ultrazohm/uz_d_inverter/Bestellliste_Mouser.xlsx

Bestellliste bei Mouser
 |  |  | Anzahl Boards
 |  |  | 15
Bauteilnummer | Beschreibung | Anzahl pro Board | Anzahl insgesamt | Kommentar | Kosten pro Bauteil: | Kosten pro Board: |  | Eingetroffen:
581-1206DD106MAT2A | Capacitor 1206, 35 VDC, 10 µF, X5R | 1 | 15 |  | 0.29 € | 0.29 € | 4.35 € | JA
80-C0603C105K3RLR | Capacitor 0603, 25 VDC, 1 µF, X7R | 1 | 15 |  | 0.28 € | 0.28 € | 4.20 € | JA
80-C0603C104J3RE7411 | Capacitor 0603, 25 VDC, 0.1 µF, X7R | 17 | 255 |  | 0.26 € | 4.42 € | 66.30 € | JA
187-CL10C560JB8NNNC | Capacitor 0603, 50 VDC, 56 pF, C0G | 16 | 240 |  | 0.10 € | 1.60 € | 24.00 € | JA
80-C0805C472F1GEAULR | Capacitor 0805, 100 VDC, 4.7 nF, C0G | 4 | 60 |  | 1.39 € | 5.56 € | 83.40 € | JA
80-C0805C332F1G | Capacitor 0805, 100 VDC, 3.3 nF, C0G | 4 | 60 |  | 2.64 € | 10.56 € | 158.40 € | JA
80-C0805C103K3R | Capacitor 0805, 25 VDC, 0.01 µF, X7R | 6 | 90 |  | 0.23 € | 1.38 € | 20.70 € | JA
80-C603C104K5RAC3121 | Capacitor 0603, 50 VDC, 100nF, X7R | 16 | 240 |  | 0.13 € | 2.08 € | 31.20 € | JA
710-885012206065 | Capacitor 0603, 25 VDC, 10 nF, X7R | 7 | 105 | Wurden ausversehen 240 bestellt | 0.10 € | 0.70 € | 10.50 € | JA
667-EEV-FK2A470V | 13.8 x 12.5 x 3.8mm, 100 VDC, 47µF | 10 | 150 |  | 2.94 € | 29.40 € | 441.00 € | JA
810-C2012X7R475K125C | Capacitor 0805, 50 VDC, 4.7 µF, X7R | 12 | 180 |  | 0.57 € | 6.84 € | 102.60 € | JA
810-C1608X5R1E225K | Capacitor 0603, 25 VDC, 2.2 uF, X5R | 6 | 90 |  | 0.19 € | 1.14 € | 17.10 € | JA
187-CL10B473KB8NNNC | Capacitor 0603, 50 VDC, 47 nF, X7R | 18 | 270 |  | 0.10 € | 1.80 € | 27.00 € | JA
710-150060BS84000 | WL-SMCW SMD Mono-color Chip LED Waterclear Blue | 1 | 15 |  | 0.45 € | 0.45 € | 6.75 € | JA
710-150060GS84000 | WL-SMCW SMD Mono-color Chip LED Waterclear Green | 1 | 15 |  | 0.45 € | 0.45 € | 6.75 € | JA
710-150060RS86000 | WL-SMCW SMD Mono-color Chip LED Waterclear Red | 1 | 15 |  | 0.45 € | 0.45 € | 6.75 € | JA
595-REF4132B25DBVRQ1 | Voltage Reference, 2.5V, ±0.05%, ±10mA | 1 | 15 |  | 3.72 € | 3.72 € | 55.80 € | JA
595-LMP8481MM-T/NOPB | Current Sense Amplifier, 4-76 V CMV, 20 V/V, bidirectional | 3 | 45 |  | 3.57 € | 10.71 € | 160.65 € | JA
584-ADA4940-1ARZ | Fully Differential Amplifier, Ultralow-Power,Low Distortion, 260-MHz | 8 | 120 |  | 5.14 € | 41.12 € | 616.80 € | JA
926-LM57CISD-10/NOPB | Board Mount Temperature Sensor, -50 - 150°C | 6 | 90 |  | 2.76 € | 16.56 € | 248.40 € | JA
584-6992HS64WTRMPBF | Switching Controllers PWM with 5% to 100% Pulse Width Control | 6 | 90 | 1500 Stück sind ab Oktober verfügbar. Vorbestellen den Artikel dann. | 6.81 € | 40.86 € | 612.90 €
595-INA185A1IDRLR | Current Sense Amplifier, 0-26 V CMV, 20 V/V, bidirectional | 1 | 15 |  | 1.61 € | 1.61 € | 24.15 € | JA
595-SN74LVC2G14DBVT | Dual Schmitt Trigger Inverter | 1 | 15 |  | 1.32 € | 1.32 € | 19.80 €
710-634008149821 | CAT5, RJ45 Connector, 1 port SMD | 2 | 30 |  | 8.22 € | 16.44 € | 246.60 € | JA
571-4-103327-3 | Pin Header, 2.54mm, 1 Pin | 6 | 90 |  | 0.25 € | 1.50 € | 22.50 € | JA
81-LQM18DN6R8M70L | 6.8µH, 120mA, 0603, 740mOhm, 20% | 6 | 90 |  | 0.14 € | 0.84 € | 12.60 € | JA
490-PDSE1-S24-S12MTR | Isolated, 21.6 -26.4Vin, 12V out, 1W, 84mA out | 6 | 90 |  | 3.67 € | 22.02 € | 330.30 € | JA
603-RC0603JR-070RL | SMD resistor E24 series | 3 | 45 |  | 0.10 € | 0.30 € | 4.50 € | JA
660-RK73B1JTTDD102J | SMD resistor E24 series, SMD resistor 0.1% | 17 | 255 |  | 0.10 € | 1.70 € | 25.50 € | JA
660-RK73B1JTTDD202J | SMD resistor E24 series, SMD resistor 0.1% | 17 | 255 |  | 0.10 € | 1.70 € | 25.50 € | JA
660-RK73B1JTTD201J | SMD resistor E24 series | 1 | 15 |  | 0.10 € | 0.10 € | 1.50 € | JA
660-RK73B1JTTD101J | SMD resistor E24 series | 1 | 15 |  | 0.10 € | 0.10 € | 1.50 € | JA
603-PU3921FKMP50R002 | Shunt resistor 2mOhm, 5W, 1% | 4 | 60 |  | 1.60 € | 6.40 € | 96.00 € | JA
660-RK73H1JTTD49R9F | SMD resistor 1% | 20 | 300 |  | 0.10 € | 2.00 € | 30.00 € | JA
603-RT0603BRD0751R1L | SMD resistor 0.1% | 5 | 75 |  | 0.38 € | 1.90 € | 28.50 € | JA
603-RT0603BRD0725R2L | SMD resistor 0.1% | 4 | 60 |  | 0.42 € | 1.68 € | 25.20 € | JA
279-RQ73C1J10KBTD | SMD resistor 0.1%, 10ppm | 4 | 60 |  | 0.69 € | 2.76 € | 41.40 € | JA
279-RQ73C1J110KBTD | SMD resistor 0.1%, 10ppm | 4 | 60 |  | 0.81 € | 3.24 € | 48.60 € | JA
660-RK73B1JTTD103J | SMD resistor E24 series | 18 | 270 |  | 0.10 € | 1.80 € | 27.00 € | JA
660-RK73B1JTTD203J | SMD resistor E24 series | 6 | 90 |  | 0.10 € | 0.60 € | 9.00 € | JA
652-CR0603-FX1053ELF | SMD resistor 1%, 50V, 100ppm | 6 | 90 |  | 0.10 € | 0.60 € | 9.00 € | JA
652-CR0603-FX2803ELF | SMD resistor 1%, 50V, 100ppm | 6 | 90 |  | 0.10 € | 0.60 € | 9.00 € | JA
667-ERJ-6ENF2873V | SMD resistor 1%,150 V, 100ppm | 6 | 90 |  | 0.10 € | 0.60 € | 9.00 € | JA
652-CR0603FX-9763ELF | SMD resistor 1%, 50V, 100ppm | 6 | 90 |  | 0.10 € | 0.60 € | 9.00 € | JA
652-CR0603FX-1823ELF | SMD resistor 1%, 50V, 100ppm | 6 | 90 |  | 0.10 € | 0.60 € | 9.00 € | JA
660-RK73B1JTTD100J | SMD resistor E24 series | 2 | 30 |  | 0.10 € | 0.20 € | 3.00 € | JA
594-MMA02040E1009DB3 | SMD MELF resistor, 0.5%, 200V, 15ppm | 12 | 180 |  | 0.65 € | 7.80 € | 117.00 € | JA
 |  |  |  |  |  | Preis pro Board | Preis insgesamt
 |  |  |  |  |  | 259.38 € | 3890.70 €
