ultrazohm/uz_d_inverter/Bestellliste_Farnell.xlsx

Bestellliste bei Farnell
 |  |  | Anzahl Boards
 |  |  | 15
Bauteilnummer | Beschreibung | Anzahl pro Board | Anzahl insgesamt | Kommentar | Kosten pro Bauteil: | Kosten pro Board:
FCR7350R | FCR7350B, 1000V, 24A, RED | 1 | 15 |  | 5.40 € | 5.40 € | 81.00 €
FCR7350L | FCR7350B, 1000V, 24A, BLUE | 1 | 15 |  | 5.40 € | 5.40 € | 81.00 €
FCR7350B | FCR7350B, 1000V, 24A, BLACK | 3 | 45 |  | 5.40 € | 16.20 € | 243.00 €
 |  |  |  |  |  | Preis pro Board | Preis insgesamt
 |  |  |  |  |  | 27.00 € | 405.00 €
