ultrazohm/uz_d_inverter/Project Outputs for UZ_D_Inverter/Rev04/BOM/BOM_UZ_D_Inverter_Variant_V1_Rev04_ordering_overview.xlsx

Comment | Designator | Footprint | LCSC Part Number | Manufacturer Part Number | replaced with:
100 nF | C1, C2, C3A, C3B, C3C, C4, C6A, C6B, C6C, C17A, C17B, C17C, C19A, C19B, C19C, C20A, C20B, C20C, C22A, C22B, C22C, C23A, C23B, C23C, C24A, C24B, C24C, C57, C58, C59, C66A, C66B, C66C, C67A, C67B, C67C, C68A, C68B, C68C, C69A, C69B, C69C, C72A, C72B, C72C, C73A, C73B, C73C, C80, C80A, C80B, C80C, C82A, C82B, C82C, C83A, C83B, C83C, C84, C99 | C_0603 | C343025 | C1608X7S2A104KT000N
2.2 uF | C7, C64A, C64B, C64C, C65A, C65B, C65C | C_0603 | C2929194 | C1608X5R1E225K080AB
10 µF | C8, C81, C82, C83, C85, C86, C87, C88, C89, C90, C91, C92, C93, C94, C95, C96 | C_1210_N | C576517 | GRM32EC72A106KE05L
56 pF | C11A, C11B, C11C, C12A, C12B, C12C, C15A, C15B, C15C, C16A, C16B, C16C, C50, C51, C55, C56 | C_0603 | C39148 | CL10C560JB8NNNC
0.01 µF | C14A, C14B, C14C, C54 | C_0805 | C2691724 | HV0805X7R103K101NT | 08051C103J4Z2A | GlobalSourcing | nope
10nF | C18A, C18B, C18C, C21A, C21B, C21C, C25A, C25B, C25C, C26A, C26B, C26C | C_0603 | C136131 | CT41G-0603-2X1-50V-0.01μF-K(N)
110 µF | C40, C41, C42, C43, C44, C45, C46, C47 | CAPAE1300X1400N | C2163387 | EMHS101ARA111MKE0S
4.7 µF | C60A, C60B, C60C, C61A, C61B, C61C, C62A, C62B, C62C, C63A, C63B, C63C | C_0805 | C437557 | GRM21BZ71H475KE15L
150060BS84000 | D1 | WL-SMCW_0603 | C5197644 | 150060BS84000
150060GS84000 | D2 | WL-SMCW_0603 | C84267 | 150060GS84000
150060RS86000 | D3 | WL-SMCW_0603 | C389517 | 150060RS86000
BAT165E6327HTSA1 | DOFF_1A, DOFF_1B, DOFF_1C, DOFF_2A, DOFF_2B, DOFF_2C | SOD2513X110N |  | BAT165E6327HTSA1 | BAT165E6327 | C151511
MINIASMDC110F_24-2 | F1, F2, F3 | MINIASMDC260F162 | C70119 | MINIASMDC110F/24-2
6339160-1 | J1, J2 | 634008149821 | C125076 | 6339160-1
FCR7350R, PCB mount 4mm jack, RED | J3 | FCR7350 | C7437326 | FCR7350R
FCR7350L, PCB mount 4mm jack, BLUE | J4 | FCR7350 | C7190856 | FCR7350L
FCR7350B, PCB mount 4mm jack, BLACK | J5, J6, J7 | FCR7350 | C7437327 | FCR7350B
LQM18DN6R8M70L | L1A, L1B, L1C, L2A, L2B, L2C, L3A, L3B, L3C, L4A, L4B, L4C, L5A, L5B, L5C, L6, L7, L8, L9A, L9B, L9C, L10A, L10B, L10C, L12 | INDC1608X95N | C1881372 | LQM18DN6R8M70L
PDSE1-S24-S12-M-TR | PS1A, PS1B, PS1C, PS2A, PS2B, PS2C | PDSE1S24S12MTR | C6730719 | PDSE1-S24-S12-M-TR |  |  | nope
ISC060N10NM6ATMA1 | Q1A, Q1B, Q1C, Q2A, Q2B, Q2C | ISC060N10NM6ATMA1 | C3288847 | ISC060N10NM6ATMA1
0R | R1, R5, R9 | RES 0603_1608 | C21189 | RC0603JR-070RL
10k | R4, R21A, R21B, R21C, R23A, R23B, R23C, R28A, R28B, R28C, R29A, R29B, R29C, R39A, R39B, R39C, R43A, R43B, R43C, R44A, R44B, R44C, R45A, R45B, R45C, R46A, R46B, R46C, R61, R62, R72, R74, R130A, R130B, R130C | RES 0603_1608 | C25804, C95204 | RK73B1JTTD103J, RQ73C1J10KBTD | both C95204
20k | R6, R30A, R30B, R30C, R38A, R38B, R38C | RES 0603_1608 | C4184 | RK73B1JTTD203J
4k7 | R7, R8, R10, R11, R16, R17 | RES 0603_1608 | C23162 | 0603WAF4701T5E
2mR | R10A, R10B, R10C, R50 | 3921 | C844494 | WSL39212L000FEA
1k | R12A, R12B, R12C, R13A, R13B, R13C, R53, R54 | RES 0603_1608 | C110776 | RT0603BRD071KL
2k | R14A, R14B, R14C, R15A, R15B, R15C, R55, R56 | RES 0603_1608 | C189729 | ERJ-PB3B2001V | C318130
100k | R18, R47 | RES 0603_1608 | C25803 | RK73B1JTTD104J
49R9 | R19A, R19B, R19C, R20A, R20B, R20C, R25A, R25B, R25C, R26A, R26B, R26C, R57, R58, R67, R68 | RES 0603_1608 | C160046 | RK73H1JTTD49R9F
110k | R22A, R22B, R22C, R24A, R24B, R24C, R27A, R27B, R27C, R60, R63, R73, R75, R129A, R129B, R129C | RES 0603_1608 | C326736 | RQ73C1J110KBTD
105k | R31A, R31B, R31C, R37A, R37B, R37C | RES 0603_1608 | C141685 | CR0603-FX-1053ELF | C16840
280k | R32A, R32B, R32C, R36A, R36B, R36C | RES 0603_1608 | C861797 | CR0603-FX-2803ELF
287k | R33A, R33B, R33C, R40A, R40B, R40C | RES 0805_2012 | C228683 | ERJ-6ENF2873V | C17598
976k | R34A, R34B, R34C, R42A, R42B, R42C | RES 0603_1608 | C162980 | CR0603-FX-9763ELF
182k | R35A, R35B, R35C, R41A, R41B, R41C | RES 0603_1608 | C203368 | CR0603-FX-1823ELF
12R | RG_OFF_1A, RG_OFF_1B, RG_OFF_1C, RG_OFF_2A, RG_OFF_2B, RG_OFF_2C | RES 1206_3216 | C17913 | RT0603BRD0712RL |  |  | nope
47R | RG_ON_1A, RG_ON_1B, RG_ON_1C, RG_ON_2A, RG_ON_2B, RG_ON_2C | RES 1206_3216 | C2759134 | RT0603BRD0747RL |  |  | nope
M24C02-WMN6TP | U1 | D0008A_N | C7562 | M24C02-WMN6TP
INA241A2IDGKR | U2A, U2B, U2C, U11 | SOP65P490X110-8N |  | INA241A2IDGKR
ADA4940-1ARZ-R7 | U3A, U3B, U3C, U4A, U4B, U4C, U10, U12 | SOT127P600X175-8N | C730049 | ADA4940-1ARZ-R7
LM57CISD-5/NOPB | U5A, U5B, U5C, U9A, U9B, U9C | SON50P250X250X80-9N | C2864092 | LM57CISD-5/NOPB
LTC6992CS6-1#TRMPBF | U6A, U6B, U6C, U8A, U8B, U8C | SOT95P280X100-6N | C581034 | LTC6992CS6-1#TRMPBF
2EDF7275KXUMA2 | U7A, U7B, U7C | 2EDF7275KXUMA1 | C2975252 | 2EDF7275KXUMA2
SN74LVC2G14DBVR | U13 | SOT95P280X145-6N | C12401 | SN74LVC2G14DBVR
REF4132B25DBVRQ1 | U14 | SOT95P280X145-5N | C2871658 | REF4132B25DBVRQ1
4.7 uF | C64A, C64B, C64C, C65A, C65B, C65C | C_0603 | C3858973 | C1608JB1V475M080AC |  |  | nope
