ultrazohm/uz_d_inverter/UZ_D_Inverter_Schematics.pdf

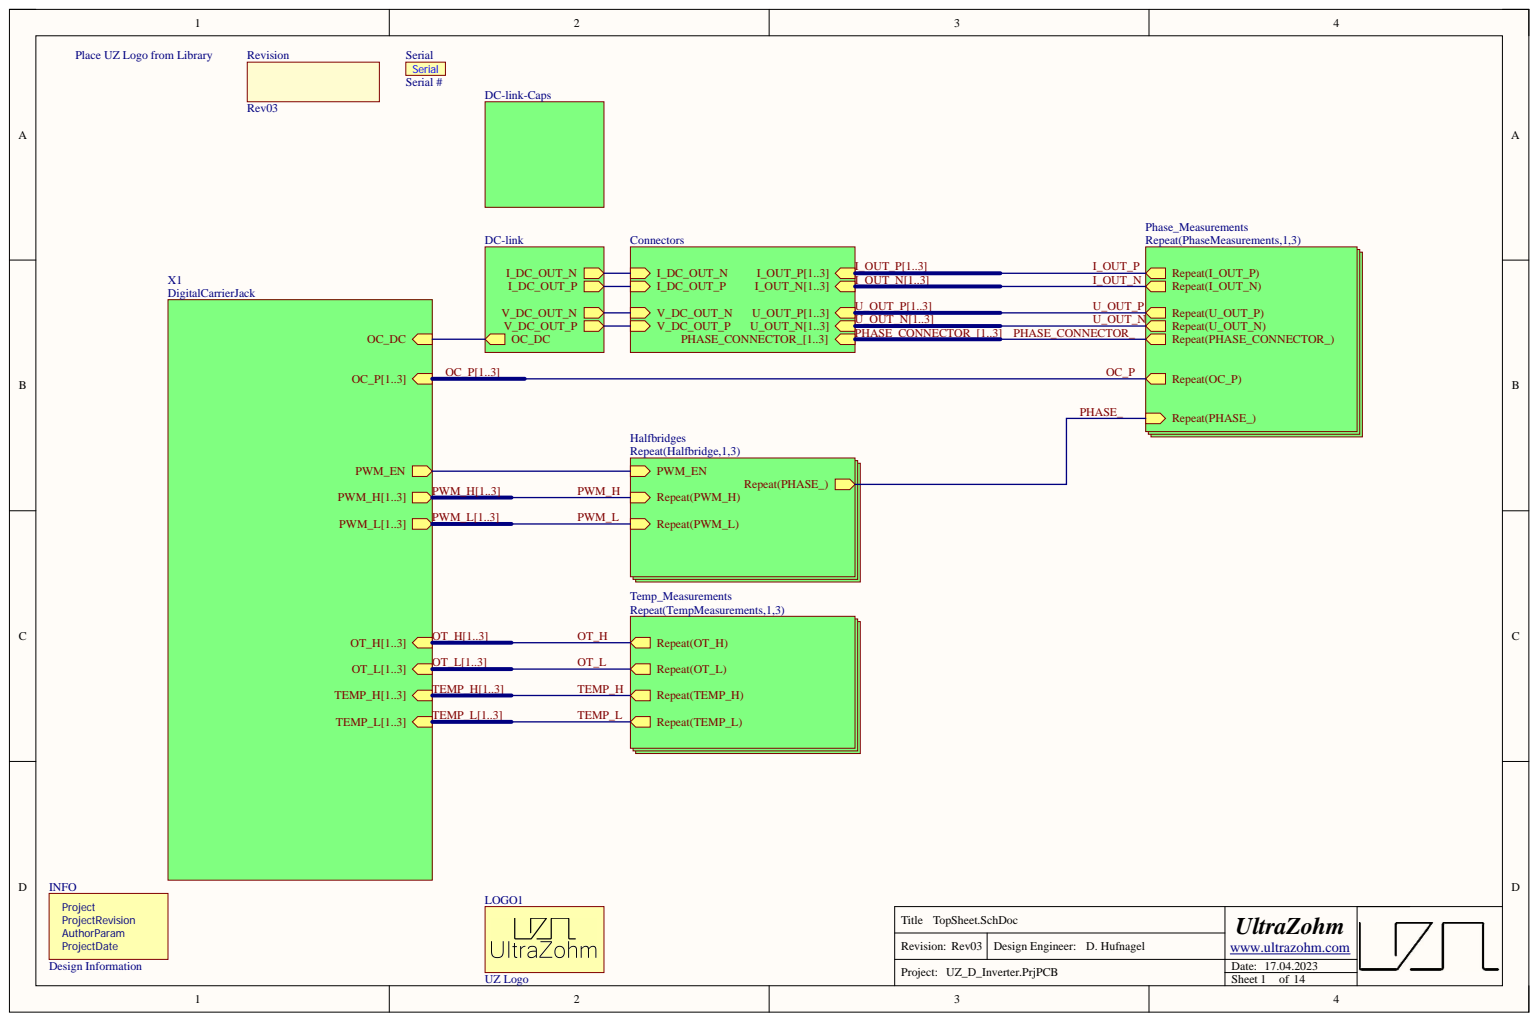
[picture p1: page 1]

Place UZ Logo from Library

Revision:

Date: 17.04.2023

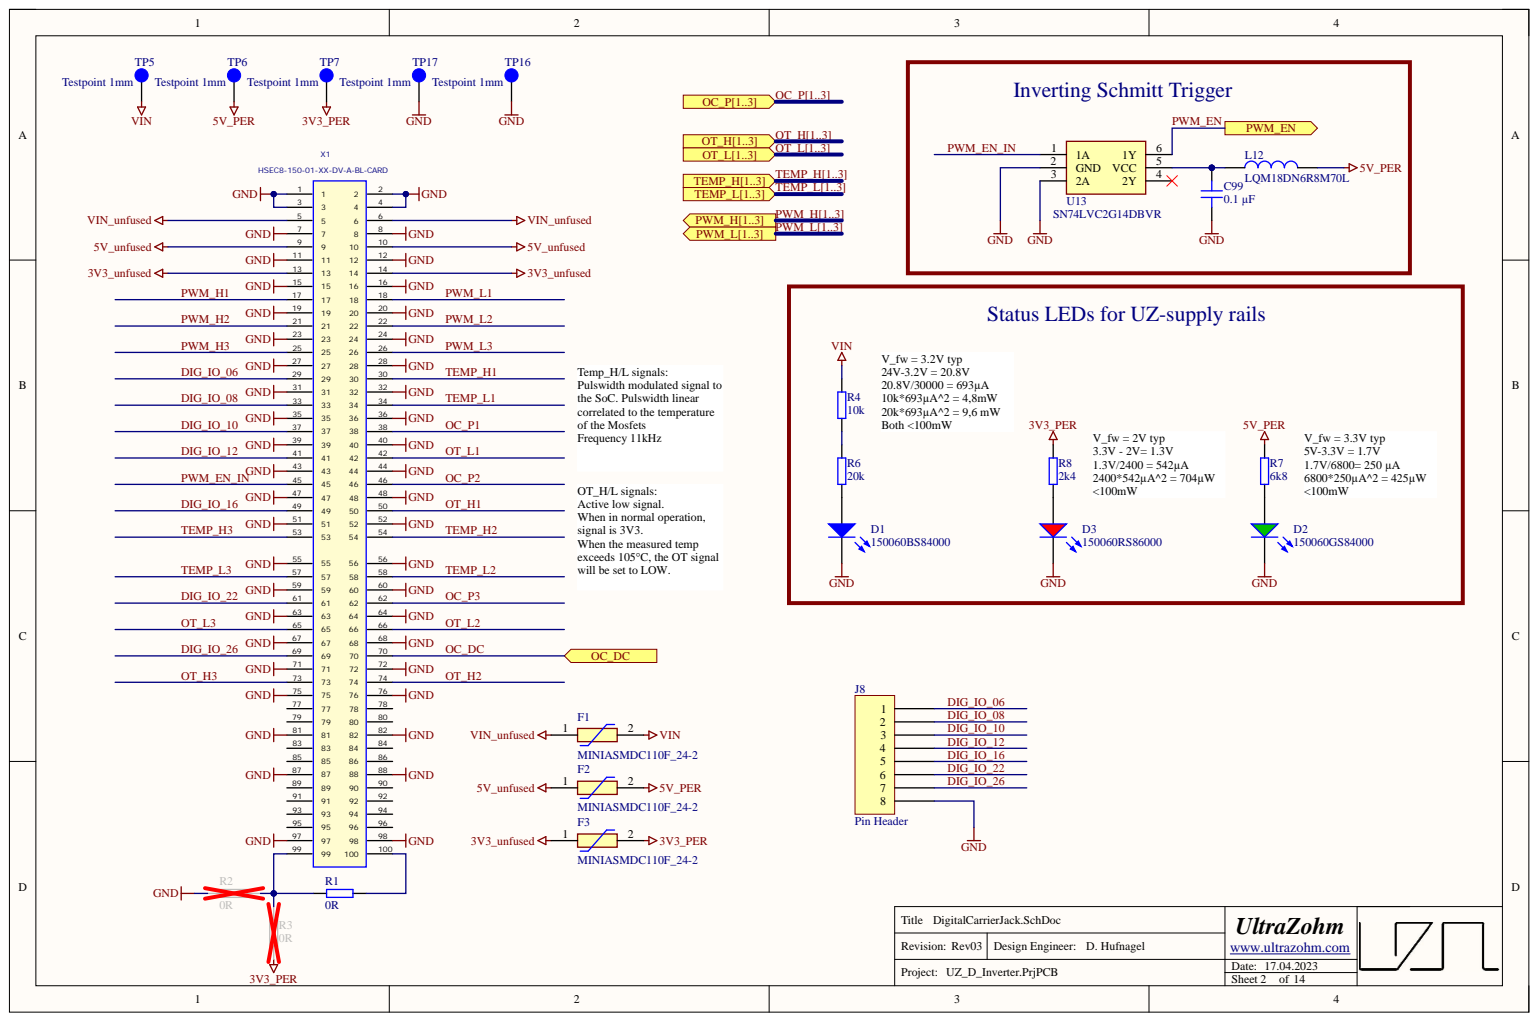
[picture p2: page 2]

HSEC8-150-01-XX-DV-A-BL-CARD

Status LEDs for UZ-supply rails

Temp_H/L signals:
Pulswidth modulated signal to
the SoC. Pulswidth linear
correlated to the temperature
of the Mosfets
Frequency 11kHz

OT_H/L signals:
Active low signal.
When in normal operation,
signal is 3V3.
When the measured temp
exceeds 105°C, the OT signal
will be set to LOW.

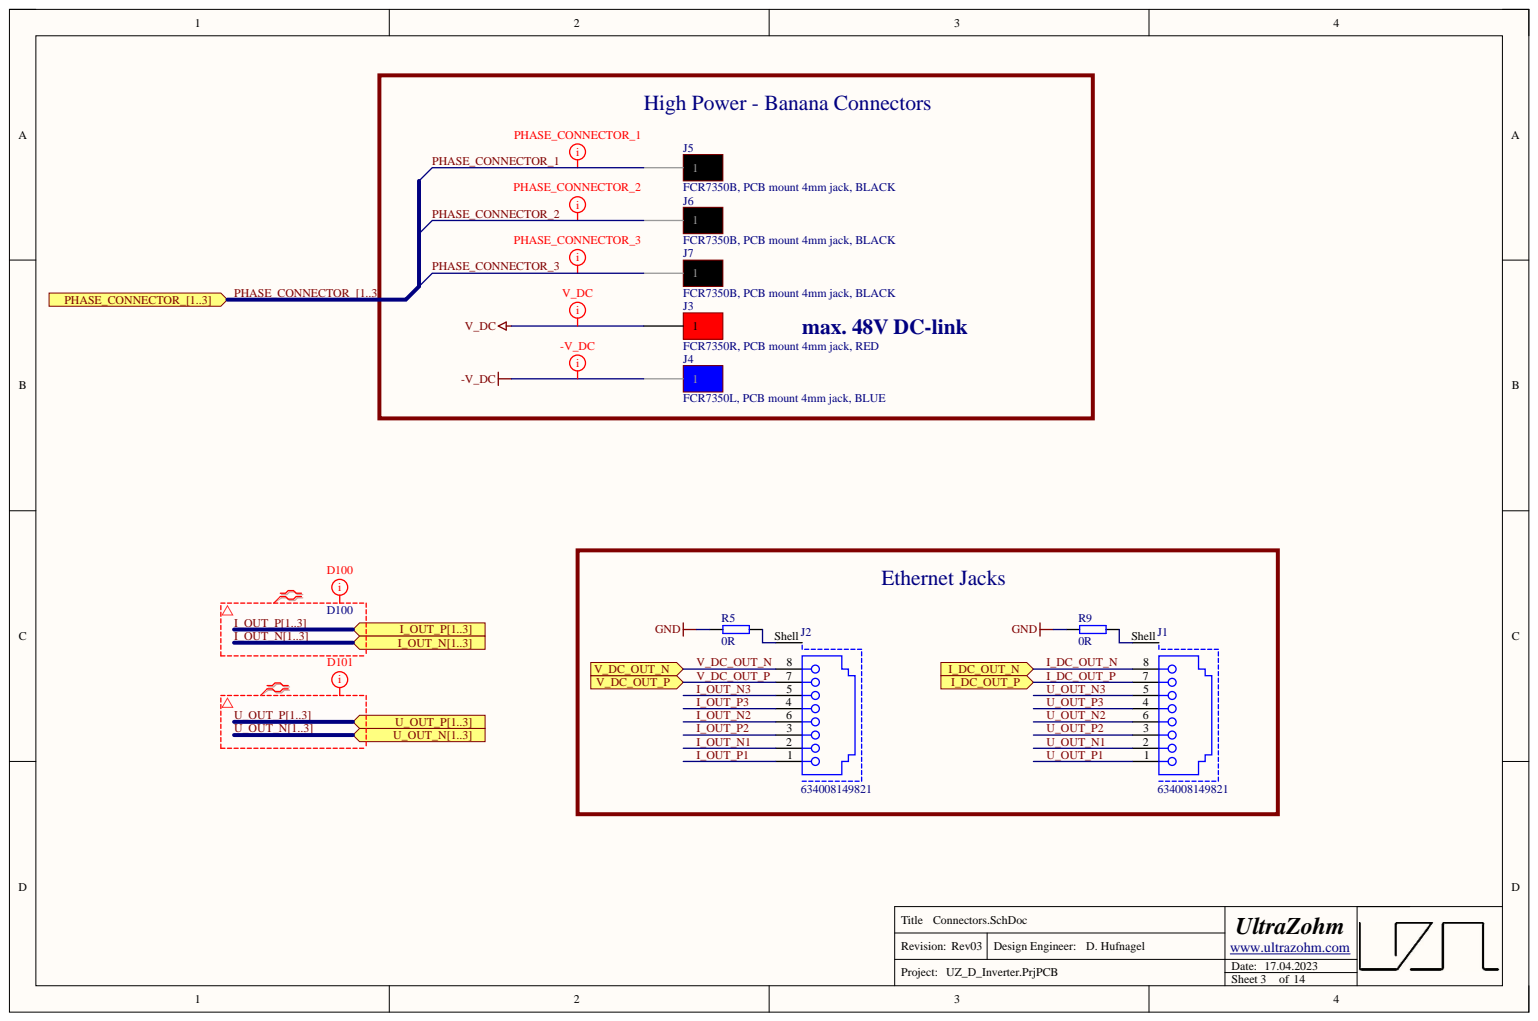
[picture p3: page 3]

High Power - Banana Connectors

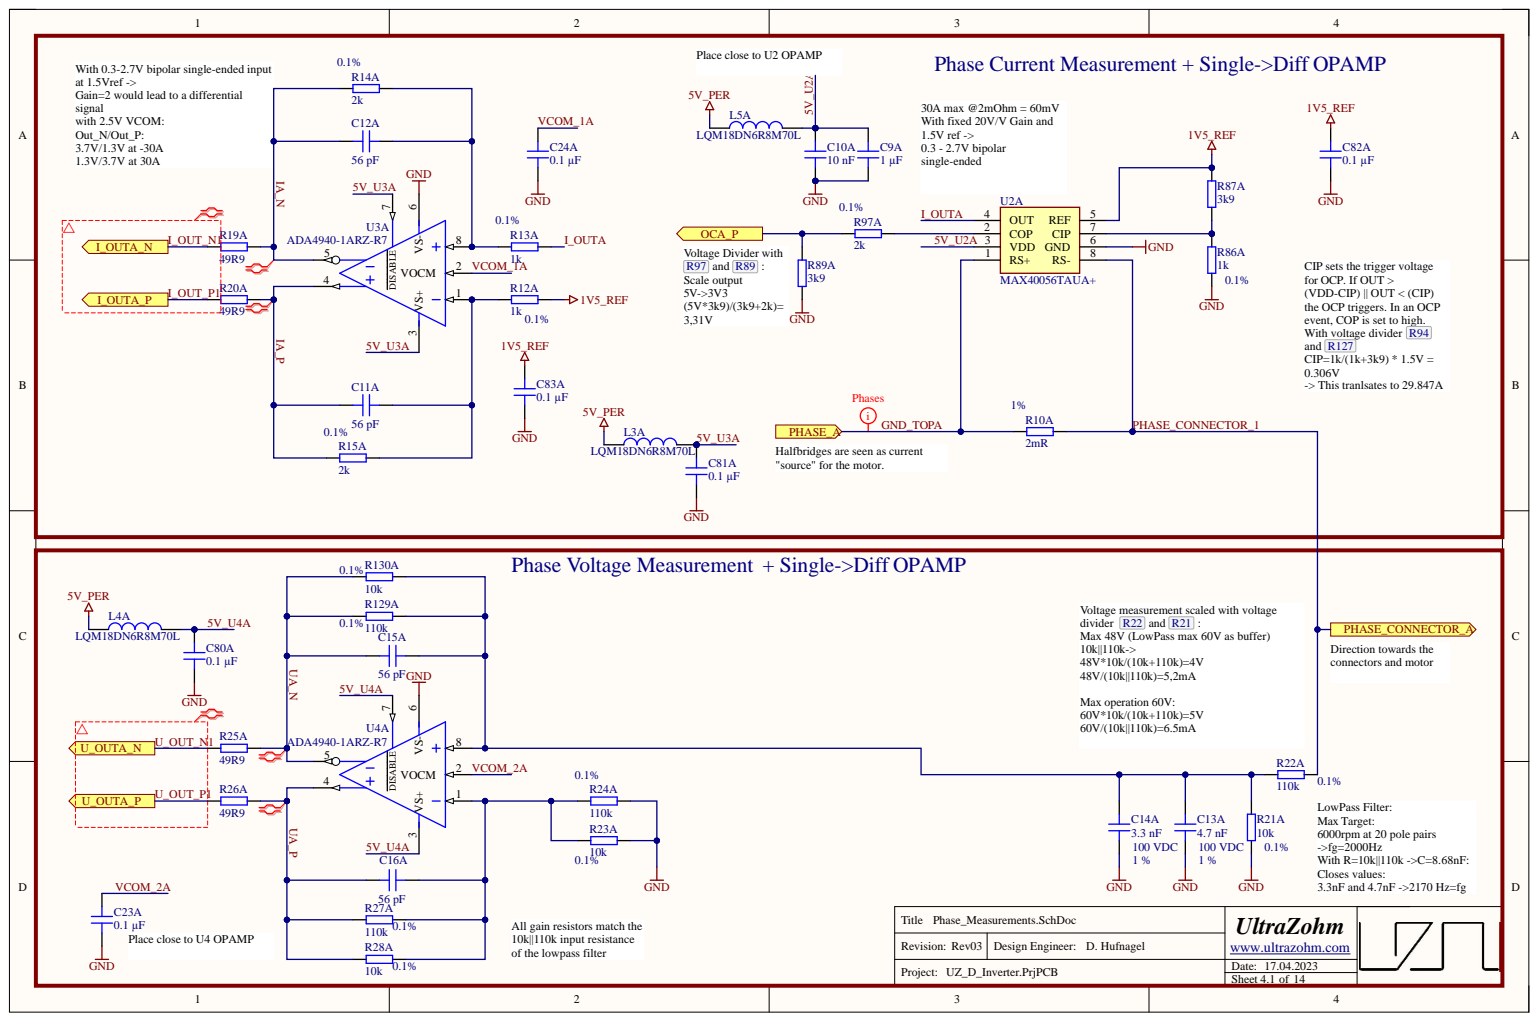
[picture p4: page 4]

Place close to U2 OPAMP

Phase Current Measurement + Single->Diff OPAMP

With 0.3-2.7V bipolar single-ended input
at 1.5Vref ->
Gain=2 would lead to a differential
signal
with 2.5V VCOM:
Out_N/Out_P:

CIP sets the trigger voltage
for OCP. If OUT >
(VDD-CIP) || OUT < (CIP)
the OCP triggers. In an OCP
event, COP is set to high.
With voltage divider R94
and R127
CIP=1k/(1k+3k9) * 1.5V =
-> This tranlsates to 29.847A

Halfbridges are seen as current
"source" for the motor.

Voltage measurement scaled with voltage
divider R22 and R21 :
Max 48V (LowPass max 60V as buffer)

All gain resistors match the
10k||110k input resistance
of the lowpass filter

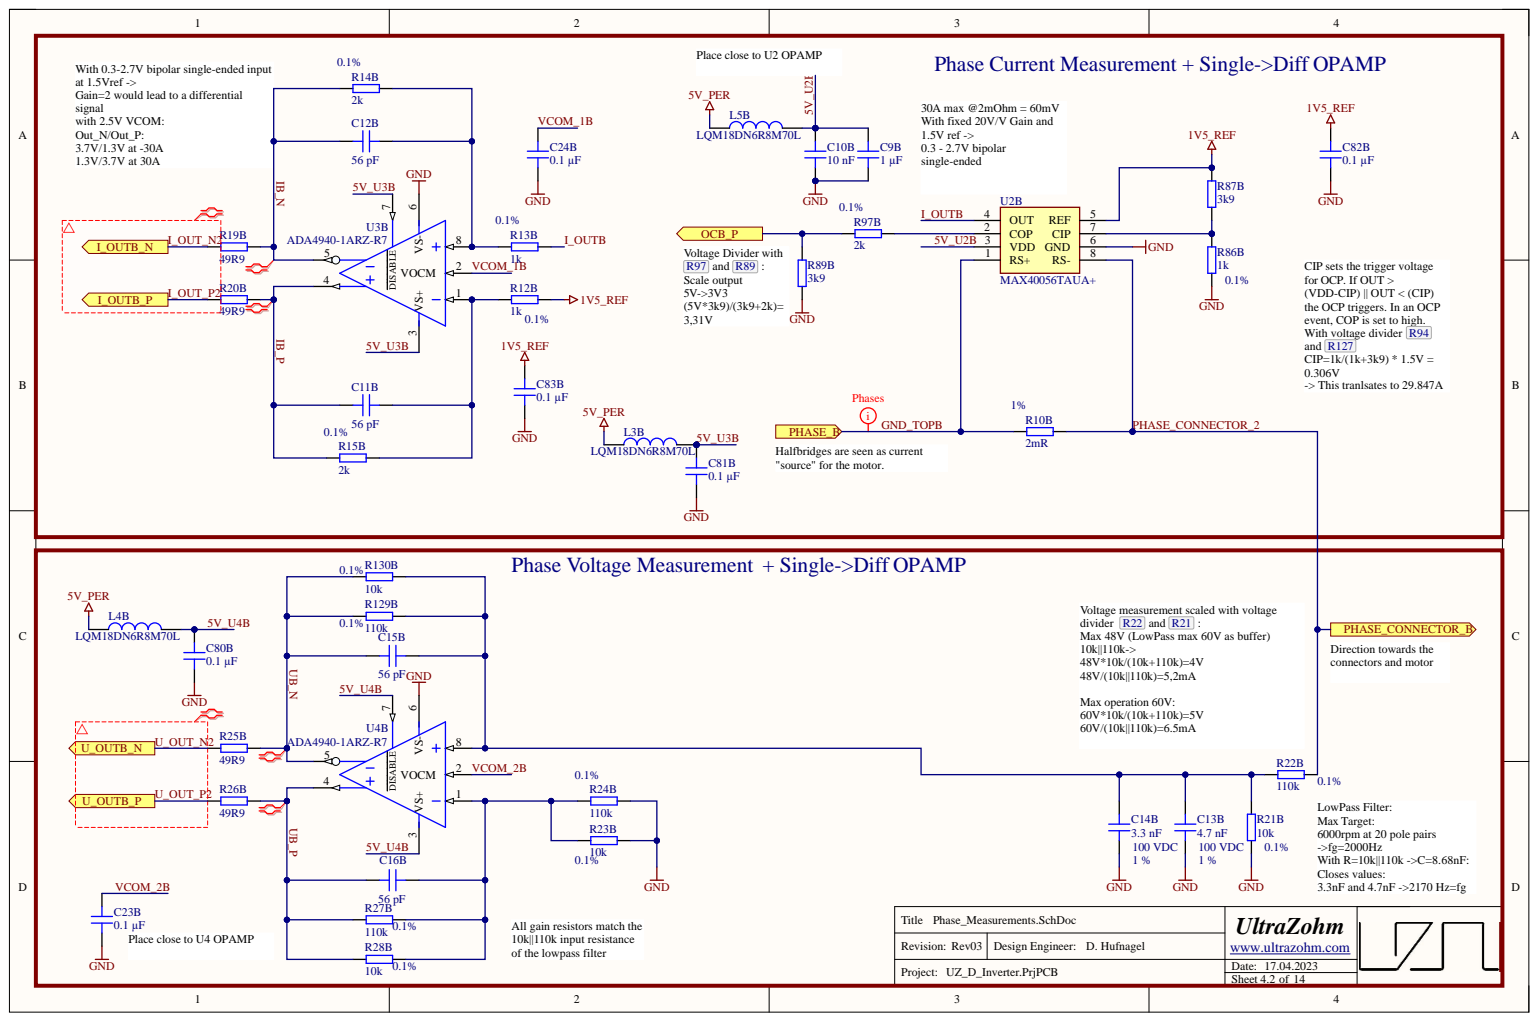
[picture p5: page 5]

Place close to U2 OPAMP

Phase Current Measurement + Single->Diff OPAMP

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

Halfbridges are seen as current
"source" for the motor.

Voltage measurement scaled with voltage
divider R22 and R21 :
Max 48V (LowPass max 60V as buffer)

All gain resistors match the
10k||110k input resistance
of the lowpass filter

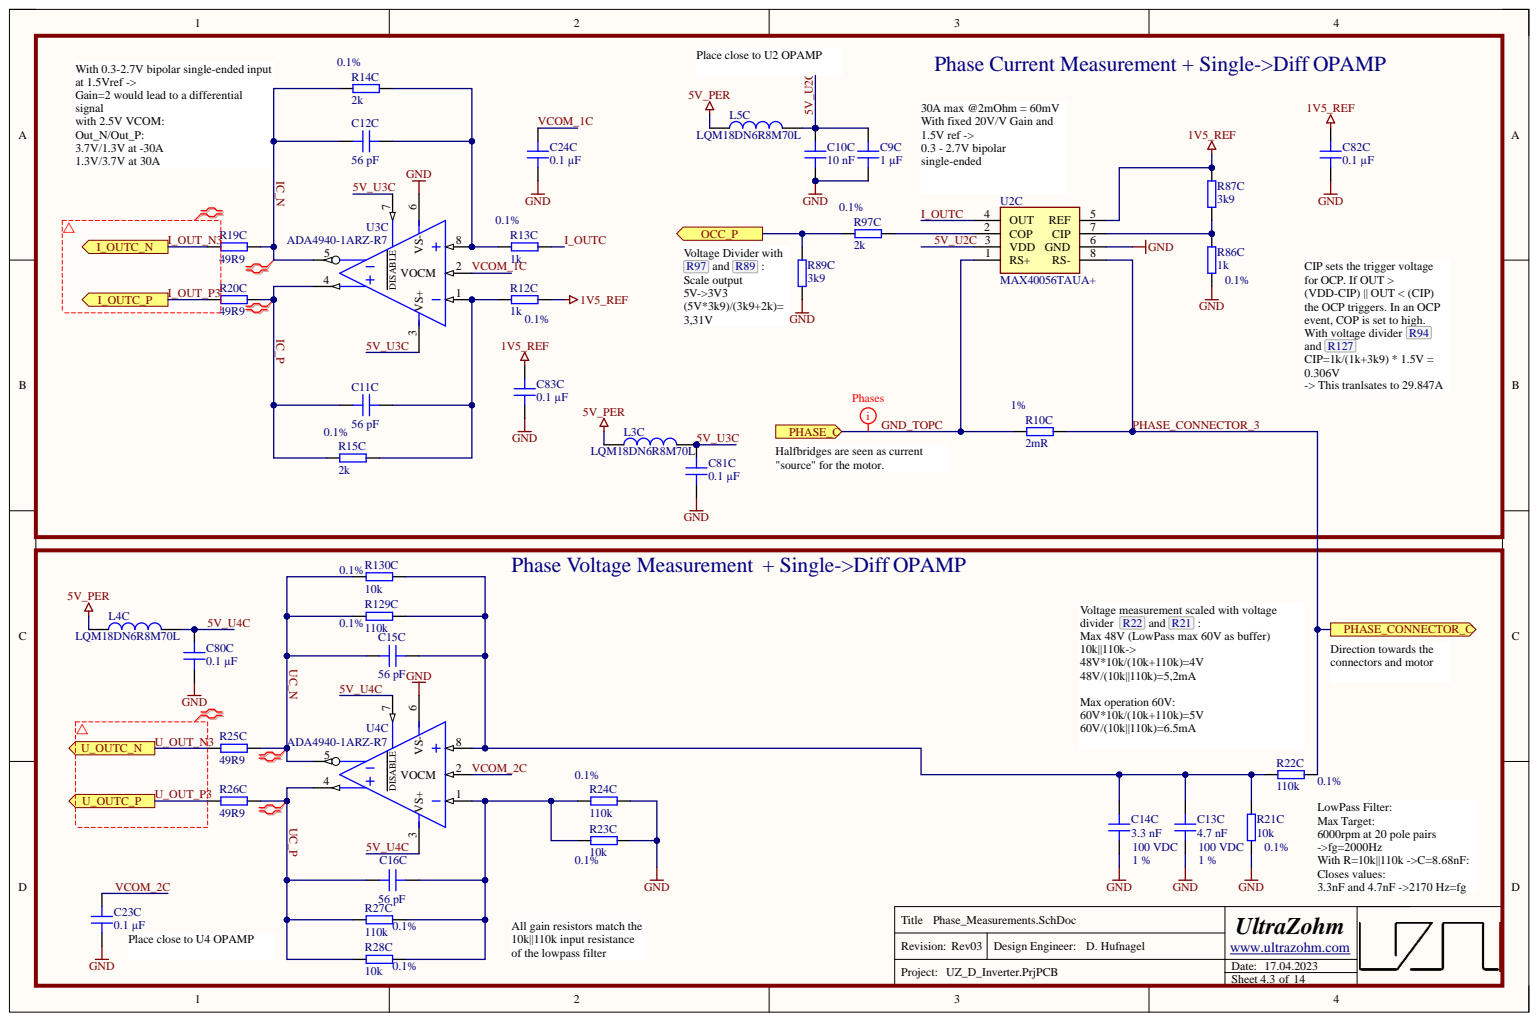
[picture p6: page 6]

Place close to U2 OPAMP

Phase Current Measurement + Single->Diff OPAMP

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

Halfbridges are seen as current
"source" for the motor.

Voltage measurement scaled with voltage
divider R22 and R21 :
Max 48V (LowPass max 60V as buffer)

All gain resistors match the
10k||110k input resistance
of the lowpass filter

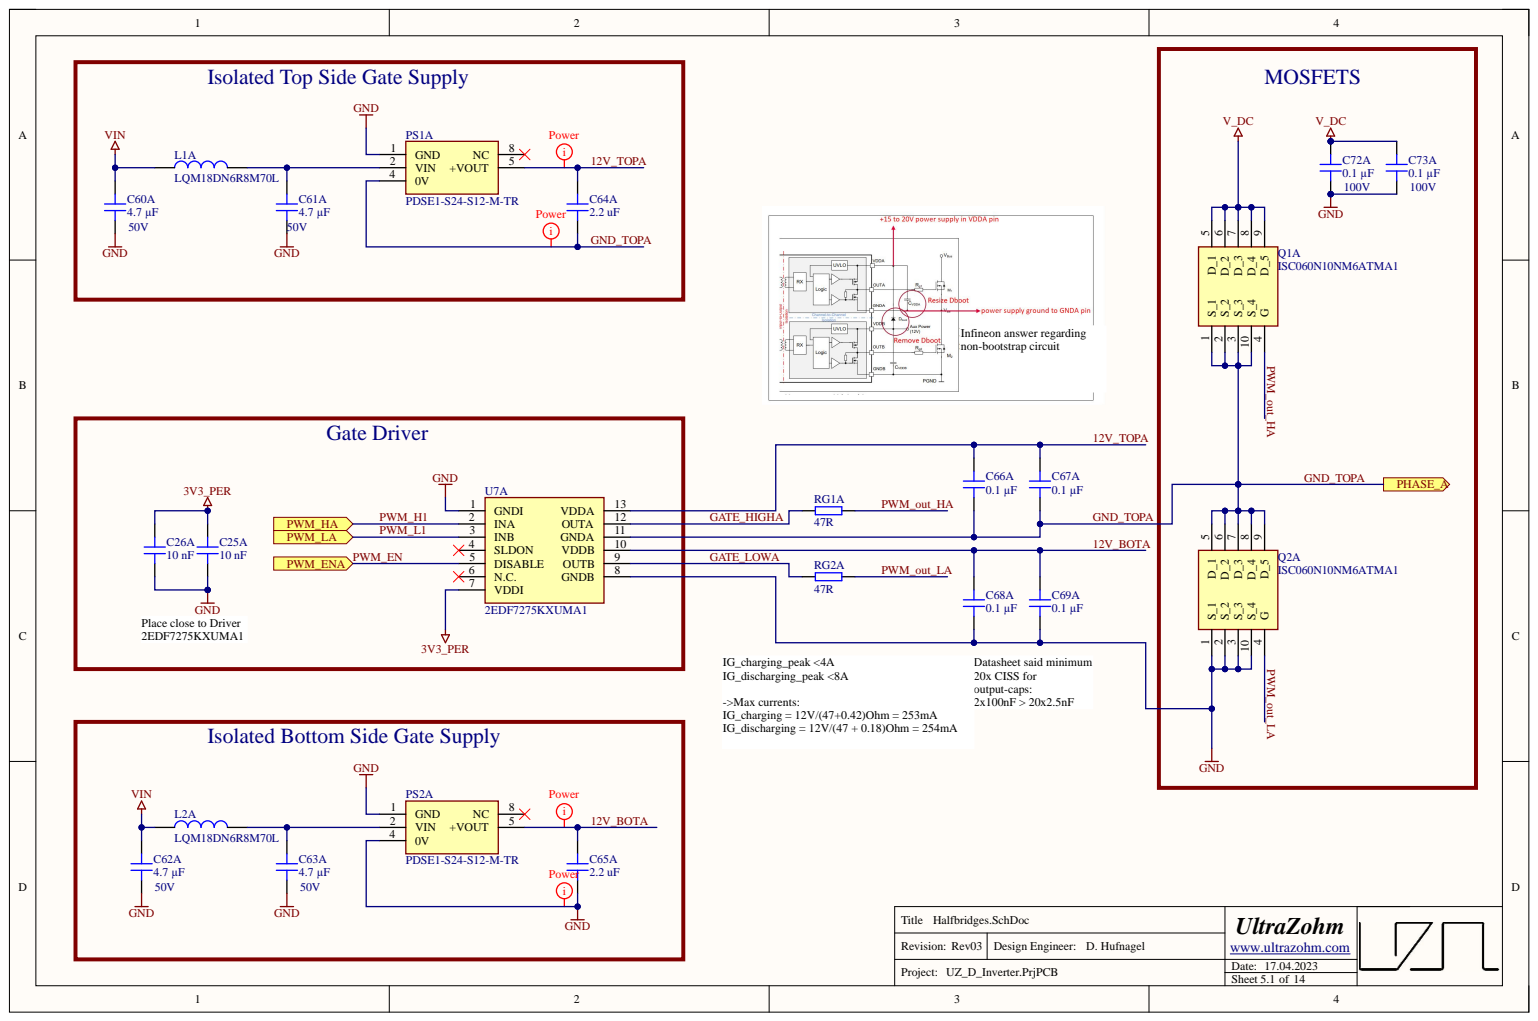
[picture p7: page 7]

Isolated Top Side Gate Supply

Place close to Driver
2EDF7275KXUMA1

Isolated Bottom Side Gate Supply

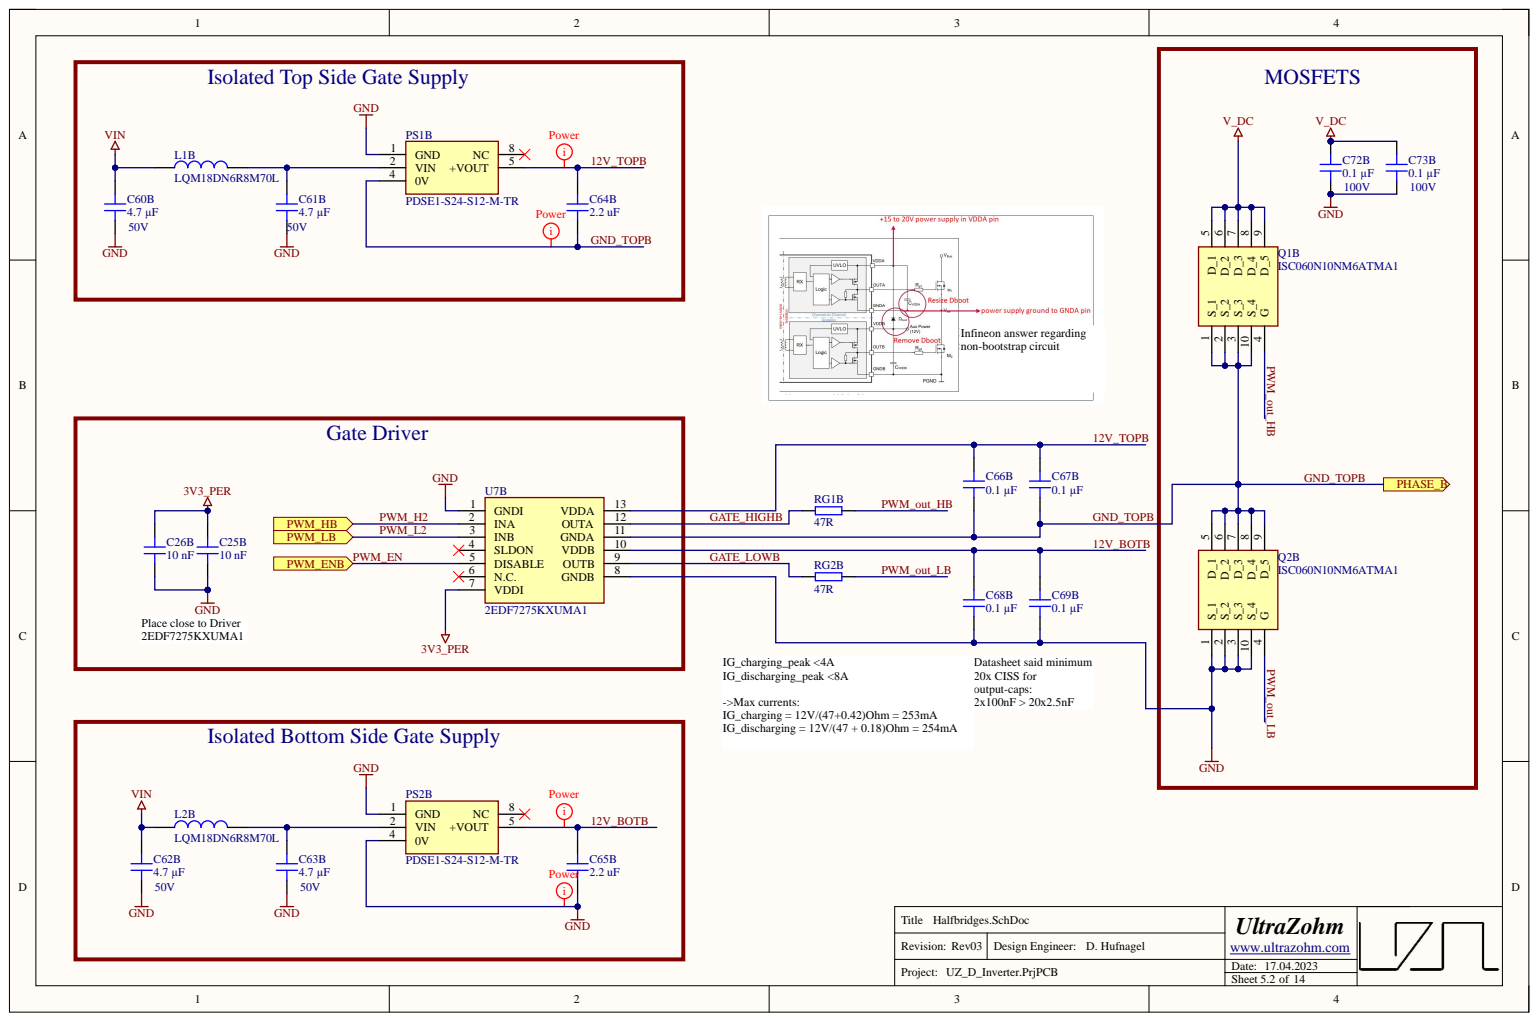
[picture p8: page 8]

Isolated Top Side Gate Supply

Place close to Driver
2EDF7275KXUMA1

Isolated Bottom Side Gate Supply

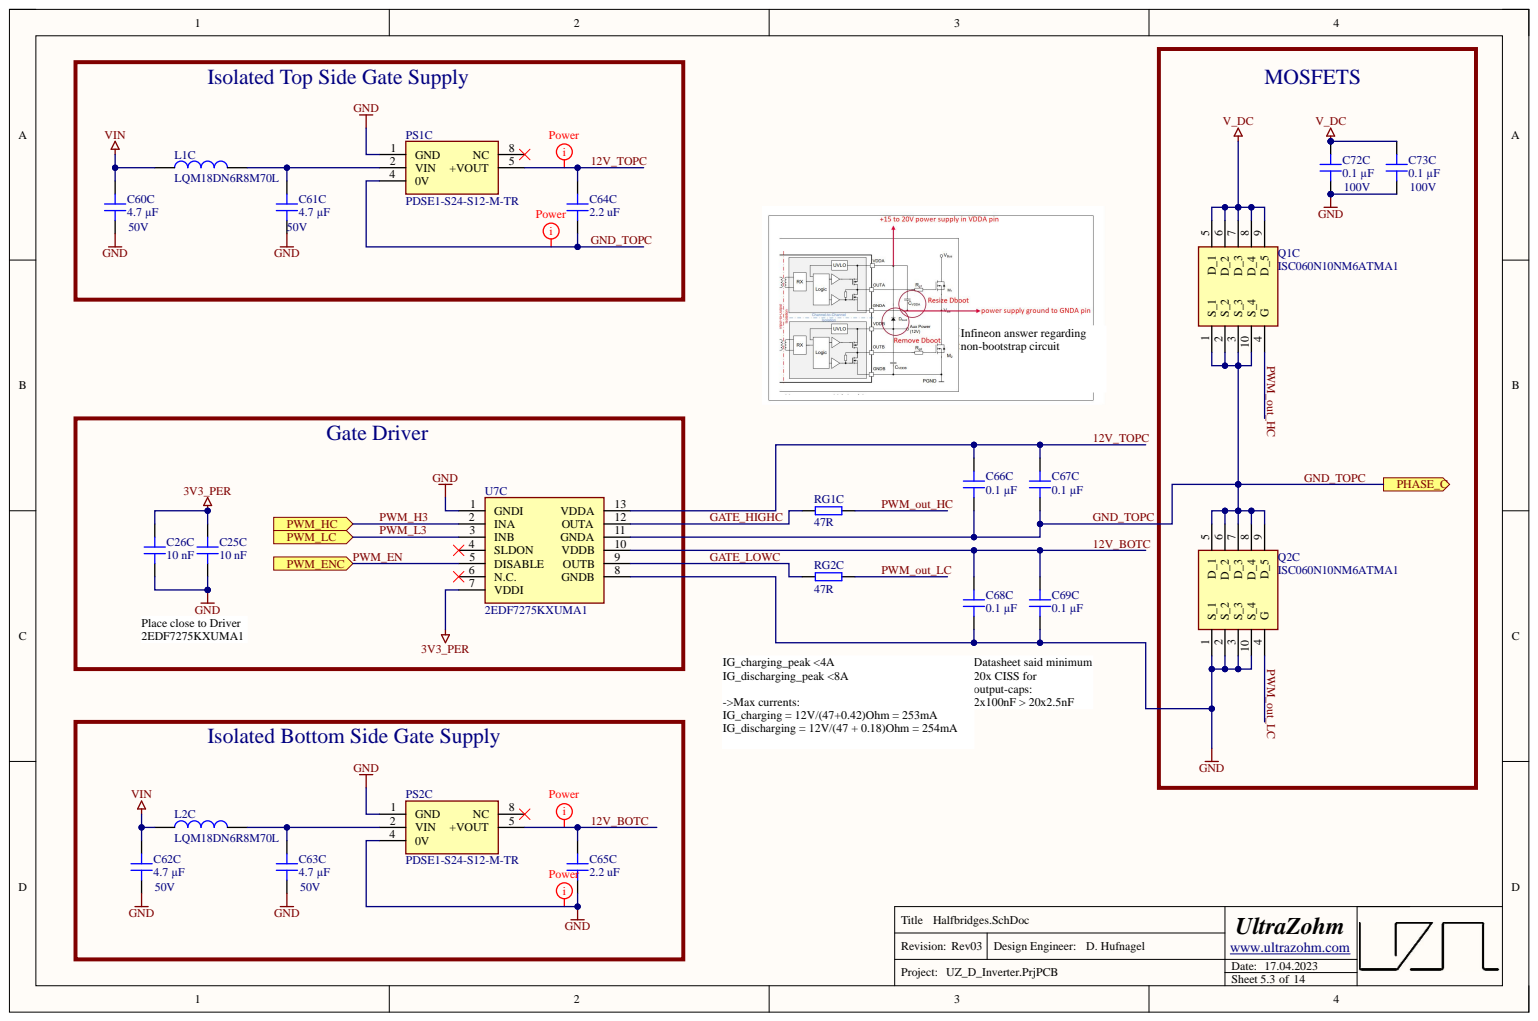
[picture p9: page 9]

Isolated Top Side Gate Supply

Place close to Driver
2EDF7275KXUMA1

Isolated Bottom Side Gate Supply

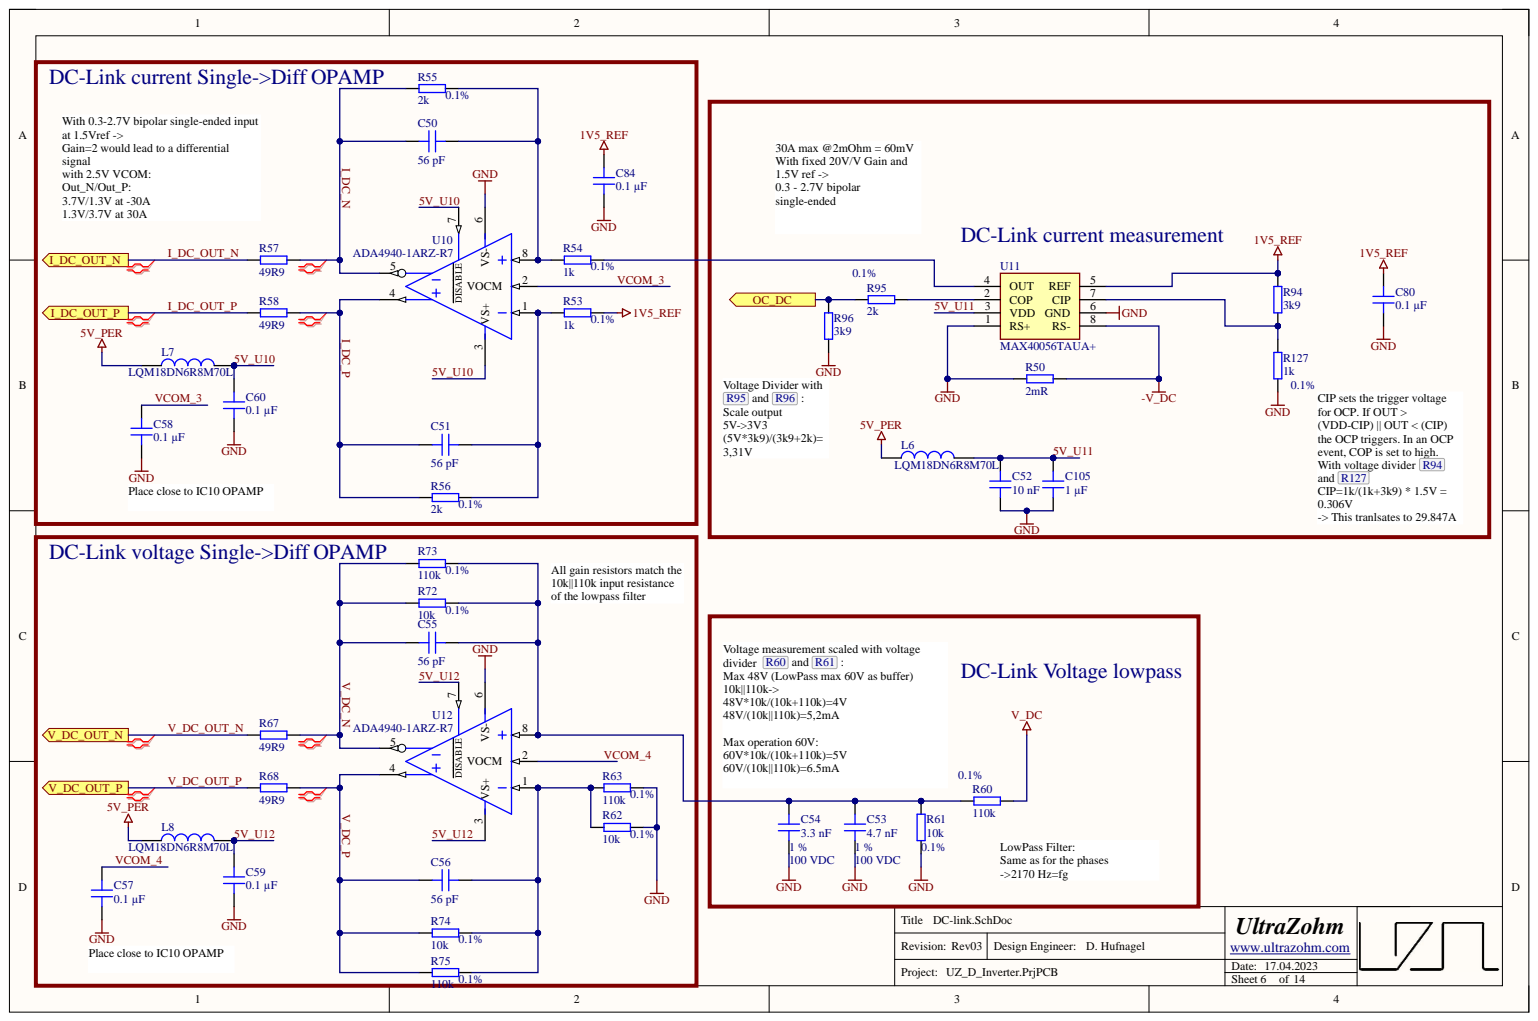
[picture p10: page 10]

DC-Link current Single->Diff OPAMP

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

DC-Link current measurement

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

GND
Place close to IC10 OPAMP

DC-Link voltage Single->Diff OPAMP

All gain resistors match the
10k||110k input resistance
of the lowpass filter

Voltage measurement scaled with voltage
divider R60 and R61 :
Max 48V (LowPass max 60V as buffer)

DC-Link Voltage lowpass

LowPass Filter:
Same as for the phases

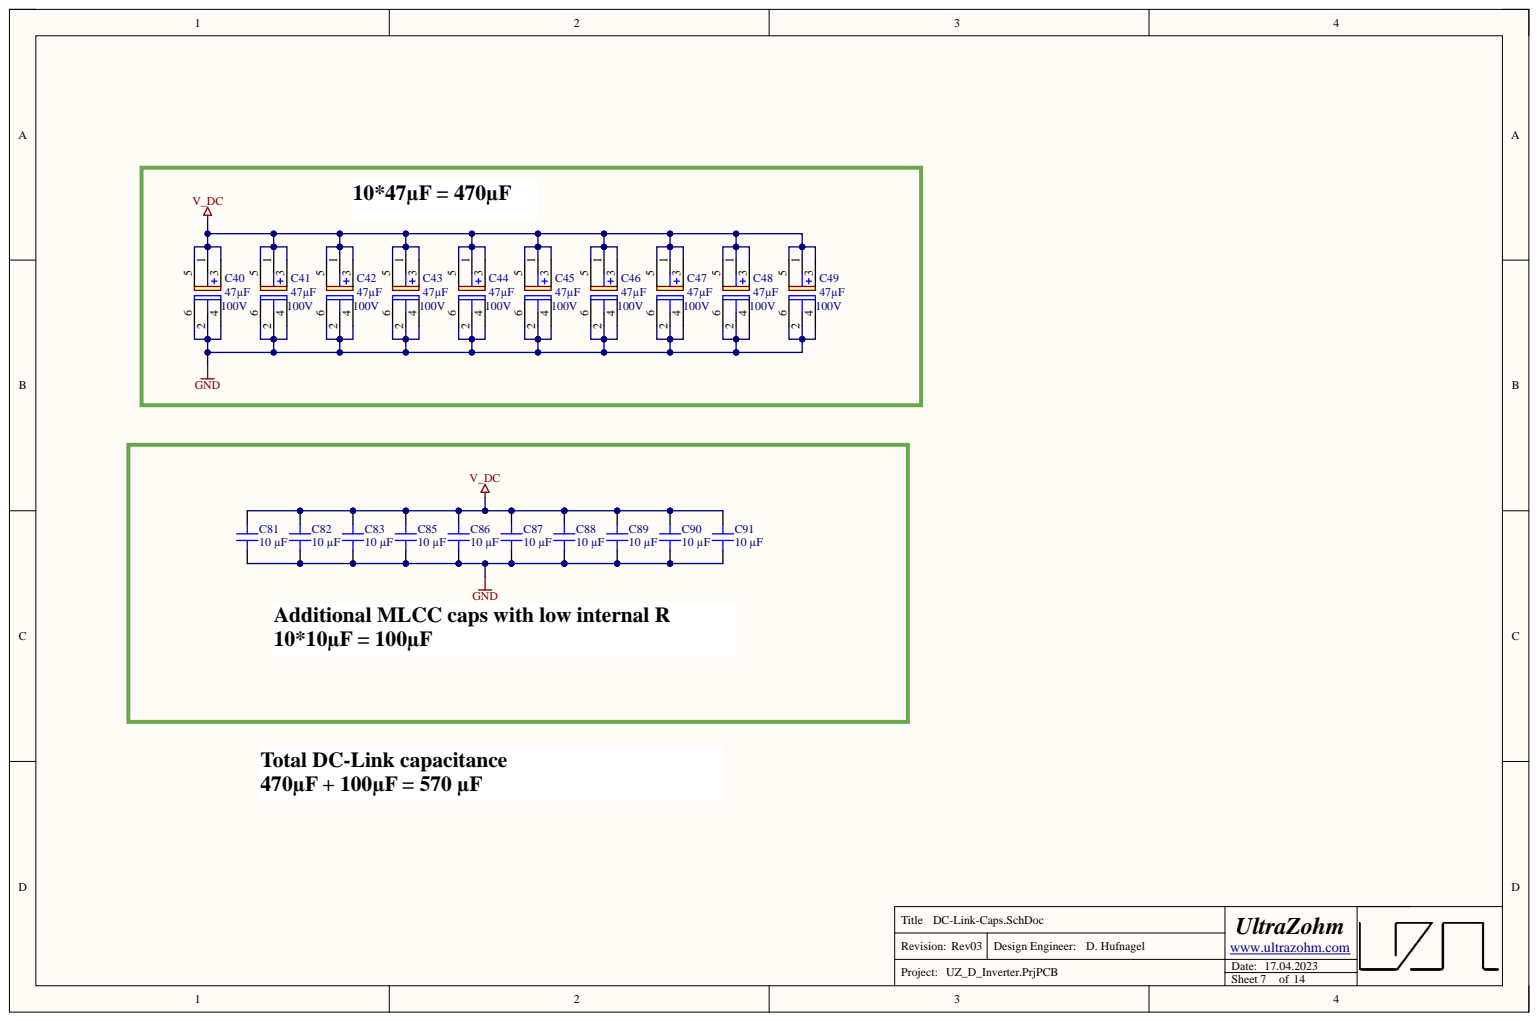
[picture p11: page 11]

Additional MLCC caps with low internal R

Total DC-Link capacitance

DC-Link-Caps.SchDoc

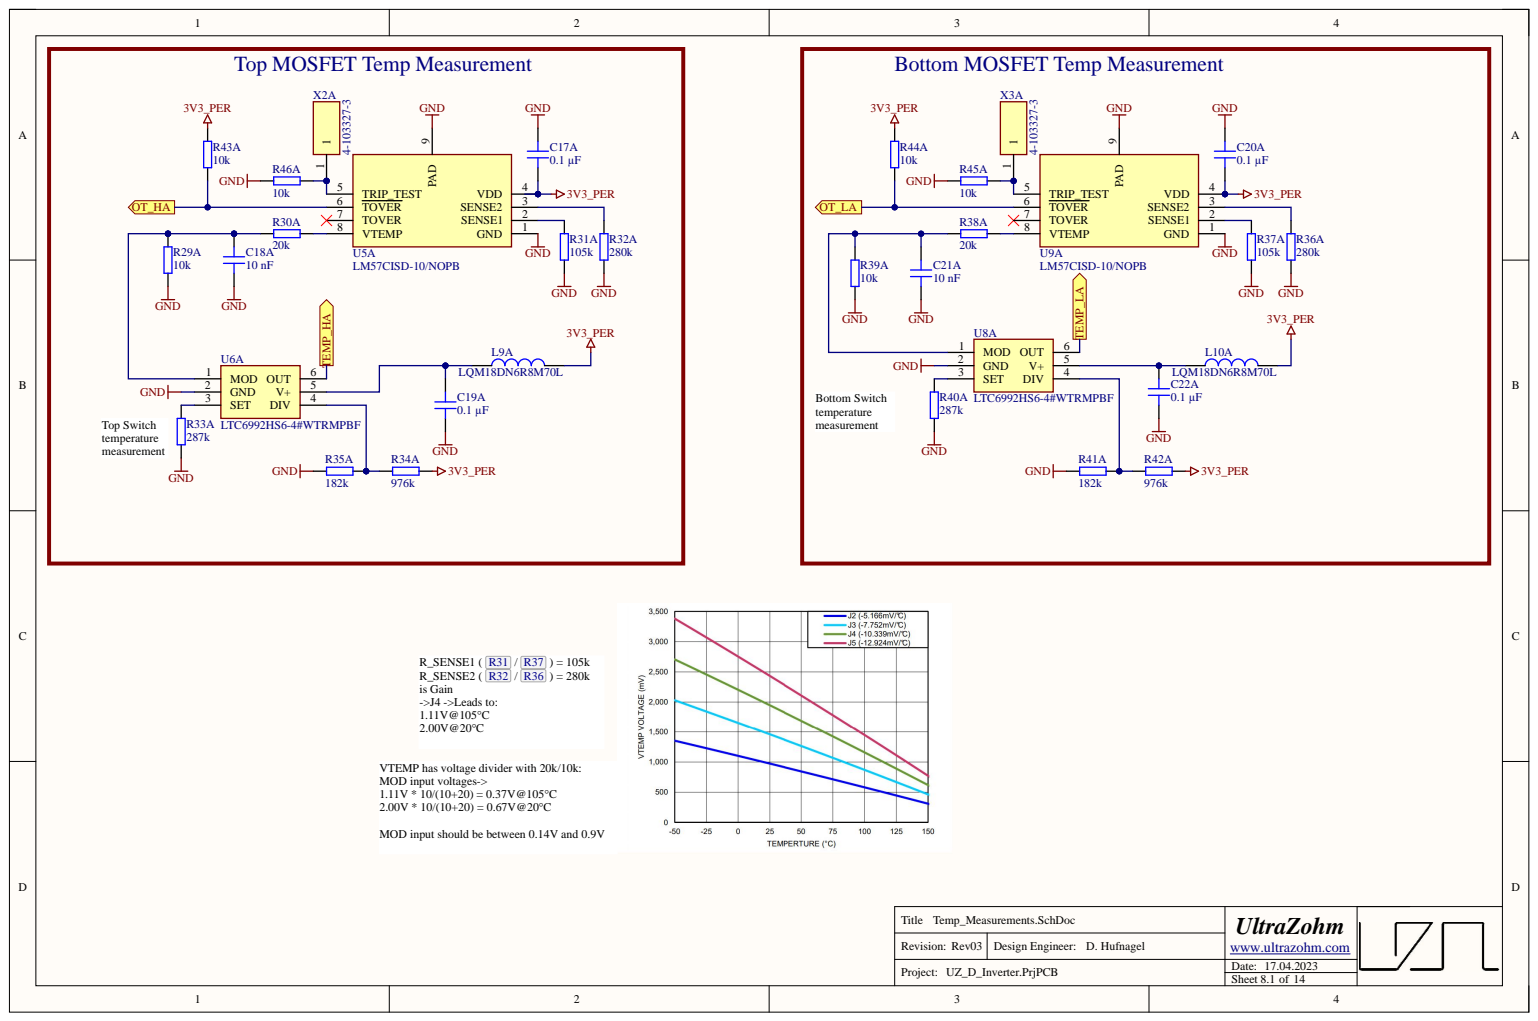
[picture p12: page 12]

VTEMP has voltage divider with 20k/10k:
MOD input voltages->

MOD input should be between 0.14V and 0.9V

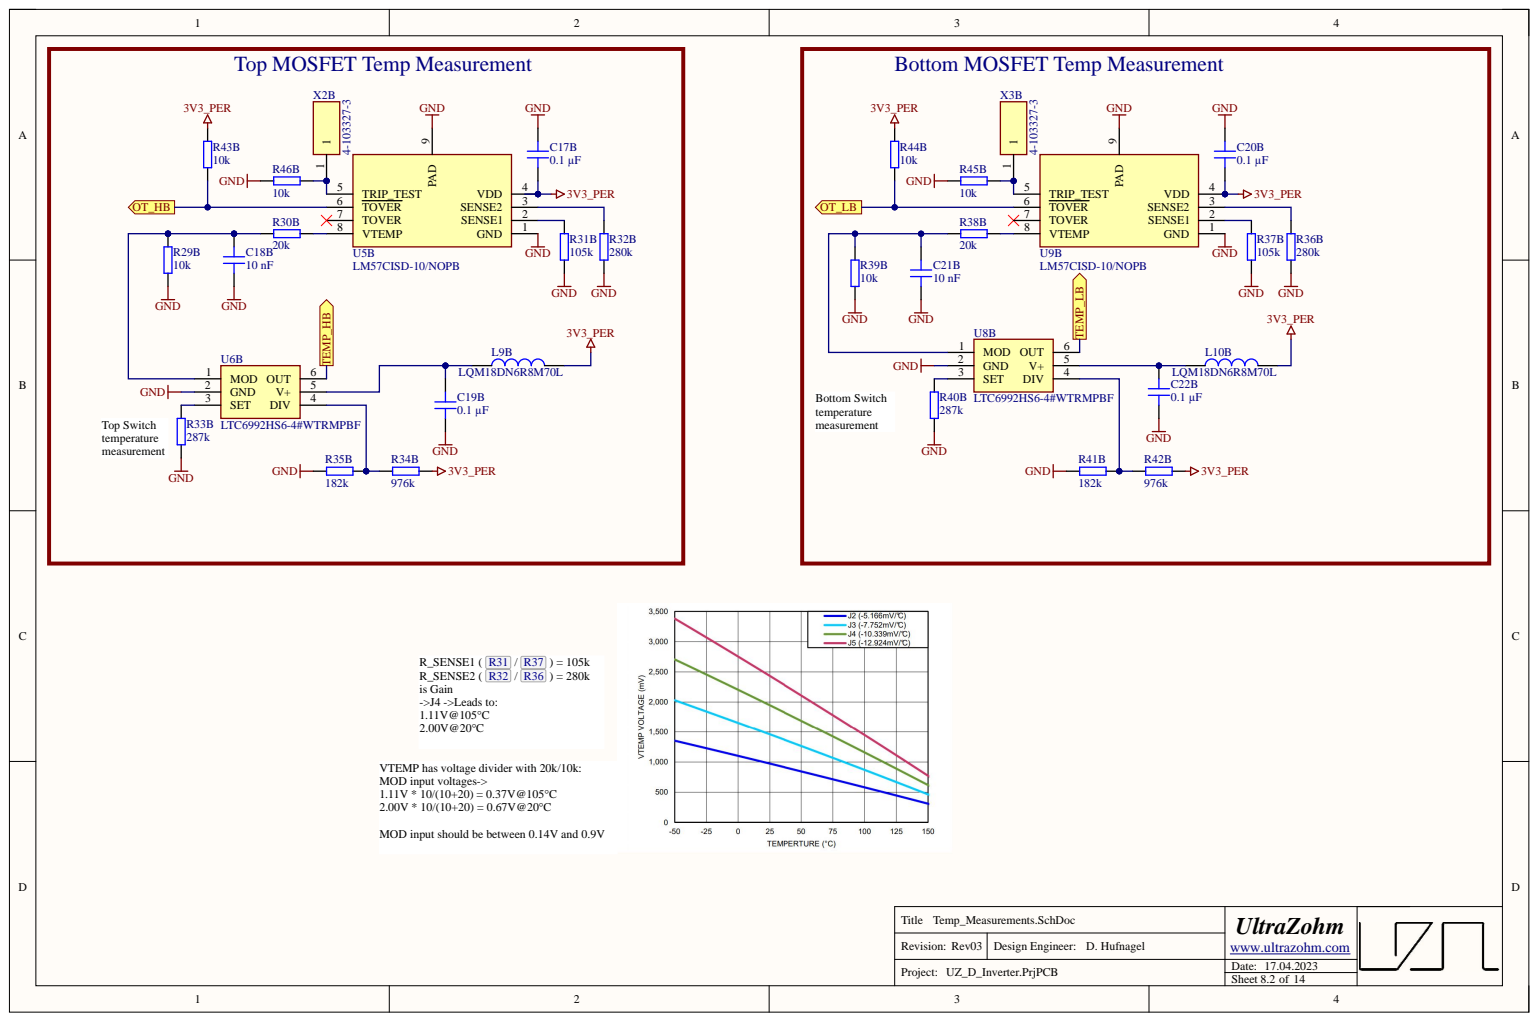
[picture p13: page 13]

VTEMP has voltage divider with 20k/10k:
MOD input voltages->

MOD input should be between 0.14V and 0.9V

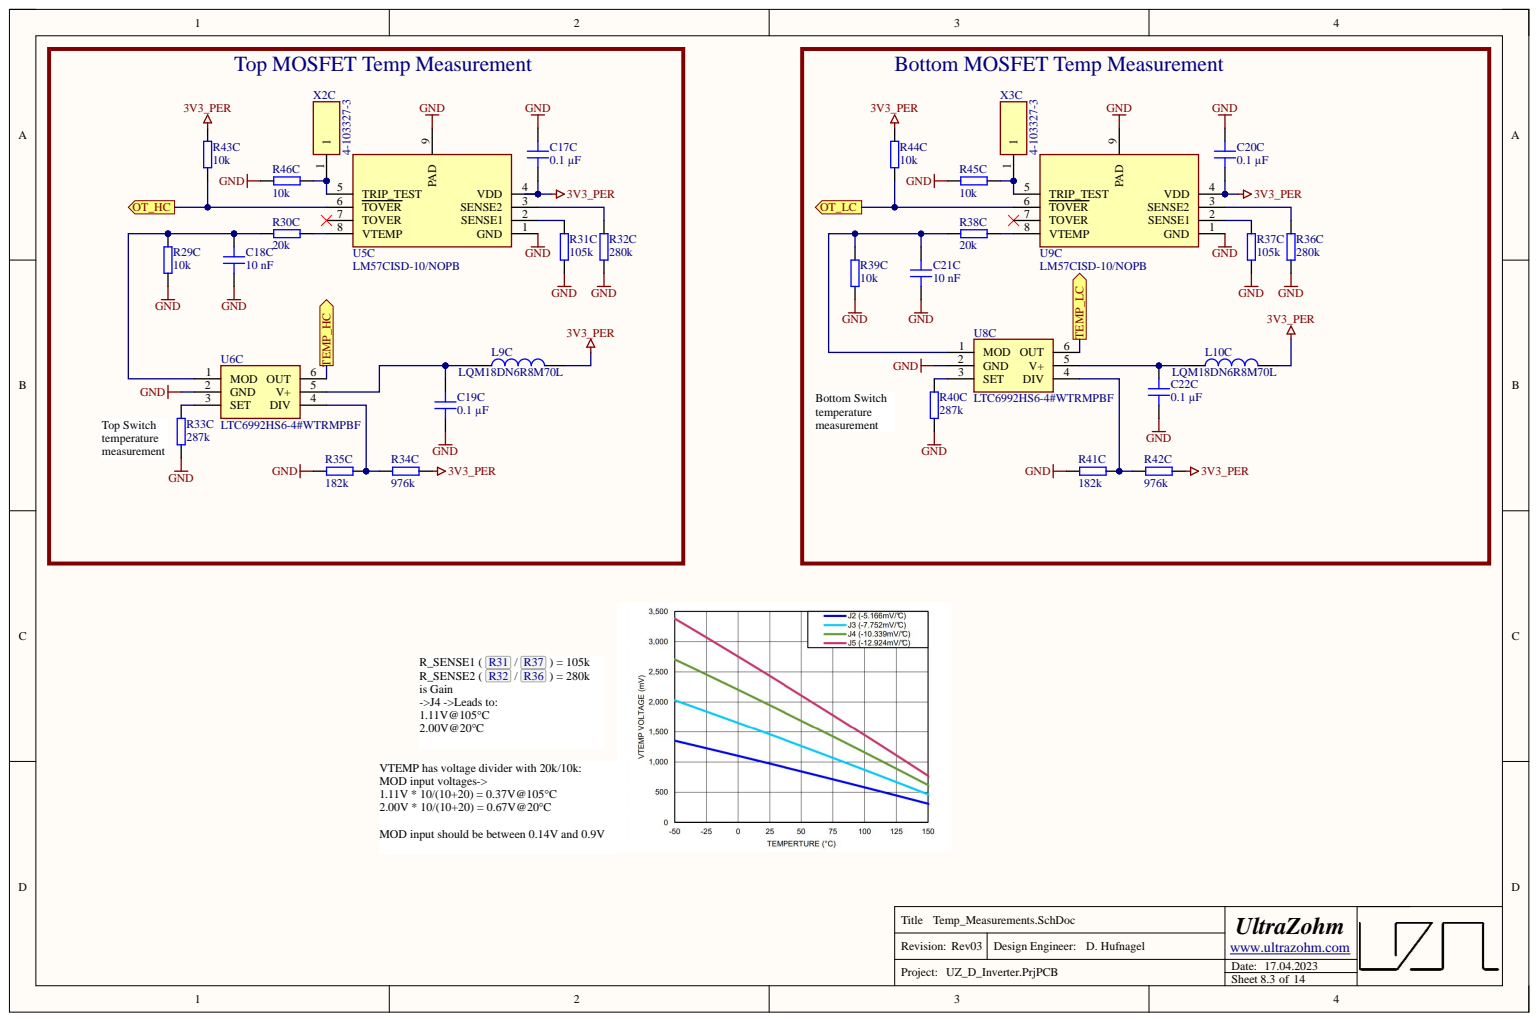
[picture p14: page 14]

VTEMP has voltage divider with 20k/10k:
MOD input voltages->

MOD input should be between 0.14V and 0.9V
