ultrazohm/uz_d_inverter/Project Outputs for UZ_D_Inverter/Rev04/SCH_UZ_D_Inverter_Variant_V1_Rev04.PDF

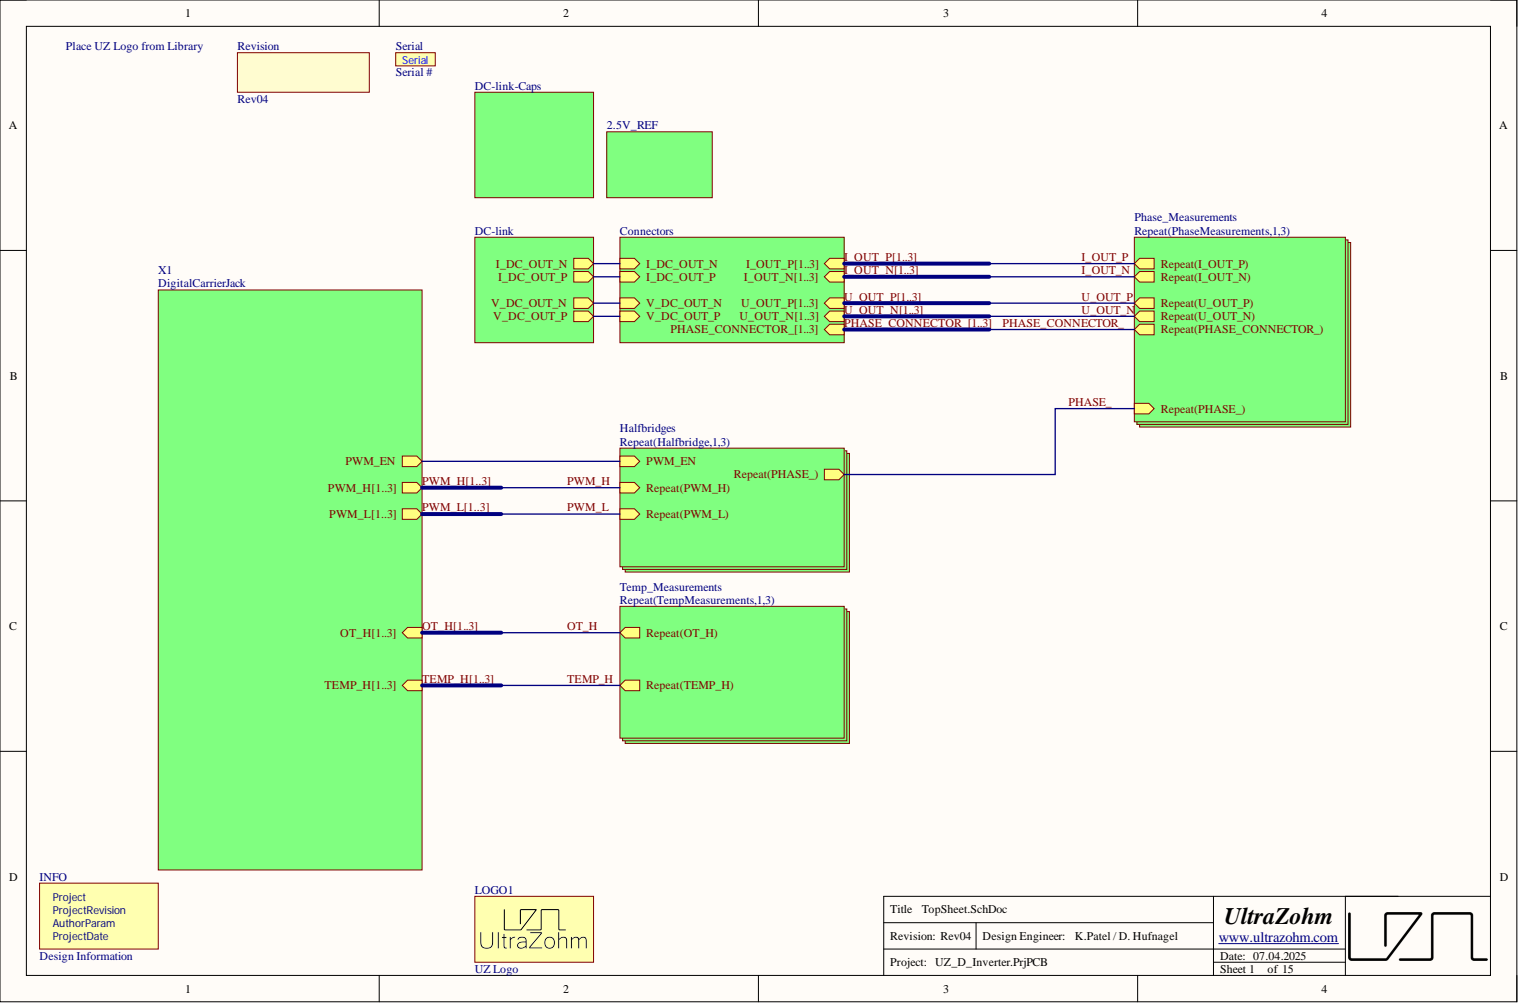
[picture p15: page 1]

Place UZ Logo from Library

Revision:

Date: 07.04.2025

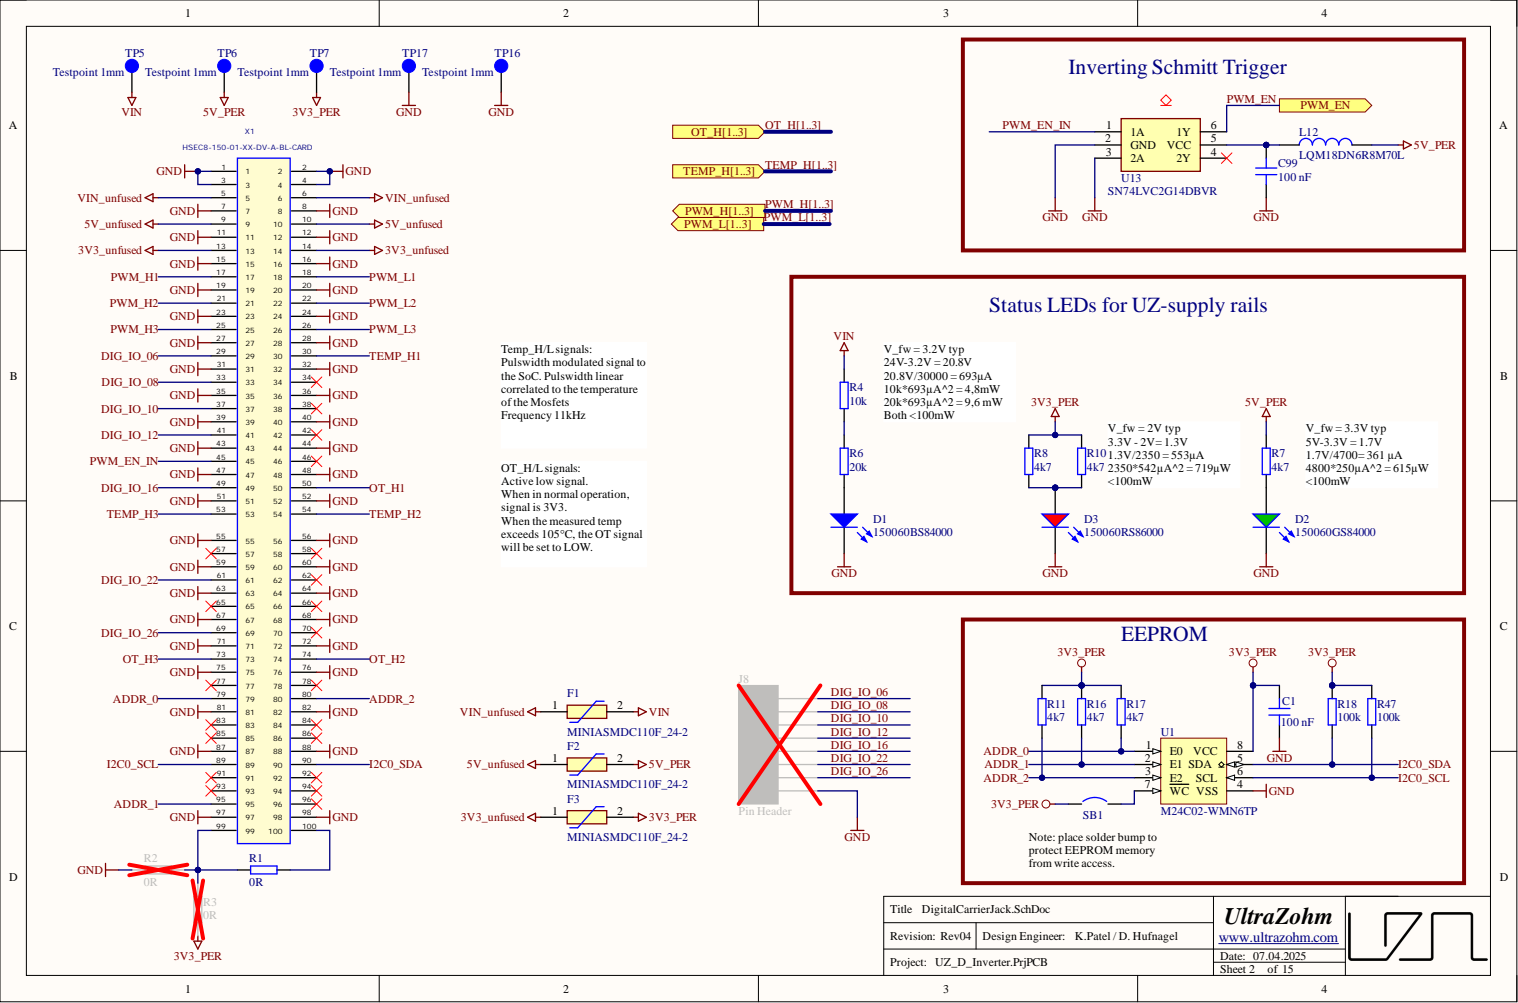
[picture p16: page 2]

HSEC8-150-01-XX-DV-A-BL-CARD

Status LEDs for UZ-supply rails

Temp_H/Lsignals:
Pulswidth modulated signal to
the SoC. Pulswidth linear
correlated to the temperature
of the Mosfets
Frequency 11kHz

OT_H/Lsignals:
Active low signal.
When in normal operation,
signal is 3V3.
When the measured temp
exceeds 105°C, the OT signal
will be set to LOW.

Note: place solder bump to
protect EEPROM memory
from write access.

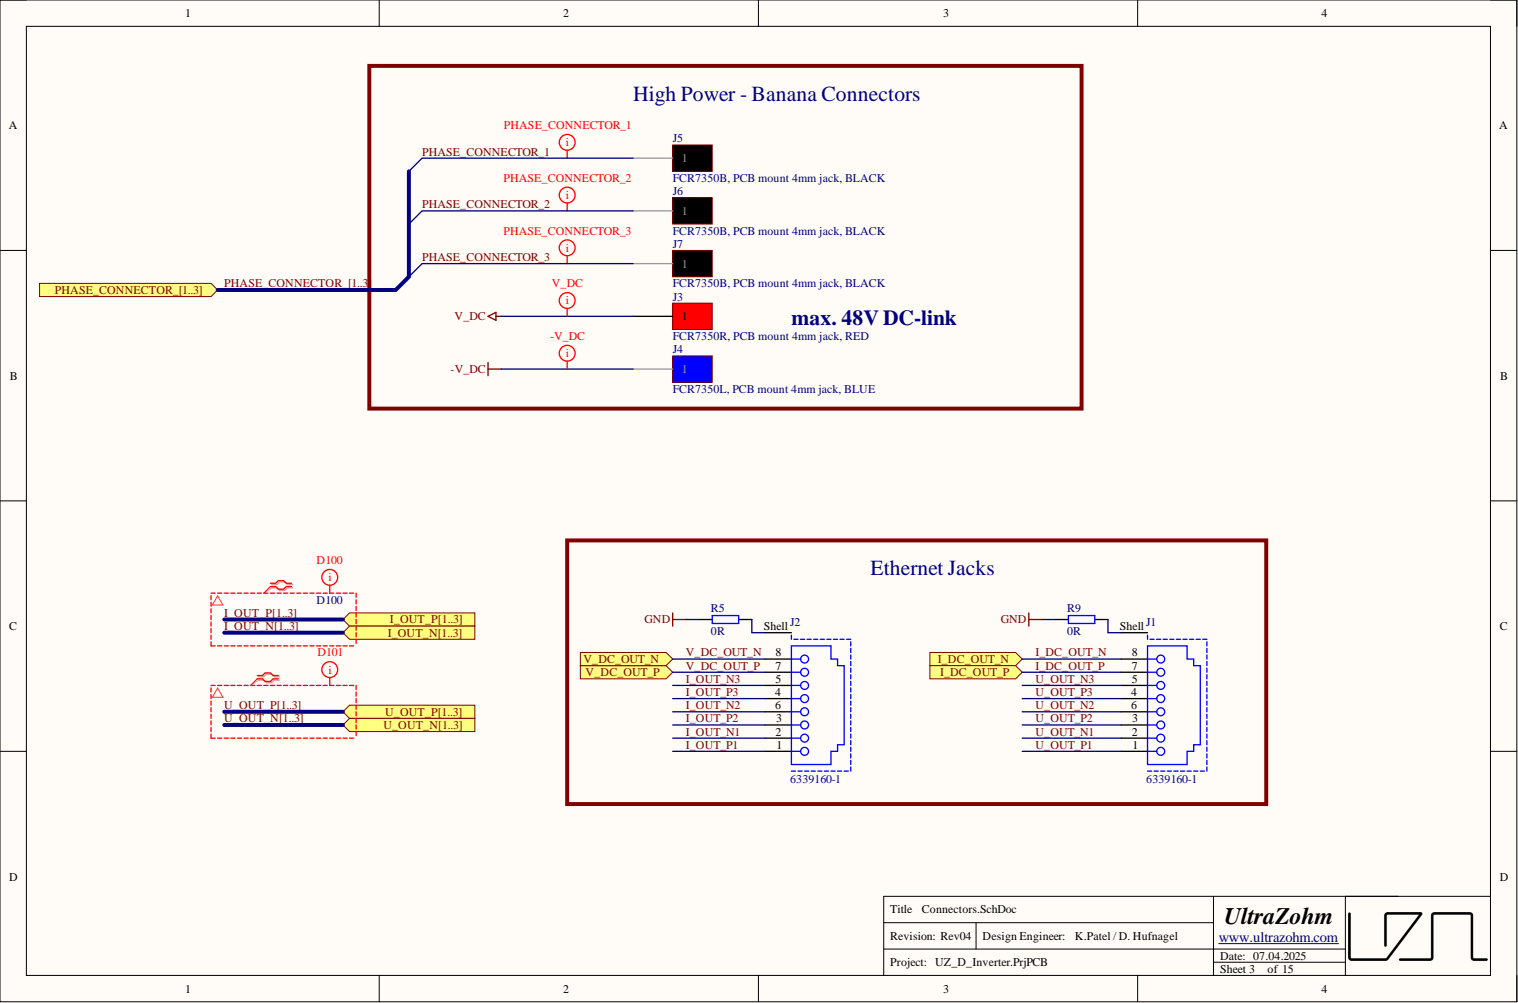
[picture p17: page 3]

High Power - Banana Connectors

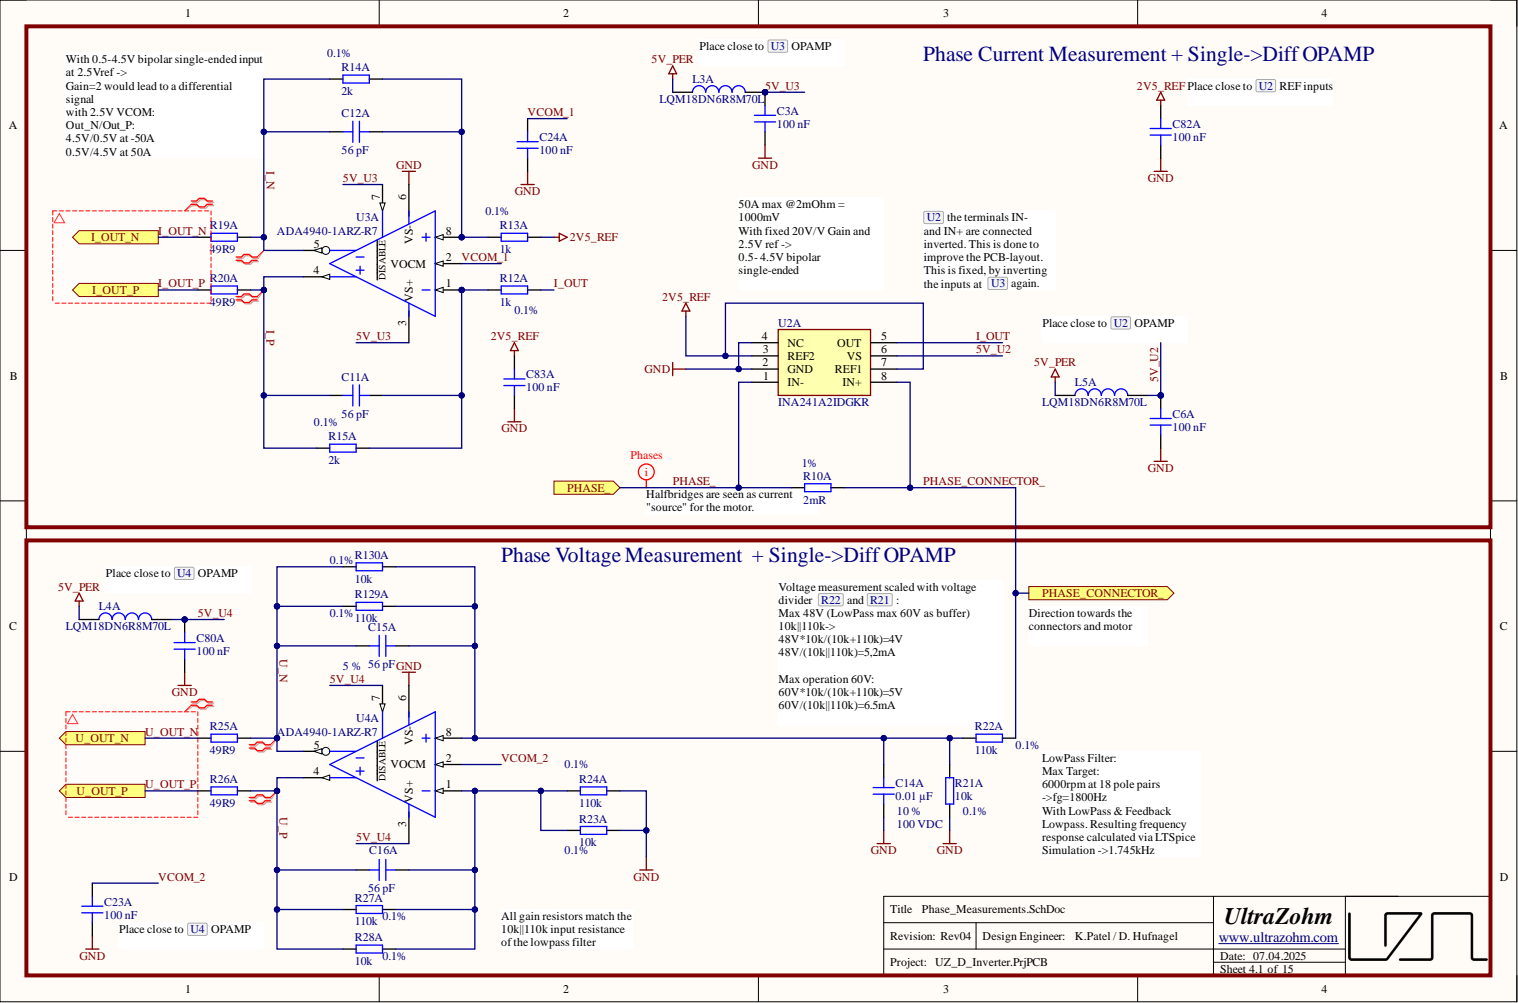
[picture p18: page 4]

Place close to U3 OPAMP

Phase Current Measurement + Single->Diff OPAMP

With 0.5-4.5V bipolar single-ended input
at 2.5Vref ->
Gain=2 would lead to a differential
signal
with 2.5V VCOM:
Out_N/Out_P:

Place close to U2 REF inputs

U2 the terminals IN-
and IN+ are connected
inverted. This is done to
improve the PCB-layout.
This is fixed, by inverting
the inputs at U3 again.

Place close to U2 OPAMP

Halfbridges are seen as current
"source" for the motor.

Place close to U4 OPAMP

Voltage measurement scaled with voltage
Max 48V (LowPass max 60V as buffer)

Max Target:
6000rpm at 18 pole pairs
With LowPass & Feedback
Lowpass. Resulting frequency
response calculated via LTSpice

All gain resistors match the
10k||110k input resistance
of the lowpass filter

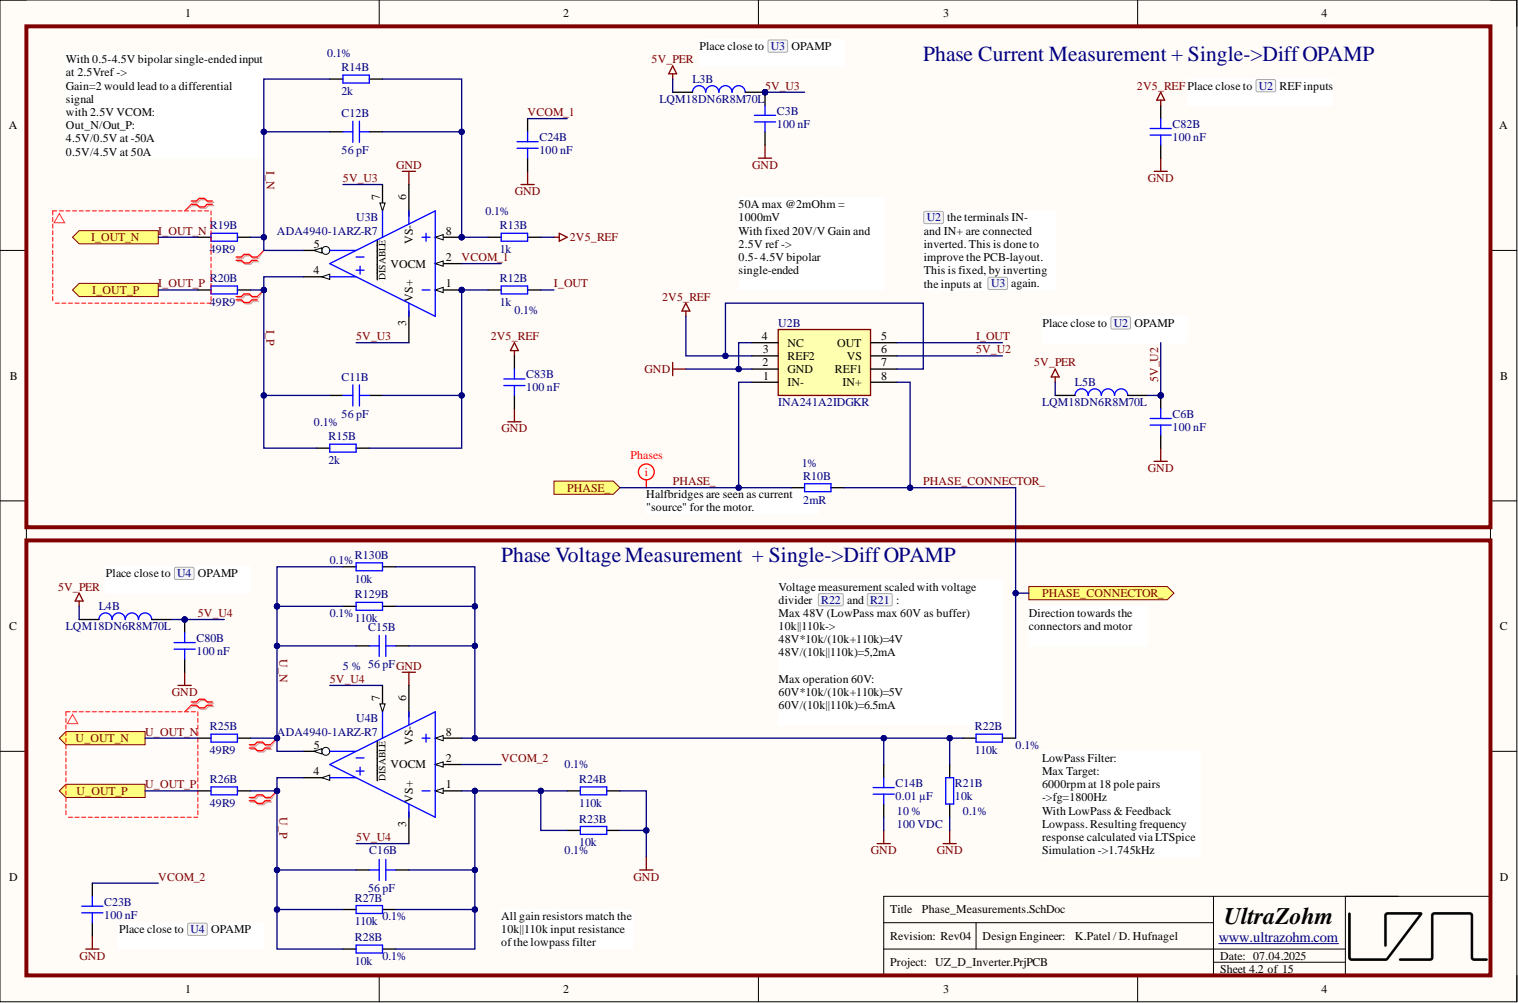
[picture p19: page 5]

Place close to U3 OPAMP

Phase Current Measurement + Single->Diff OPAMP

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

Place close to U2 REF inputs

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

Place close to U2 OPAMP

Halfbridges are seen as current
"source" for the motor.

Place close to U4 OPAMP

Voltage measurement scaled with voltage
Max 48V (LowPass max 60V as buffer)

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

All gain resistors match the
10k||110k input resistance
of the lowpass filter

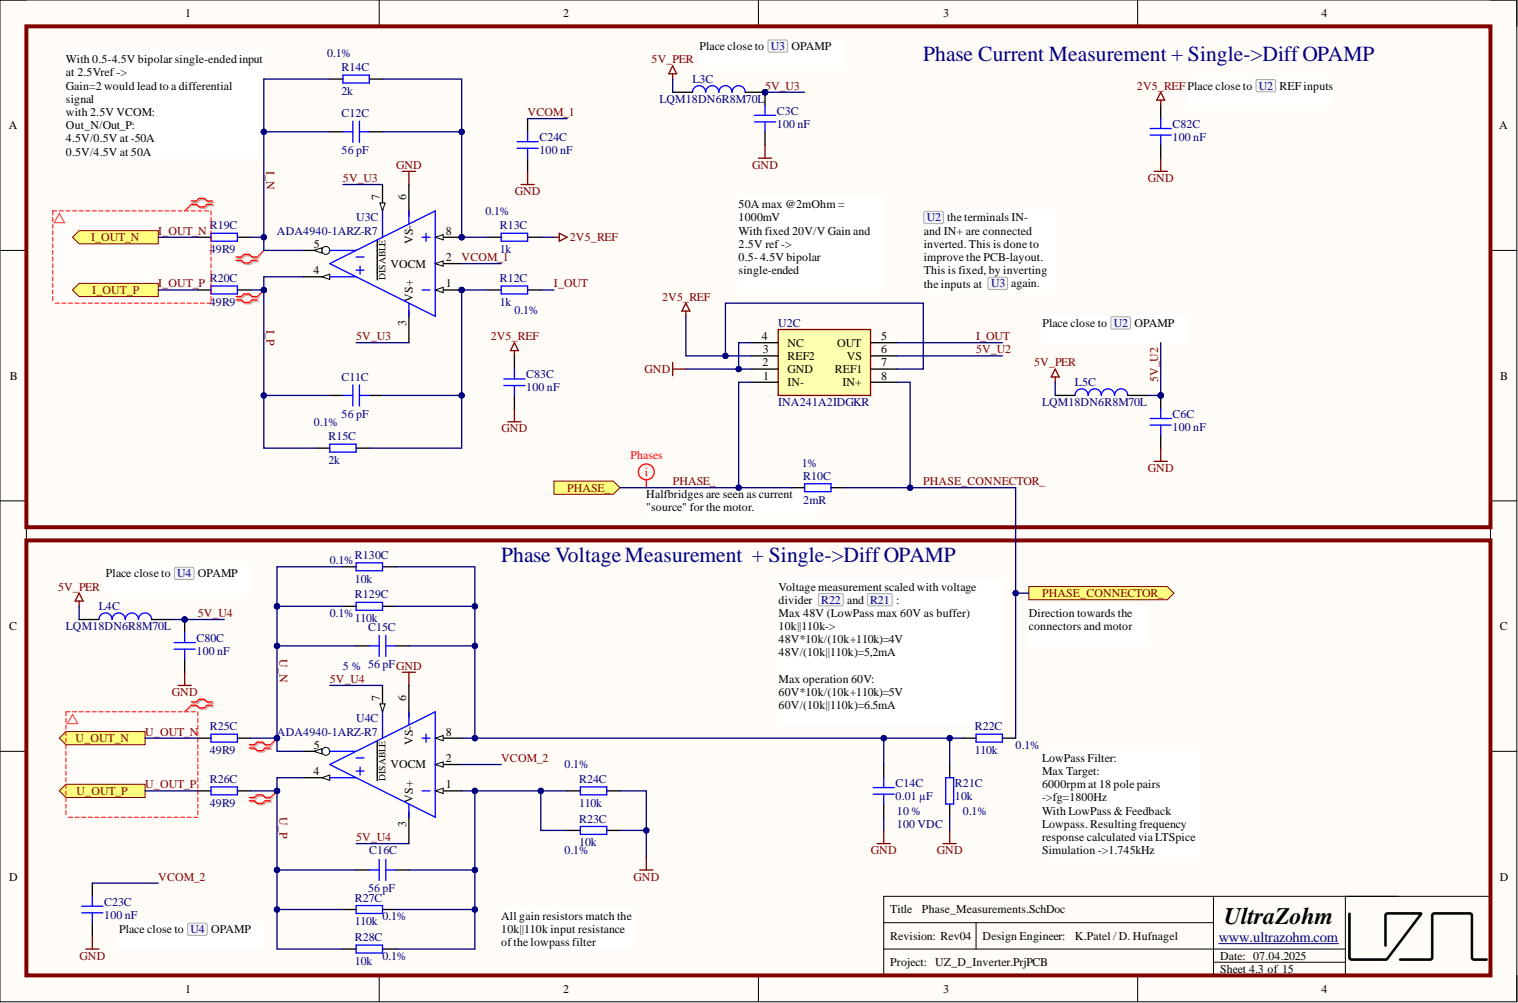
[picture p20: page 6]

Place close to U3 OPAMP

Phase Current Measurement + Single->Diff OPAMP

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

Place close to U2 REF inputs

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

Place close to U2 OPAMP

Halfbridges are seen as current
"source" for the motor.

Place close to U4 OPAMP

Voltage measurement scaled with voltage
Max 48V (LowPass max 60V as buffer)

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

All gain resistors match the
10k||110k input resistance
of the lowpass filter

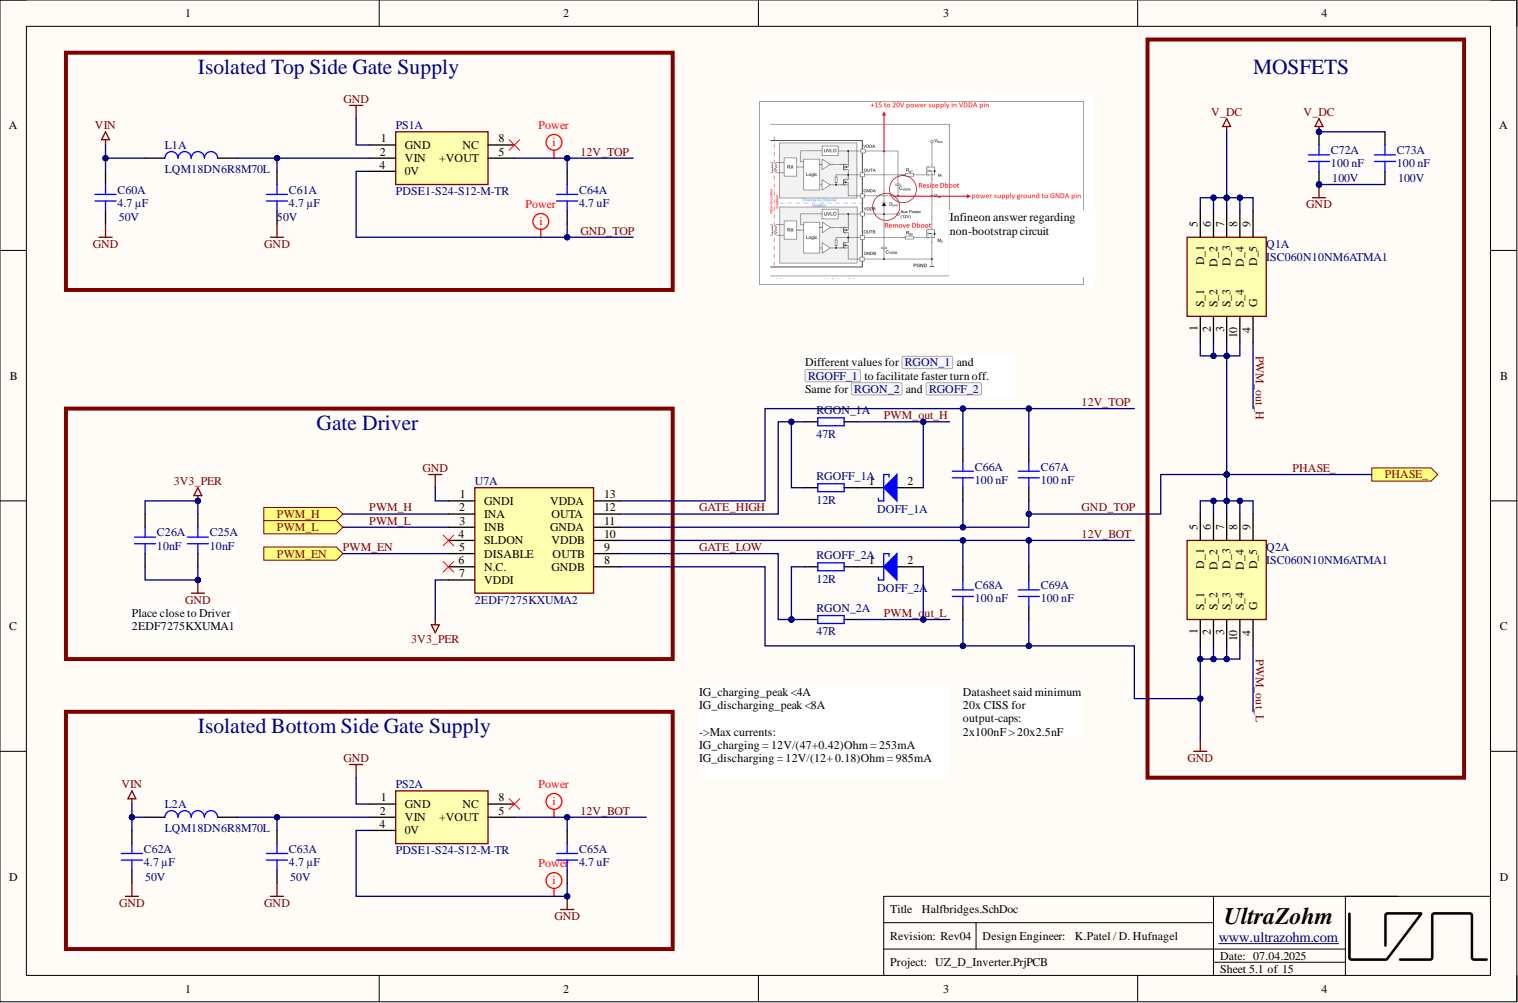
[picture p21: page 7]

Isolated Top Side Gate Supply

Different values for RGON_1 and
RGOFF_1 to facilitate faster turn off.
Same for RGON_2 and RGOFF_2

Place close to Driver
2EDF7275KXUMA1

Isolated Bottom Side Gate Supply

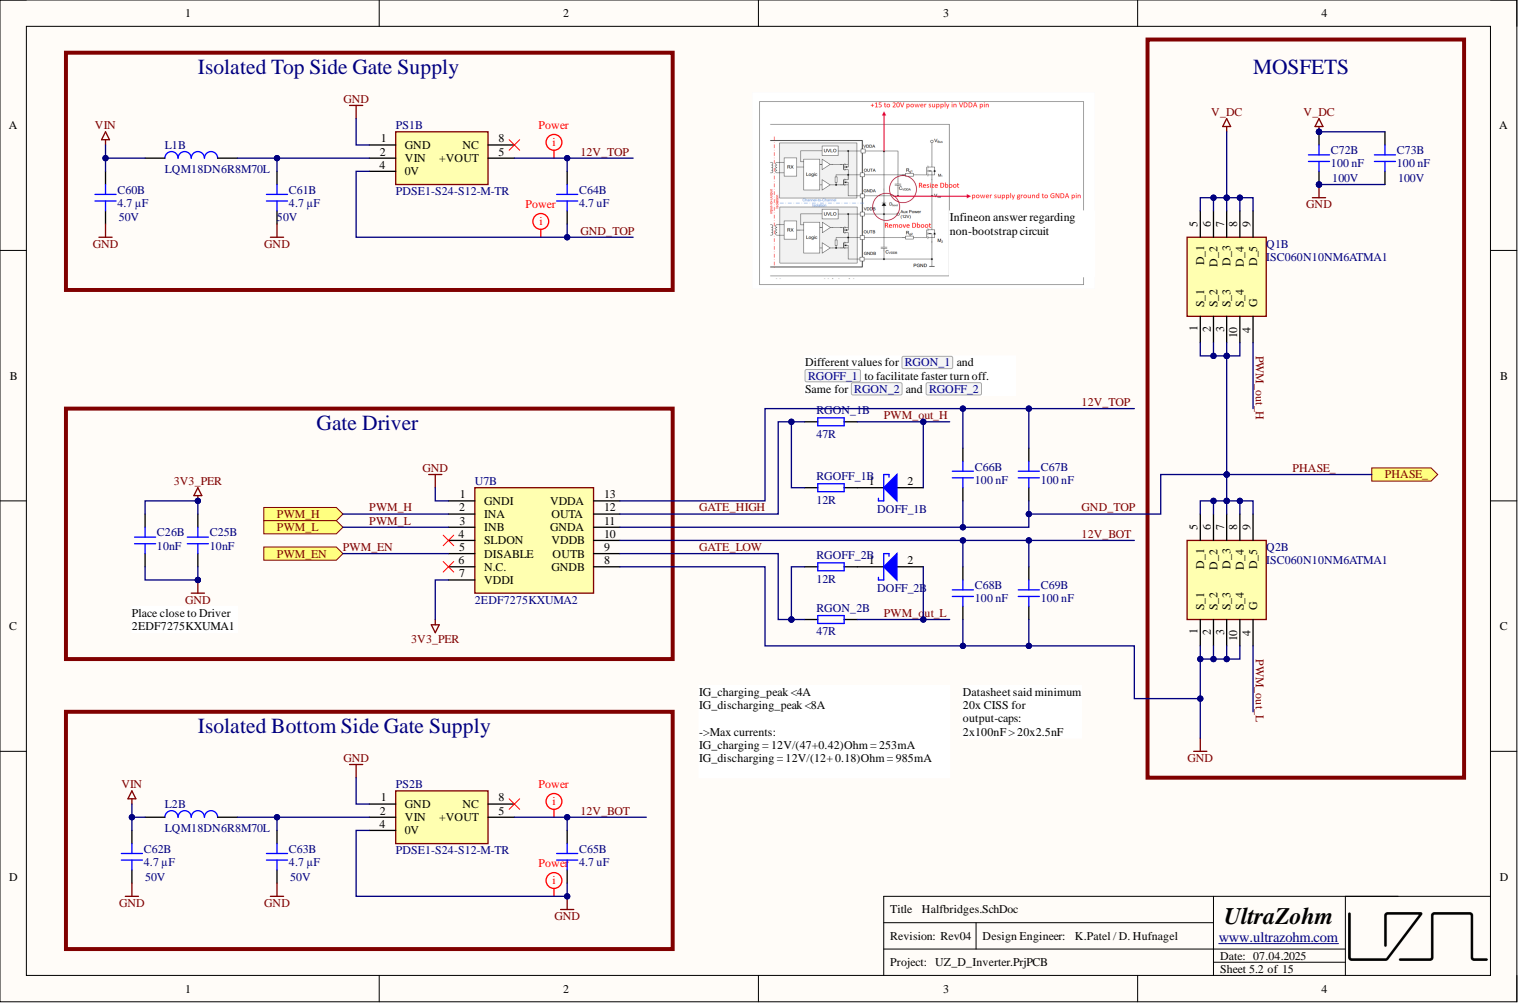
[picture p22: page 8]

Isolated Top Side Gate Supply

Different values for RGON_1 and
RGOFF_1 to facilitate faster turn off.
Same for RGON_2 and RGOFF_2

Place close to Driver
2EDF7275KXUMA1

Isolated Bottom Side Gate Supply

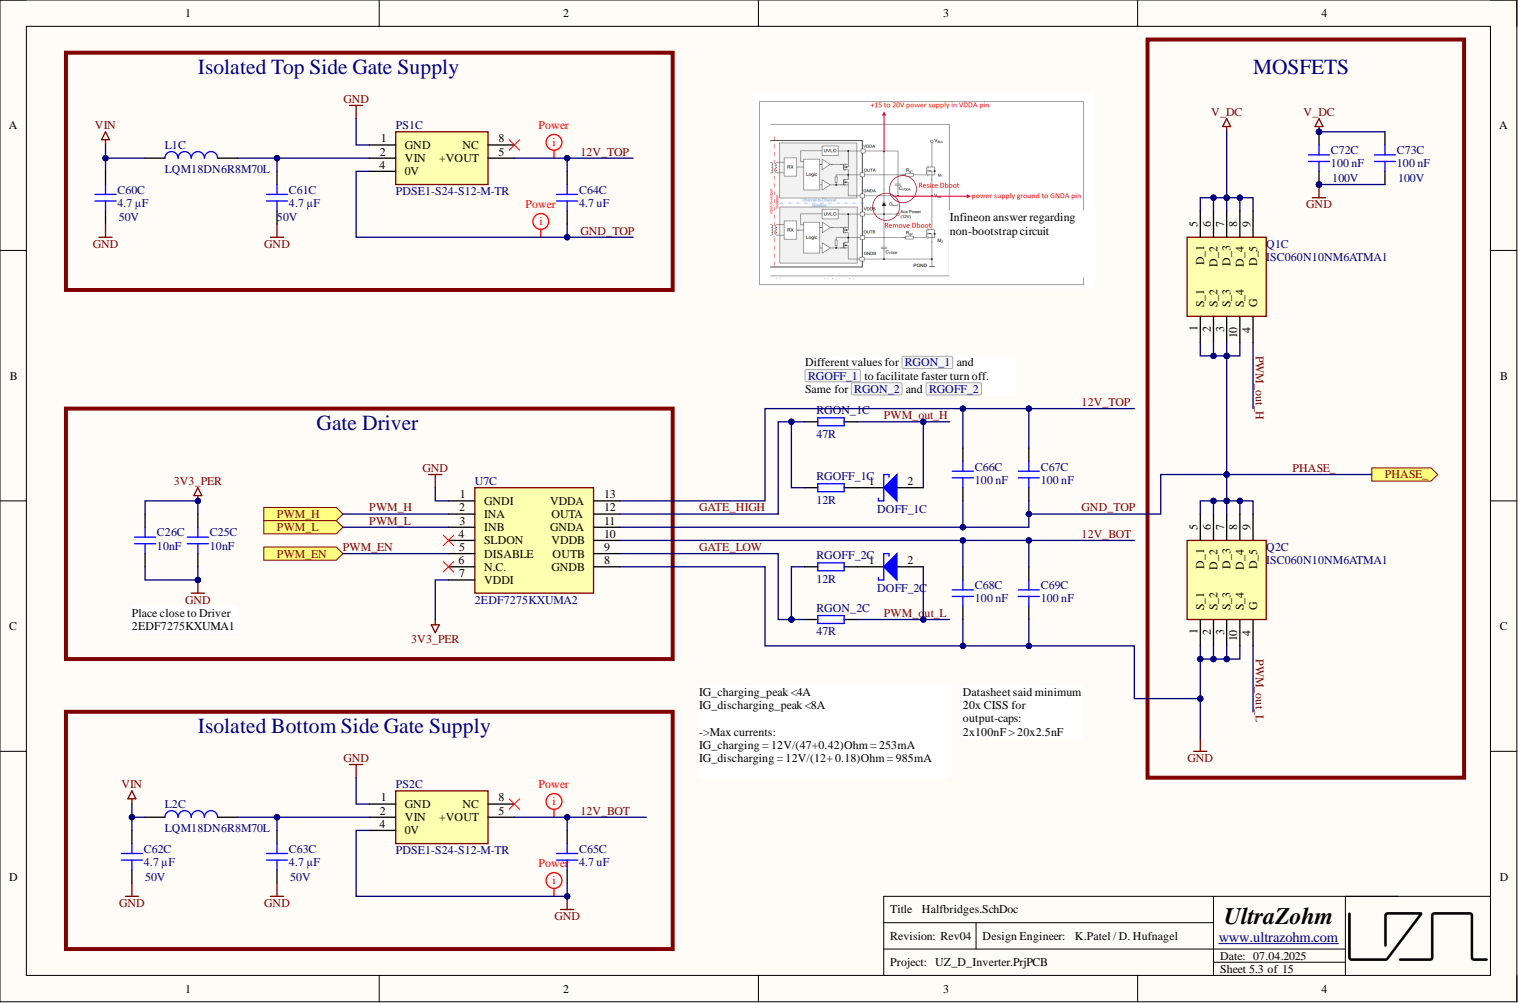
[picture p23: page 9]

Isolated Top Side Gate Supply

Different values for RGON_1 and
RGOFF_1 to facilitate faster turn off.
Same for RGON_2 and RGOFF_2

Place close to Driver
2EDF7275KXUMA1

Isolated Bottom Side Gate Supply

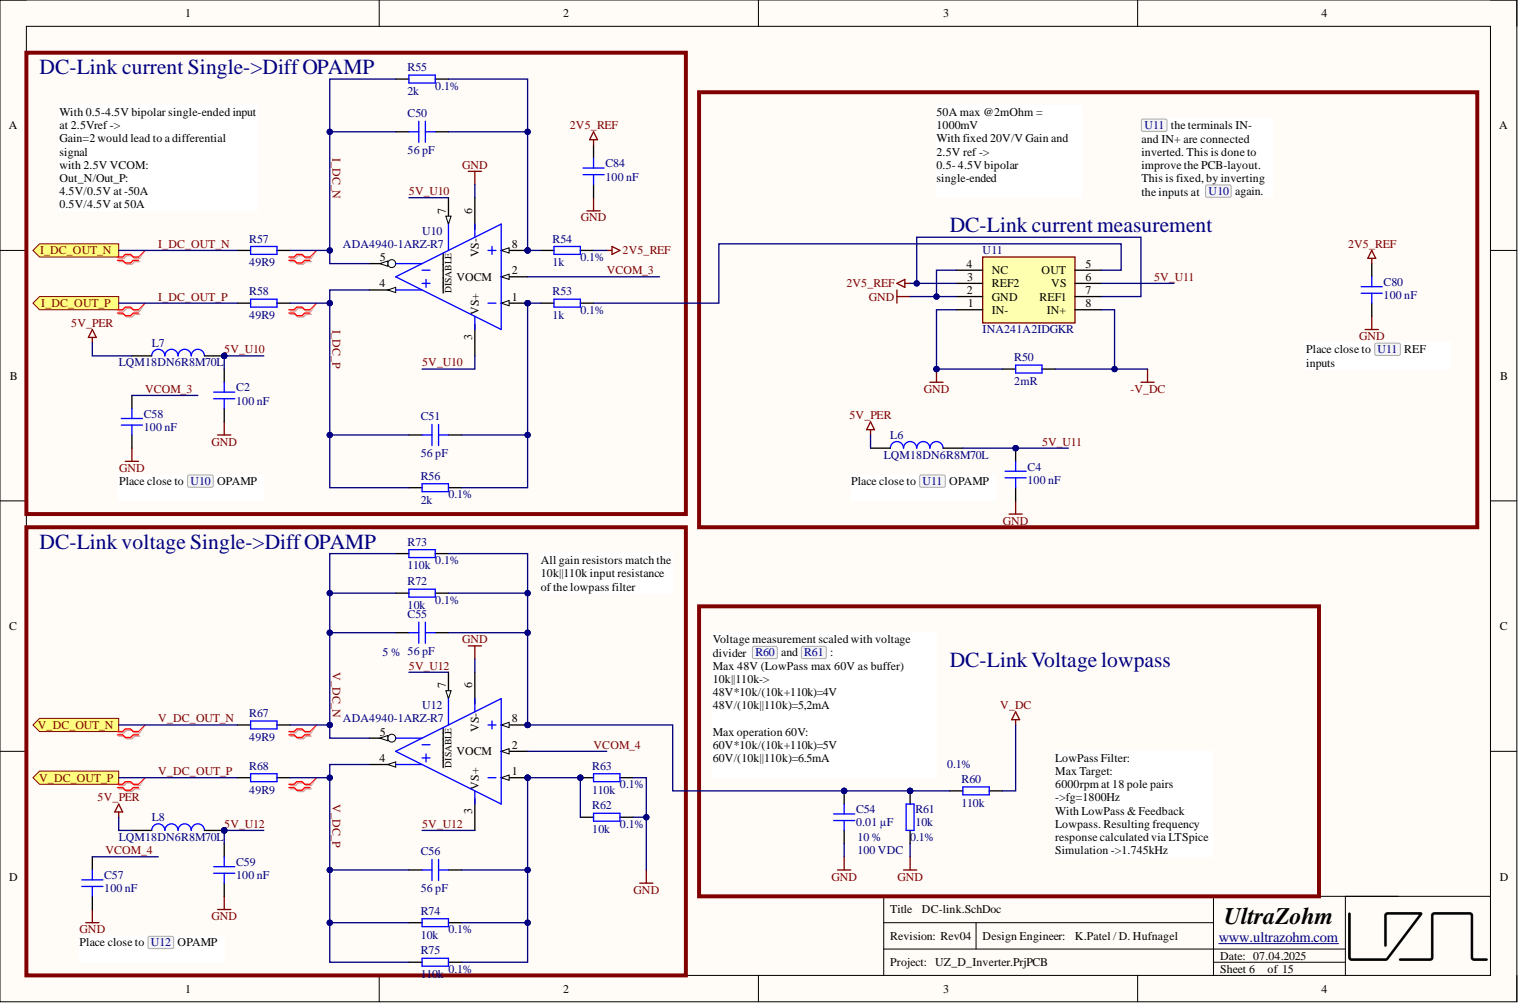
[picture p24: page 10]

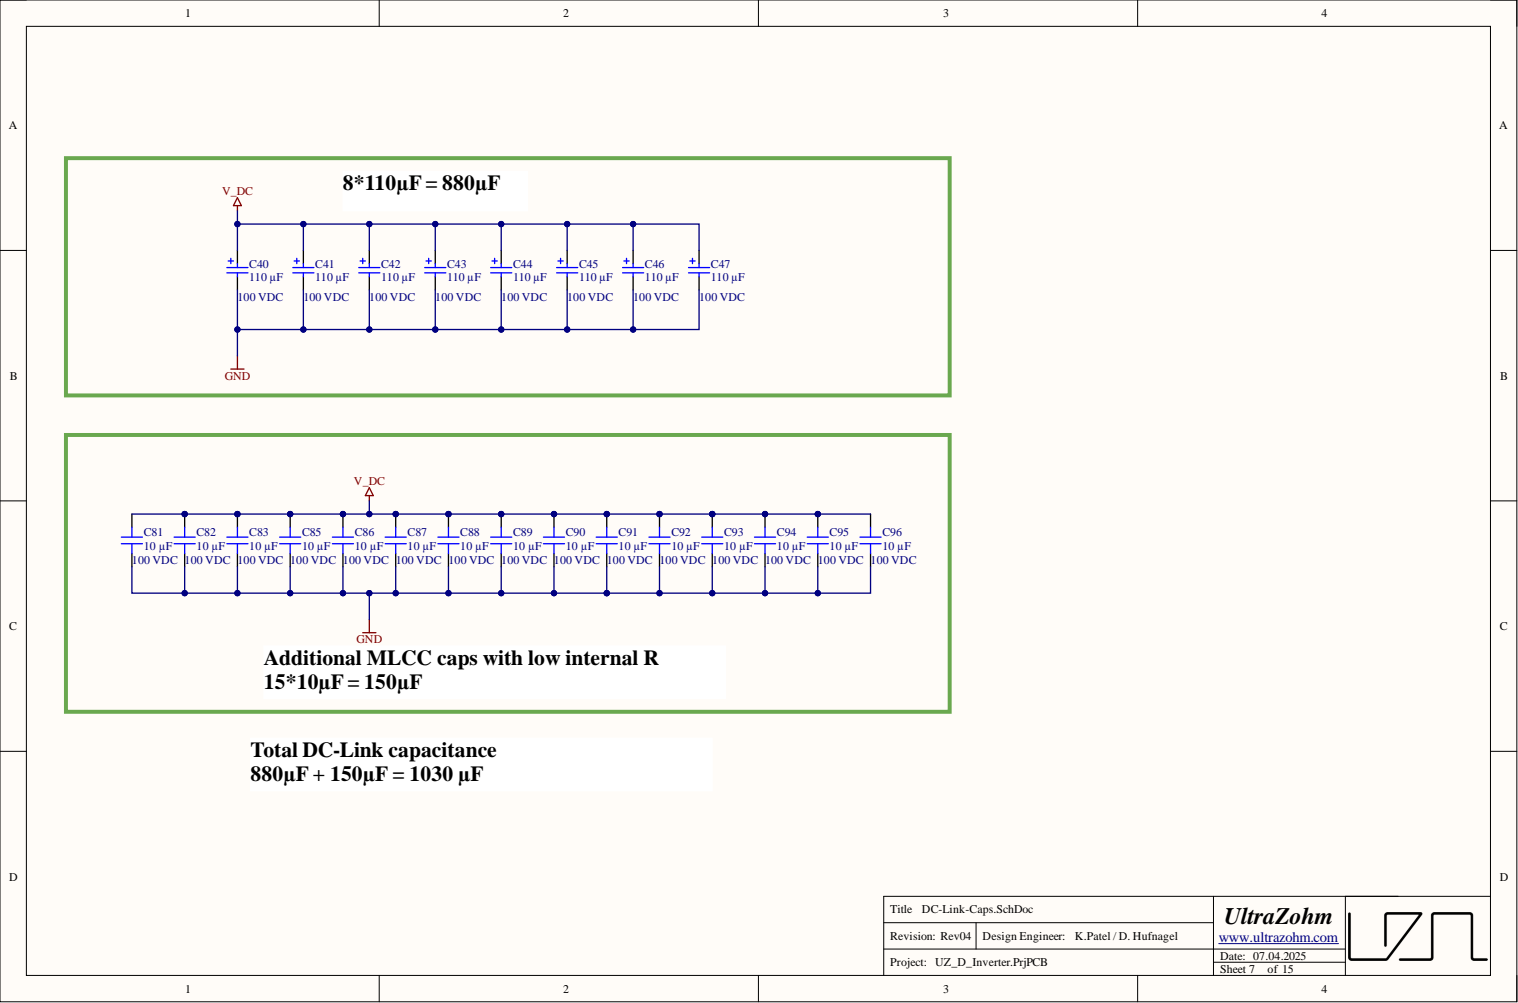
[picture p25: page 11]

Additional MLCC caps with low internal R

Total DC-Link capacitance

DC-Link-Caps.SchDoc

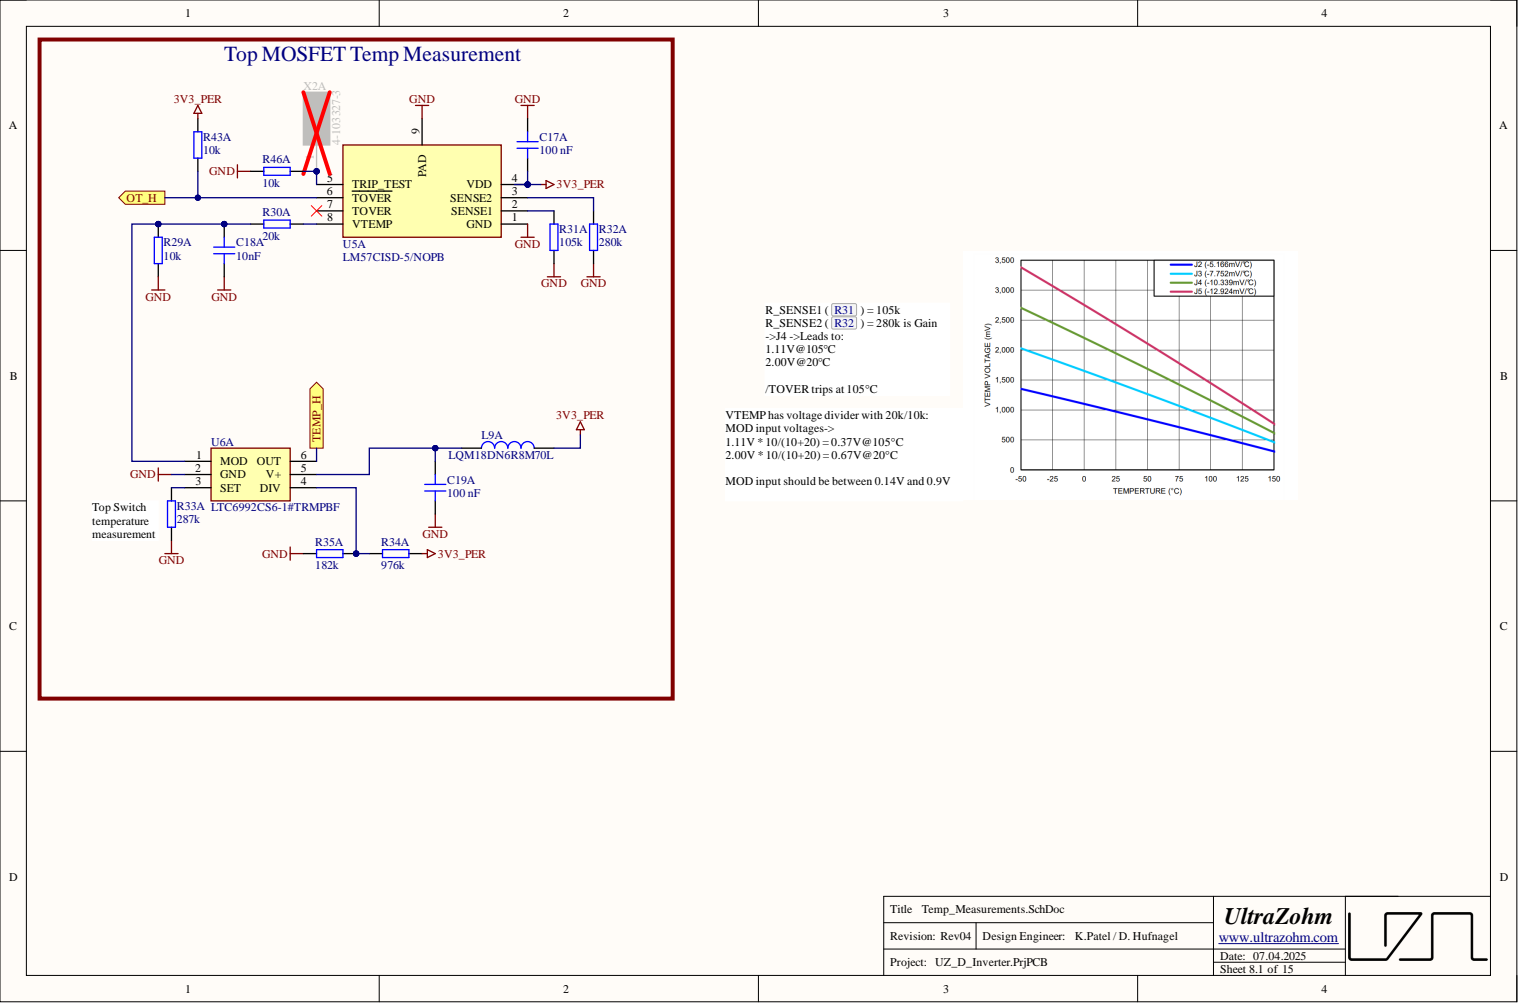
[picture p26: page 12]

Top MOSFET Temp Measurement

VTEMP has voltage divider with 20k/10k:
MOD input voltages->

MOD input should be between 0.14V and 0.9V

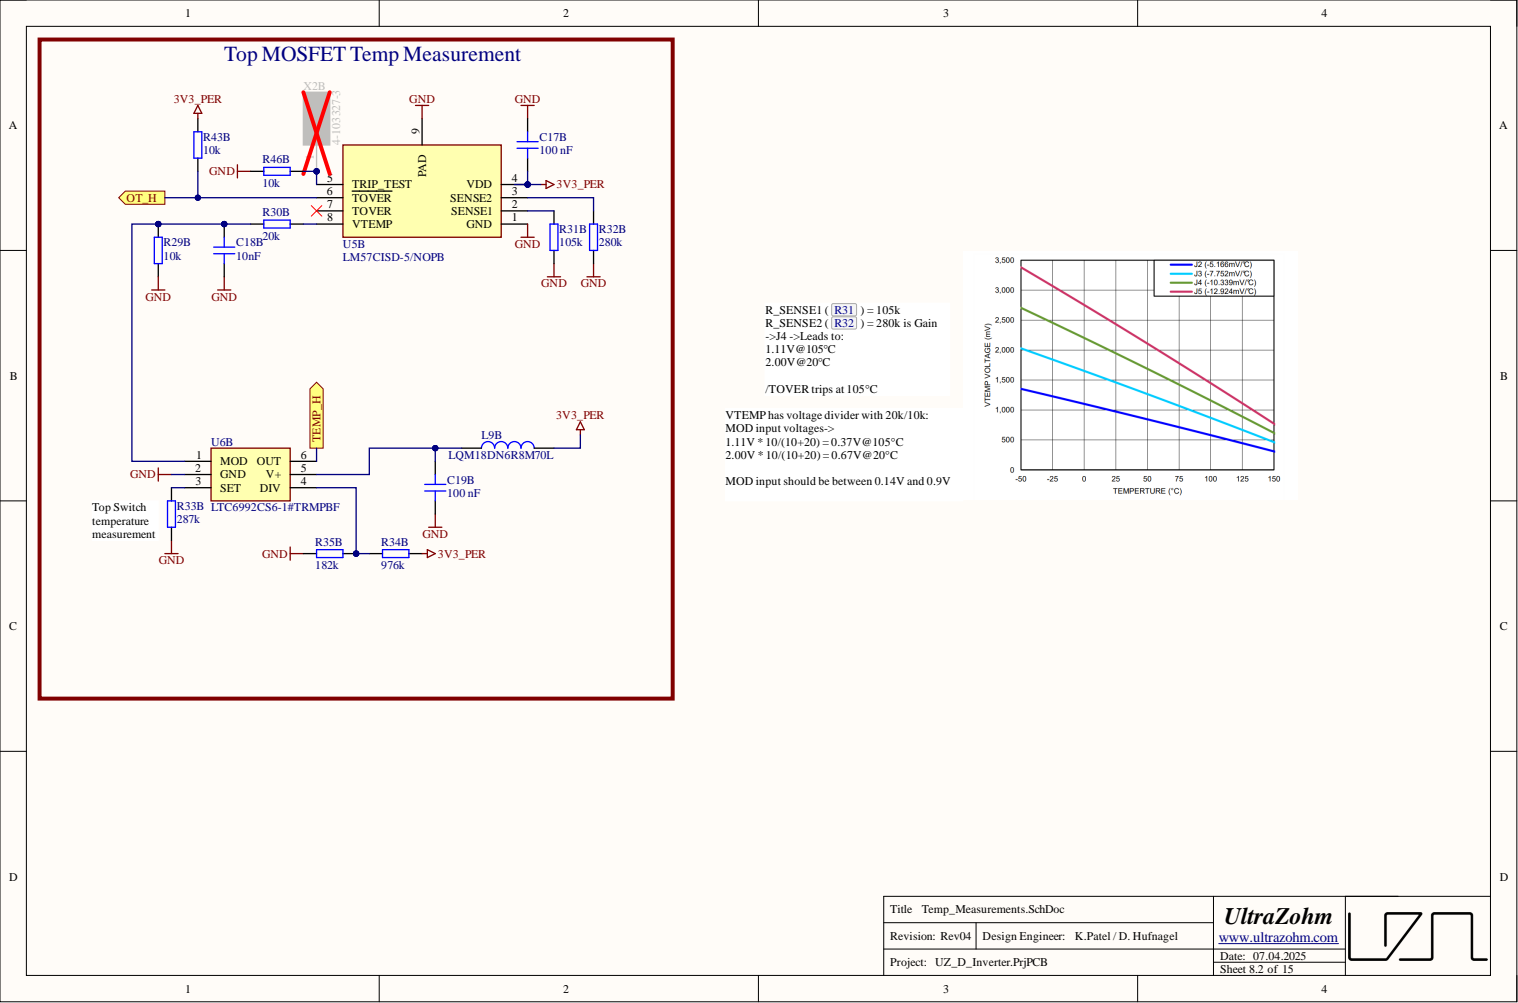
[picture p27: page 13]

Top MOSFET Temp Measurement

VTEMP has voltage divider with 20k/10k:
MOD input voltages->

MOD input should be between 0.14V and 0.9V

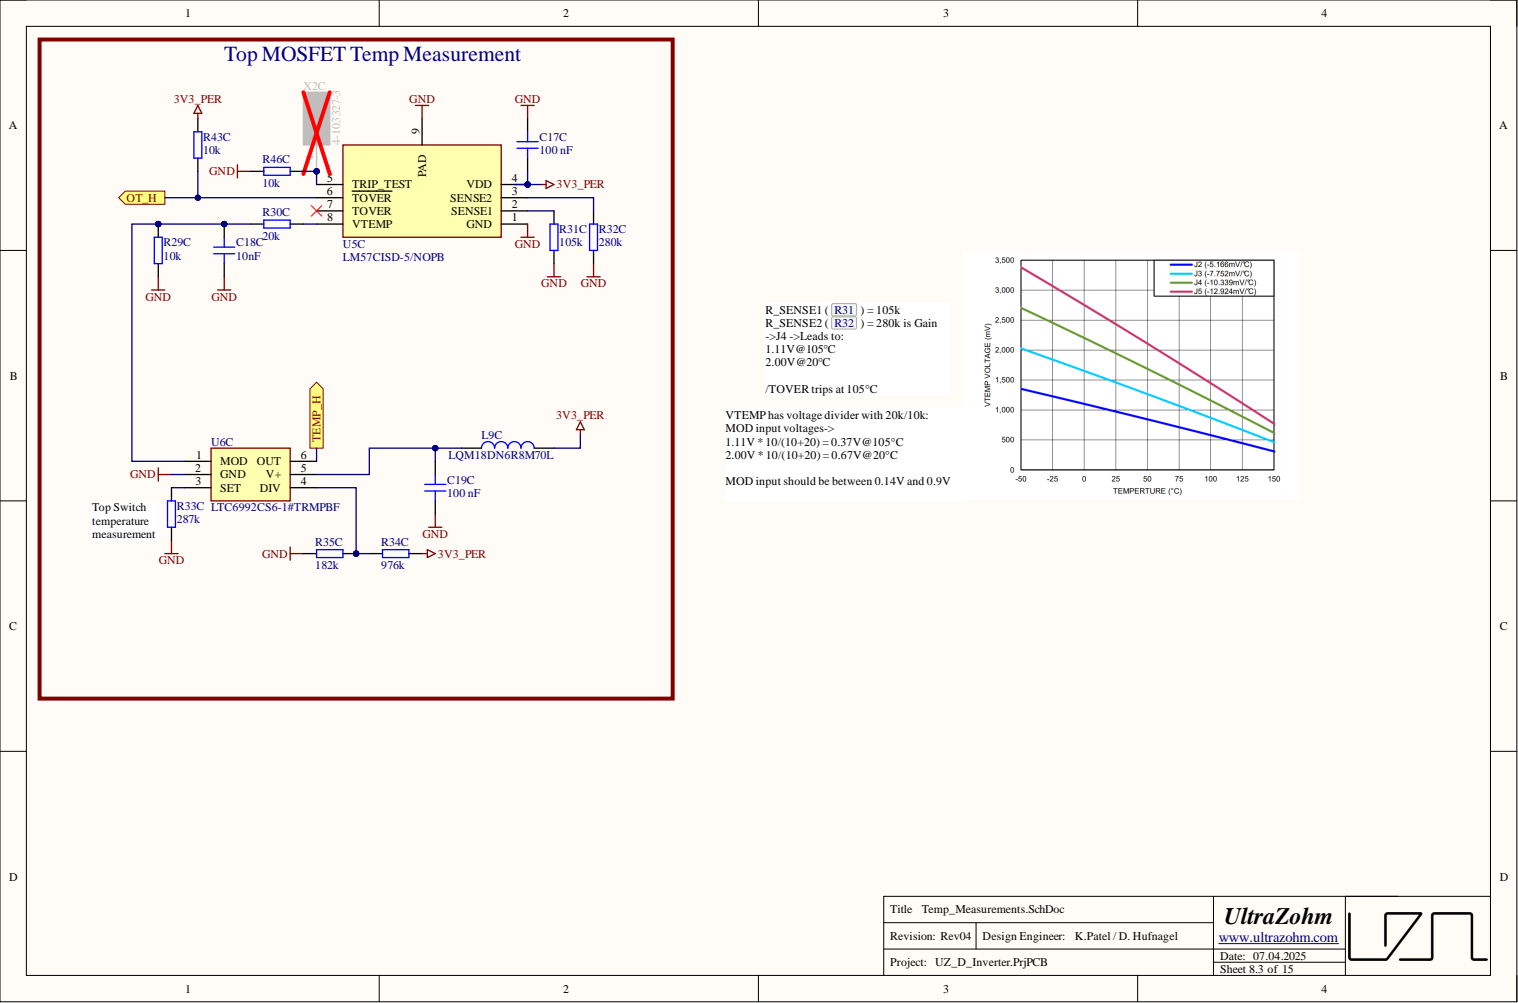
[picture p28: page 14]

Top MOSFET Temp Measurement

VTEMP has voltage divider with 20k/10k:
MOD input voltages->

MOD input should be between 0.14V and 0.9V

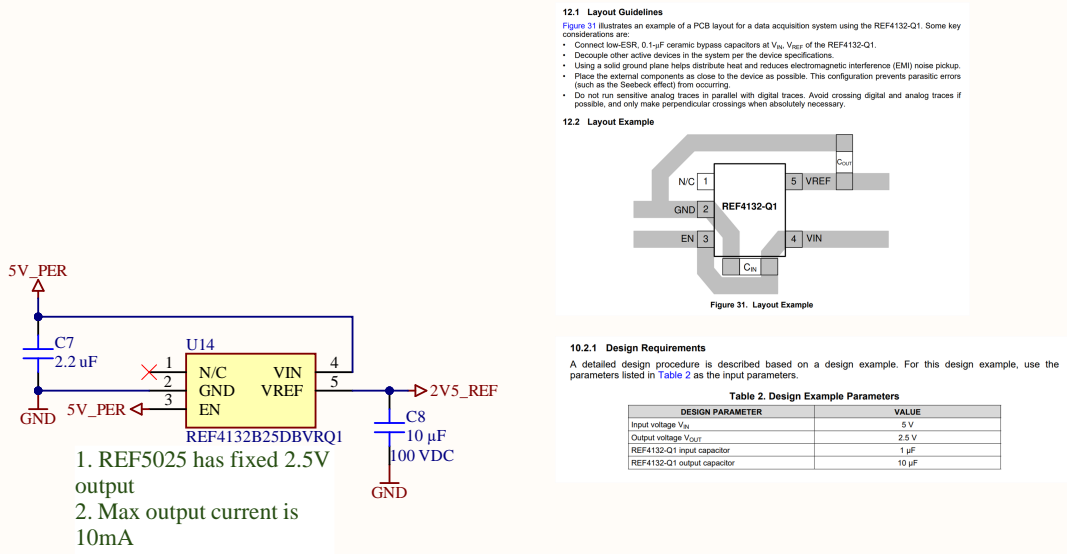
[picture p29: page 15]

Rev i s i o n :

Dat e : .
