ultrazohm/uz_d_inverter/Project Outputs for UZ_D_Inverter/Rev03/ASM_UZ_D_Inverter_Variant_V1_Rev03.pdf

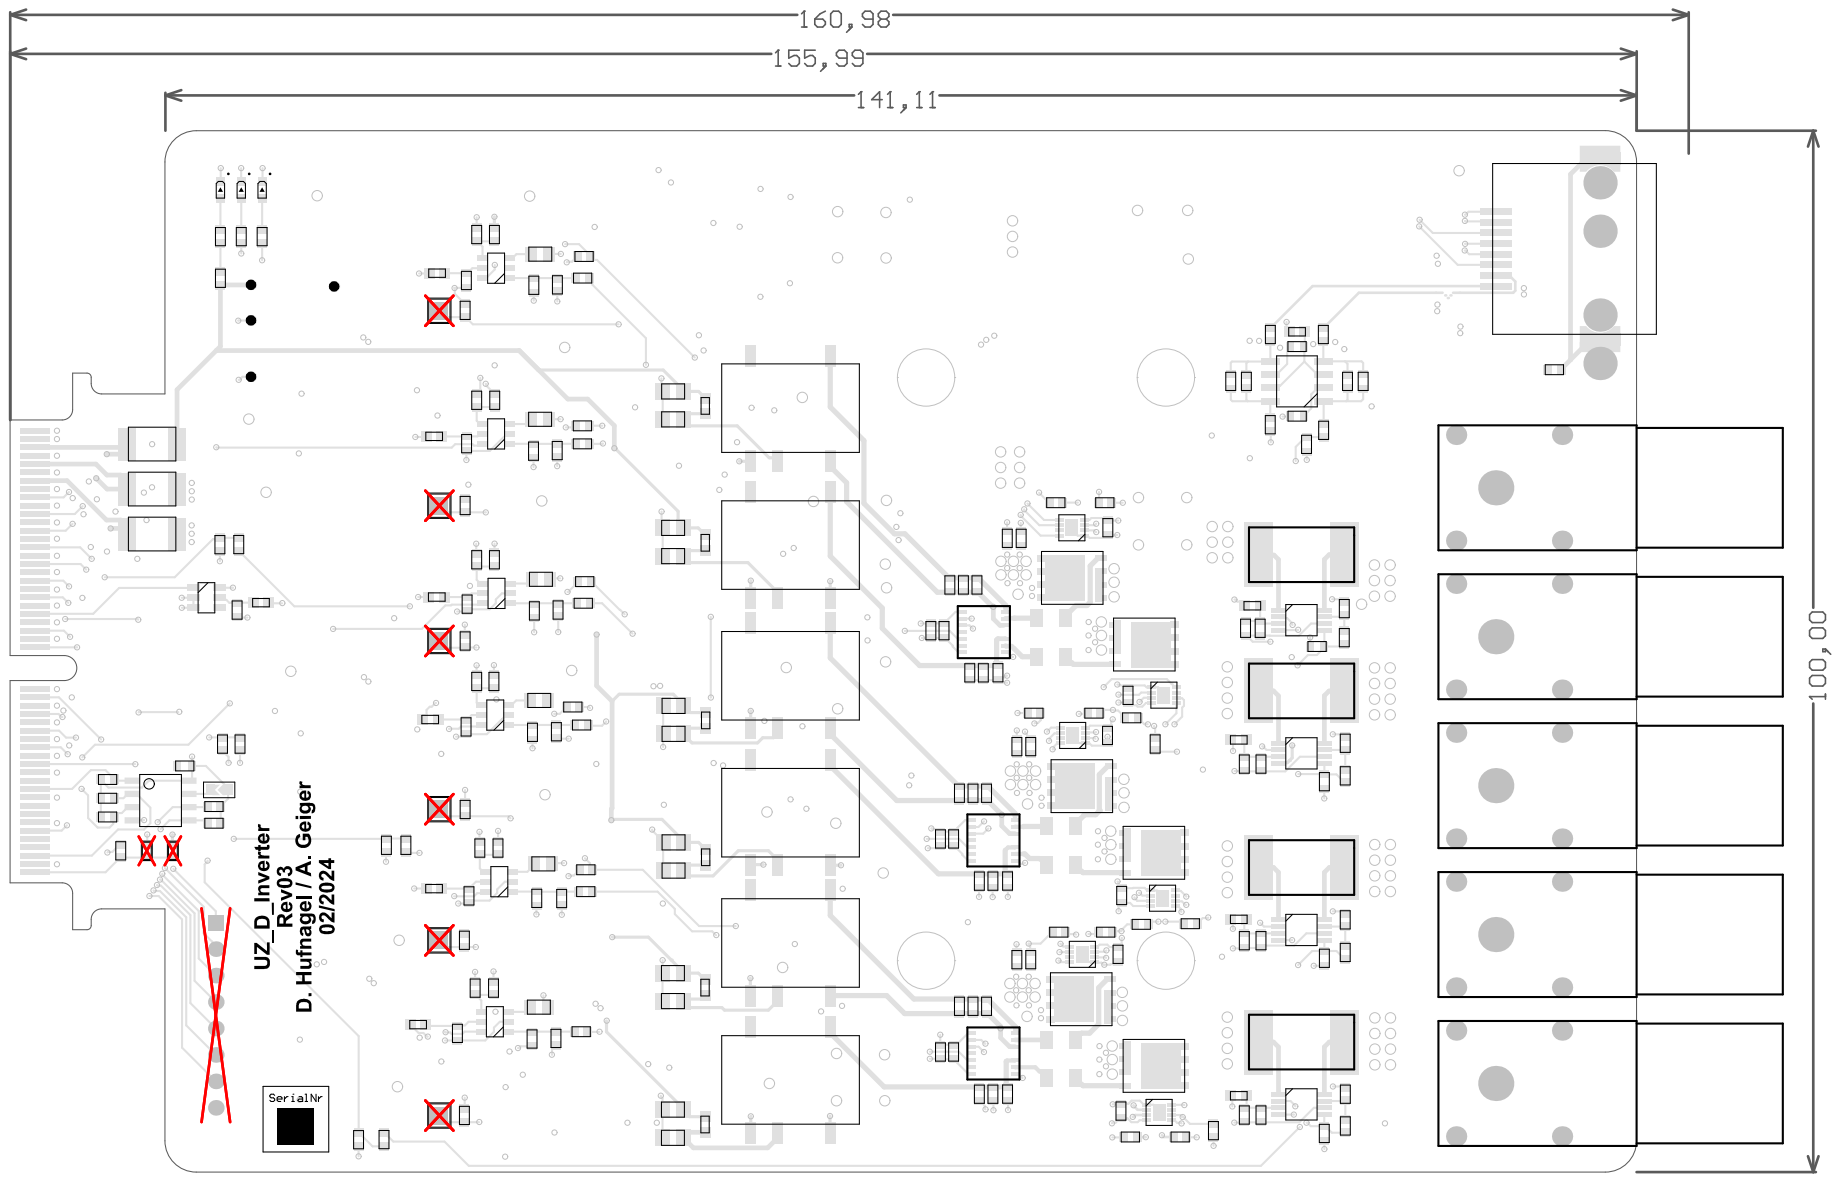
[picture p44: page 1]

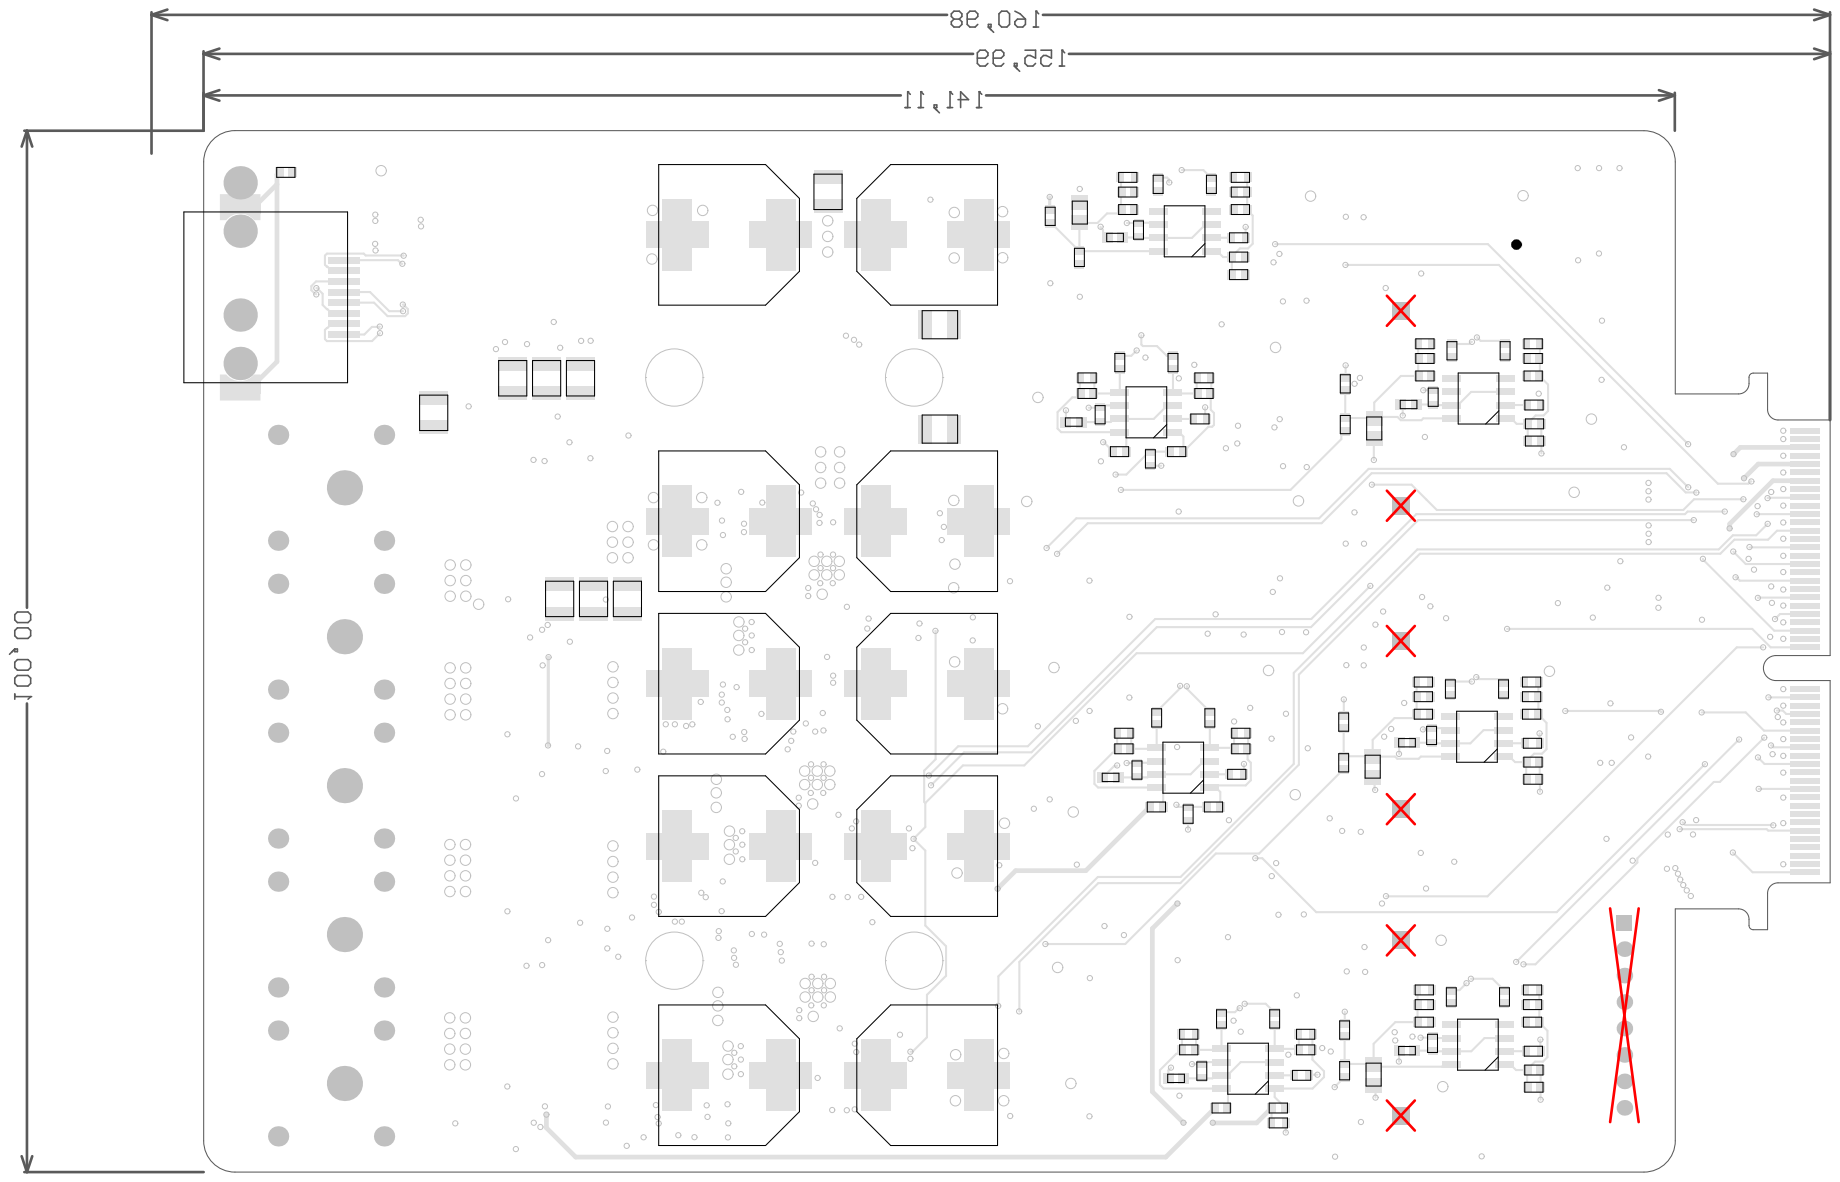
[picture p45: page 2]
