ultrazohm/uz_d_inverter/Project Outputs for UZ_D_Inverter/Rev03/PDF/3D_View_Bot_UZ_D_Inverter_Variant_V1_Rev03.PDF

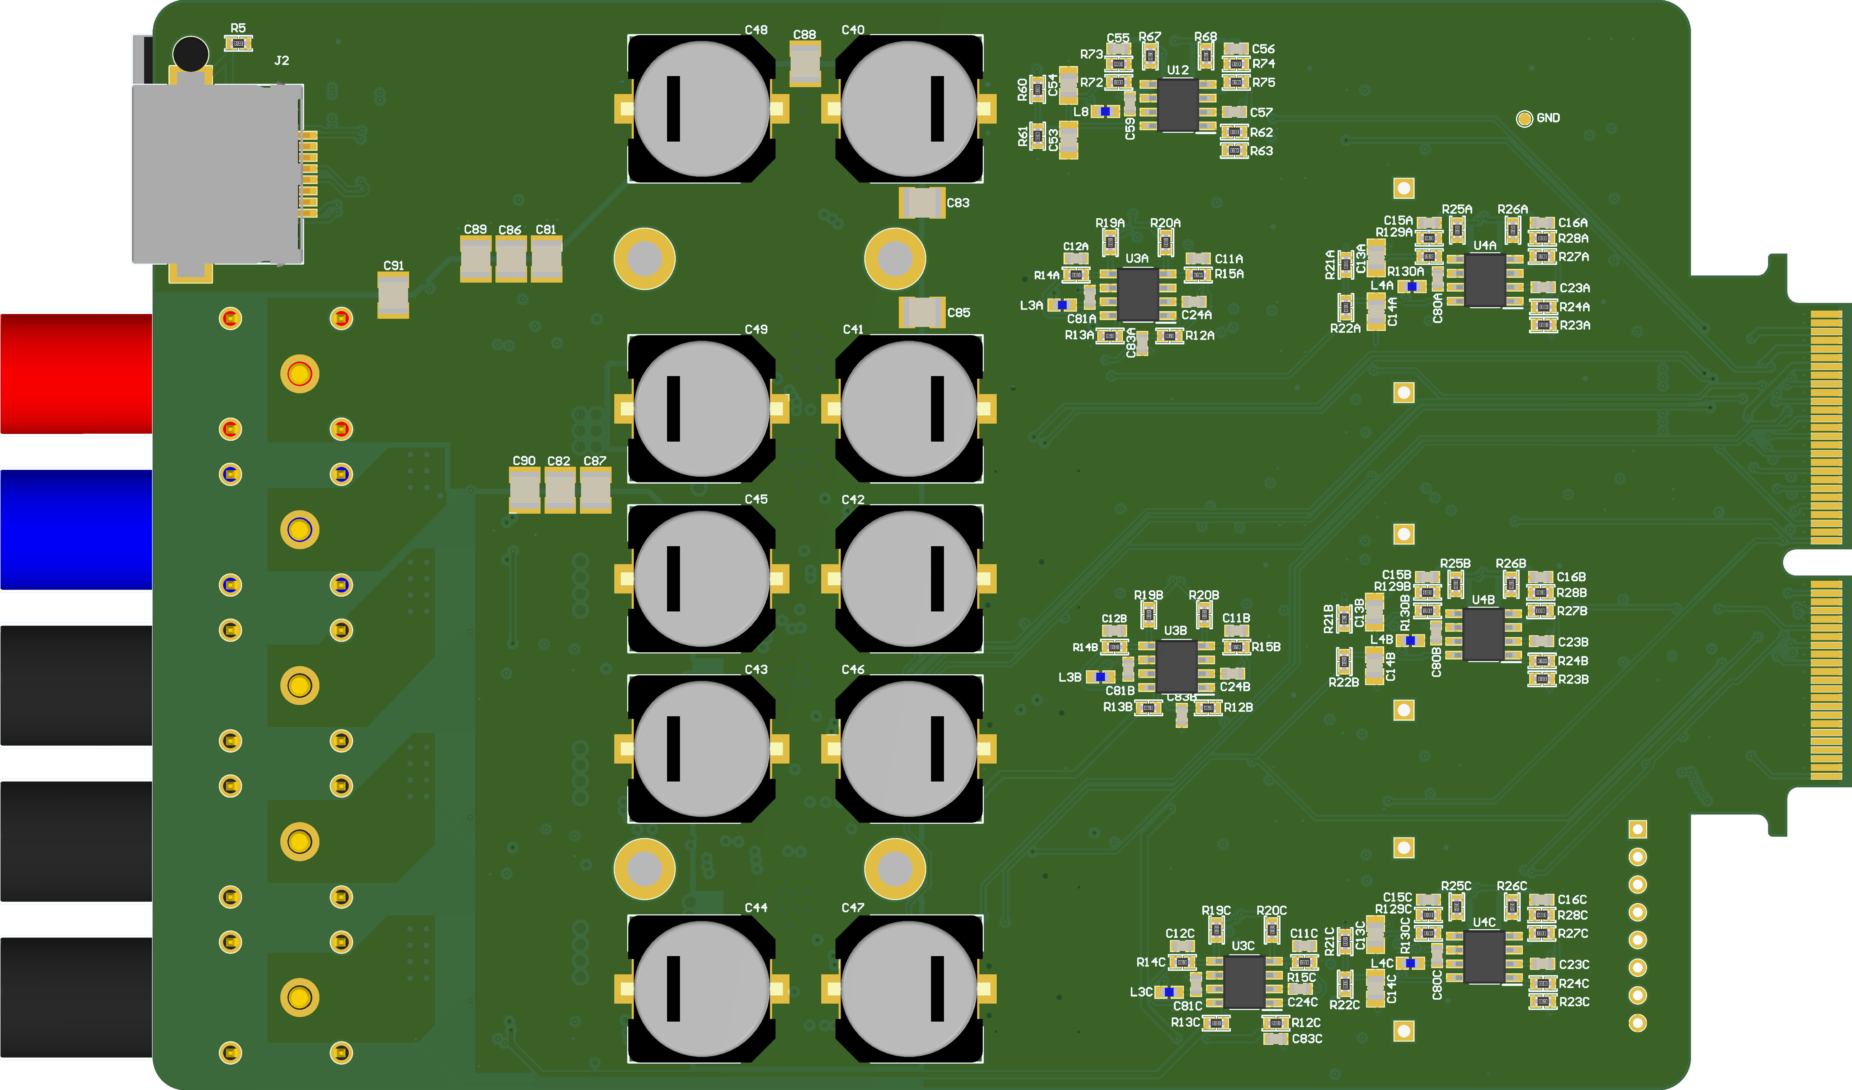
[picture p46: page 1]
