ultrazohm/uz_d_inverter/LTSpice_Simulation/CurrMeas.asc

C1: cap; 1µ
C2: cap; 22p
C3: cap; 22p
R3: res; 1k
R4: res; 2k
R5: res; 2k
R6: res; 1k
R7: res; 1k
U1: ADA4940
V1: voltage; 5
V2: voltage; SINE(2.5 2 50)
V3: voltage; 2.5
Named nets: 0, 5v, o+, o-, i+
.tran 20m
.ac dec 100 1 100k
