ultrazohm/uz_d_inverter/LTSpice_Simulation/VoltMeas.asc

C1: cap; 56p
C2: cap; 56p
C3: cap; 3.3n
C4: cap; 4.7n
C5: cap; 100n
R1: res; 110k
R2: res; 10k
R3: res; 110k
R4: res; 10k
R5: res; 110k
R6: res; 10k
R7: res; 110k
R8: res; 10k
R9: res; 1k
U1: ADA4940
V1: voltage; 5
V2: voltage; SINE(24 24 50)
Named nets: 0, 5v, o-, o+
.tran 20m
.ac dec 20m 10 100k
