ultrazohm/uz_d_inverter/(list of files, drawings)

Other design files:
2.5V_REF.SchDoc
Connectors.SchDoc
DC-Link-Caps.SchDoc
DC-link.SchDoc
DigitalCarrierJack.SchDoc
Halfbridges.SchDoc
Phase_Measurements.SchDoc
Temp_Measurements.SchDoc
TopSheet.SchDoc
UZ_D_Inverter.PcbDoc
UZ_D_Inverter.PrjPCB
UZ_D_Inverter_Template.PrjPCB
