ultrazohm/uz_d_inverter/(commit log)

2022-06-08 Renamed project to UZ_D_Inverter_Template
    [UZ_D_Inverter_Template.PcbDoc, UZ_D_Inverter_Template.PrjPCB]
2022-06-08 Adjusts pin mapping of main connector
    [DigitalCarrierJack.SchDoc]
2022-06-15 Added components to schematic
    [DigitalCarrierJack.SchDoc]
2022-06-27 Finishes pcb layout of template
    [Connectors.SchDoc, DigitalCarrierJack.SchDoc, TopSheet.SchDoc, UZ_D_Inverter_Template.PcbDoc, UZ_D_Inverter_Template.PrjPCB]
2022-06-27 small rearrangement
    [UZ_D_Inverter_Template.PrjPCB]
2022-06-28 Update cliff connetors & moved bottom ethernet connector to exact same place as in GaN board
    [Connectors.SchDoc, UZ_D_Inverter_Template.PcbDoc]
2022-06-29 Addressed criticism
    -used short designators
    -used power ports instead of nets
    -improved net harness
    [Connectors.SchDoc, DigitalCarrierJack.SchDoc, TopSheet.SchDoc, UZ_D_Inverter_Template.PcbDoc]
2022-07-08 Removed wrongly placed power port
    [Connectors.SchDoc, DigitalCarrierJack.SchDoc]
2022-07-08 Renamed project
    [UZ_D_Inverter.PcbDoc, UZ_D_Inverter.PrjPCB]
2022-07-13 Adds phase current measurement to schematic
    [Connectors.SchDoc, DigitalCarrierJack.SchDoc, Halfbridges.SchDoc, Reference.SchDoc, TopSheet.SchDoc, UZ_D_Inverter.PcbDoc, UZ_D_Inverter.PrjPCB]
2022-07-14 Finishes DC caps & DC-shut measurement
    [Connectors.SchDoc, DC-link.SchDoc, DigitalCarrierJack.SchDoc, Halfbridges.SchDoc, Phase_Measurements.SchDoc, TopSheet.SchDoc, UZ_D_Inverter.PrjPCB]
2022-07-19 Reworks sheets a bit. Now ueses the "repeat" function
    [Connectors.SchDoc, DC-link.SchDoc, Halfbridges.SchDoc, Phase_Measurements.SchDoc, TopSheet.SchDoc, UZ_D_Inverter.PrjPCB]
2022-07-20 Finished halfbridges
    [DC-link.SchDoc, DigitalCarrierJack.SchDoc, Halfbridges.SchDoc, Phase_Measurements.SchDoc, TopSheet.SchDoc, UZ_D_Inverter.PrjPCB]
2022-07-25 Finished first draft, review next
    [Connectors.SchDoc, DC-link.SchDoc, DigitalCarrierJack.SchDoc, Halfbridges.SchDoc, Phase_Measurements.SchDoc, Reference.SchDoc, TopSheet.SchDoc, UZ_D_Inverter.PrjPCB]
2022-07-27 Minor fixes
    [DC-link.SchDoc, Phase_Measurements.SchDoc]
2022-08-11 Fixes UZ-connector. OT signals are now on the FAULT pins of 600V-GaN
    [DigitalCarrierJack.SchDoc]
2022-08-11 addresses output resistor for reference voltage
    [DigitalCarrierJack.SchDoc, Reference.SchDoc]
2022-08-11 Addresses no current flowing through the current shunts
    [Connectors.SchDoc, Halfbridges.SchDoc, Phase_Measurements.SchDoc, TopSheet.SchDoc]
2022-08-11 Adds PullUP to OT signals
    [Phase_Measurements.SchDoc]
2022-08-11 Adds descriptions for temp-measurement voltages etc
    [Phase_Measurements.SchDoc]
2022-08-11 Fixes VCC for DC-link-current amplifier
    [DC-link.SchDoc]
2022-08-11 0V input of TOP DC/DC converter now connected to GNDA
    [Halfbridges.SchDoc]
2022-08-11 Defined individual nets for temp-measurement-pads for the mosfets
    [Phase_Measurements.SchDoc]
2022-08-11 Added schmitt-inverter for PWM_EN signal.
    [Connectors.SchDoc, DigitalCarrierJack.SchDoc, Halfbridges.SchDoc, Phase_Measurements.SchDoc, TopSheet.SchDoc]
2022-08-11 Addressed issue regarding VCOM for fully diff. OPAMPS
    [DC-link.SchDoc, Phase_Measurements.SchDoc]
2022-08-12 New gate resistor values
    [Halfbridges.SchDoc]
2022-08-16 Added some non-ERC to some pins
    [Halfbridges.SchDoc, Phase_Measurements.SchDoc]
2022-08-17 Added comments regarding OT and TEMP signals
    [DigitalCarrierJack.SchDoc]
2022-08-17 Changed all repeats to Repeats
    [TopSheet.SchDoc]
2022-08-17 Unified all sheet annotations
    [DC-link.SchDoc, Halfbridges.SchDoc, Phase_Measurements.SchDoc, Reference.SchDoc]
2022-08-17 Max DC link voltage stated besides the connectors now
    [Connectors.SchDoc]
2022-08-17 Added schmitt-inverter from halfbridges to digitalcarrierjack
    [Connectors.SchDoc, DigitalCarrierJack.SchDoc, Halfbridges.SchDoc, TopSheet.SchDoc]
2022-08-17 Changed multi-sheet numbering from A/B/C to 1/2/3
    [Connectors.SchDoc, Halfbridges.SchDoc, Phase_Measurements.SchDoc, TopSheet.SchDoc]
2022-08-17 Uses new Symbol for MOSFET. Give Phase_connectors its own extra netclass
    [Connectors.SchDoc, Halfbridges.SchDoc]
2022-08-17 Uses extra GND Plan for bottom switch
    [Halfbridges.SchDoc]
2022-08-17 Saved project
    [UZ_D_Inverter.PrjPCB]
2022-08-17 Adds unit for fg and voltage rating for voltage measurement resistors
    [DC-link.SchDoc, Phase_Measurements.SchDoc]
2022-08-17 Fixed designator of 2nd Mosfet
    [Halfbridges.SchDoc]
2022-08-17 Adds lowpass for DC-link shunt opamp
    [DC-link.SchDoc, DigitalCarrierJack.SchDoc, Halfbridges.SchDoc]
2022-08-17 Connects Source of Top-switch to GNDA pin of driver
    [Halfbridges.SchDoc]
2022-08-17 Adds description for lowpass
    [DC-link.SchDoc]
2022-08-17 Adds more description for dc-link lowpass
    [Halfbridges.SchDoc]
2022-08-17 SAve project file
    [UZ_D_Inverter.PrjPCB]
2022-08-18 Made comments about caps which should be placed close to ICs
    [DC-link.SchDoc, Halfbridges.SchDoc, Phase_Measurements.SchDoc]
2022-08-18 Updated THS4561 with new symbol
    [DC-link.SchDoc, Phase_Measurements.SchDoc]
2022-08-18 Disabled "pin has no driving source" warnings
    [DC-link.SchDoc]
2022-08-18 Improved differential pair notations
    [DC-link.SchDoc, Phase_Measurements.SchDoc]
2022-08-18 Adds 1 pin headers to the TRIP_TEST pin of the Temp-measurement-IC
    [Phase_Measurements.SchDoc, UZ_D_Inverter.PrjPCB]
2022-08-18 Replaced THS4561 with ADA4940. Added status Leds vor 24/5/3.3V
    [Connectors.SchDoc, DC-link.SchDoc, DigitalCarrierJack.SchDoc, Phase_Measurements.SchDoc]
2022-08-19 Replaced 100nF & elco for DC-link with new ones at mouser
    [Connectors.SchDoc, DC-link.SchDoc, Phase_Measurements.SchDoc]
2022-08-19 Replace 2.5V reference with one in stock at mouser
    [Reference.SchDoc]
2022-08-19 Replaces 10k 0.1% resistor with one in stock
    [DC-link.SchDoc, Phase_Measurements.SchDoc, Reference.SchDoc]
2022-08-19 Replaced 105k resistor with one in stock
    [Phase_Measurements.SchDoc]
2022-08-19 Replaces 280k resistor with one in stock
    [Phase_Measurements.SchDoc]
2022-08-19 Replaces 278k (was supposed to 287k) with 287k resistor
    [Phase_Measurements.SchDoc]
2022-08-19 REplaces 976k resistor with one in stock
    [Phase_Measurements.SchDoc]
2022-08-19 Replaced 182k resistor with one in stock
    [Phase_Measurements.SchDoc]
2022-08-19 New designator for some parts
    [DC-link.SchDoc, DigitalCarrierJack.SchDoc, Phase_Measurements.SchDoc]
2022-08-19 Adds order lists
    [Bestellliste_Farnell.xlsx, Bestellliste_Mouser.xlsx, UZ_D_Inverter.PrjPCB]
2022-08-22 Used 6-layer JLCPCB-templatle for PCB
    [UZ_D_Inverter.PcbDoc, UZ_D_Inverter.PrjPCB]
2022-08-22 Updated all parts with the current ones in the library
    [Connectors.SchDoc, DC-link.SchDoc, DigitalCarrierJack.SchDoc, Halfbridges.SchDoc, Phase_Measurements.SchDoc, Reference.SchDoc]
2022-08-22 Fixes pin-mapping of power connectors
    [Connectors.SchDoc, DC-link.SchDoc, DigitalCarrierJack.SchDoc, Halfbridges.SchDoc, Phase_Measurements.SchDoc, Reference.SchDoc]
2022-08-22 Fixed pin-layout of elco caps.
    [DC-link.SchDoc]
2022-08-22 Placed elcos on pcb
2022-08-22 Removes left ofter 51R1 resistance from voltage-measurement (not needed)
    [DC-link.SchDoc]
2022-08-22 Added current & voltage measurement parts to room
2022-08-23 Placed all current measurement parts
    [UZ_D_Inverter.PrjPCB]
2022-08-23 Placed all current measurement parts (now with the PCB file)
    [Halfbridges.SchDoc]
2022-08-24 Started to route the Phases-Connectors
    [DC-link.SchDoc]
2022-08-25 Added BoardOutlineClearence
    [Phase_Measurements.SchDoc, UZ_D_Inverter.PrjPCB]
2022-08-26 Replaced DC-current measurement parts
2022-08-26 Routed & arranged voltage measurement of V_DC
2022-08-26 Finished routing Phase 3 voltage measurement
2022-08-29 Routed current_meas2 room
2022-08-29 routed voltage_meas2
2022-08-29 Routed Voltage/Current measurement traces to ICs
2022-08-29 Routed all UZ-connector pins
2022-08-29 Routed 24V supply
2022-08-29 Routed 5V and 3V3 signals
2022-08-29 Finished first PCB draft
    [UZ_D_Inverter.PrjPCB]
2022-08-30 Added some more GND polygons
2022-08-30 Placed more GND vias at UZ connector
2022-09-19 Updated part list for mouser. Noted parts which got delivered
    [Bestellliste_Mouser.xlsx]
2022-09-19 Placed the 2 lower mounting holes (2 still more to be done)
2022-09-20 Added mounting holes / Fixed some overlay stuff
    [Connectors.SchDoc]
2022-09-21 Replaced C21A, since it was in the way of the heatsink
2022-09-21 Improved polygon of GND_TOP_A
2022-09-21 Improved polygon of GND_TOP_B
2022-09-21 Improved polygon of GND_TOP_C
2022-09-21 Added heatsink to 3d model.
2022-10-04 Adjusted sheet numbering
    [Connectors.SchDoc, DC-link.SchDoc, DigitalCarrierJack.SchDoc, Halfbridges.SchDoc, Phase_Measurements.SchDoc, Reference.SchDoc, TopSheet.SchDoc, UZ_D_Inverter.PrjPCB]
2022-10-04 Removed termination matching for OPAMPS
    [DC-link.SchDoc, Phase_Measurements.SchDoc]
2022-10-04 Improved readability of the schematics
    [Connectors.SchDoc, DC-link.SchDoc, DigitalCarrierJack.SchDoc, Halfbridges.SchDoc, Phase_Measurements.SchDoc, Reference.SchDoc]
2022-10-04 Added 100nF Caps to Reference Voltage
    [Reference.SchDoc]
2022-10-04 Adds 100nF 100V Filter C to phase current measurement
    [Phase_Measurements.SchDoc]
2022-10-04 Improved readability further
    [DC-link.SchDoc, Phase_Measurements.SchDoc, Reference.SchDoc]
2022-10-04 Fixed footprint of 100nF C
    [Phase_Measurements.SchDoc, Reference.SchDoc]
2022-10-04 Included new filter C for phase current measurement in pcb
    [Phase_Measurements.SchDoc]
2022-10-04 Added V_DC/-V_DC/Phases and 12V/Mosfet_Bot to Power Net Class.
    Increased clearence to 0.3mm for Power Net Class
    [Connectors.SchDoc, Halfbridges.SchDoc, Phase_Measurements.SchDoc]
2022-10-04 Tented power vias
2022-10-05 Added 2 decoupling C between VDC/GND at the TOP Mosfet
    [Halfbridges.SchDoc]
2022-10-05 Moved heatsink to the side of the pcb
2022-10-05 Replaced 3x 47nF Driver output Cs with 2x 100nF
    [Halfbridges.SchDoc]
2022-10-05 Save for latest commit
    [Halfbridges.SchDoc]
2022-10-06 New Placement for Mosfet/Halfbridges &Temp_Meas equipment
2022-10-07 Routed Phase C Halfbridge & Voltage& Current Meas
2022-10-07 Nearly done with halfbridge 2 and current&temp&voltage meas
2022-10-10 Routed 24V
2022-10-10 Repoured phase connector polygons. Poured halfbridge polys in layer 2
2022-10-11 Added some testpoints
    [DigitalCarrierJack.SchDoc, Halfbridges.SchDoc]
2022-10-12 Added test points for measurement signals
    [DC-link.SchDoc, DigitalCarrierJack.SchDoc, Phase_Measurements.SchDoc]
2022-10-12 untented some vias to access gnd
2022-10-13 suggestions for further changes as discussed in slack
    [Halfbridges.SchDoc, UZ_D_Inverter.PrjPCB]
2022-10-13 Adjusted layout of lower half bridge
    [UZ_D_Inverter.PrjPCB]
2022-10-13 Fixed top overlay & added more 100nF to 2V5
    [DC-link.SchDoc, Phase_Measurements.SchDoc]
2022-10-14 Added a shit ton of vias for better current flow
    [DigitalCarrierJack.SchDoc]
2022-10-14 Added UZ logo and info to PCB. Finale Rev01
    [TopSheet.SchDoc]
2022-10-17 Adjusted 6-layer Stackup to new one of JLCPCB
    [UZ_D_Inverter.PrjPCB]
2022-10-17 Include Gerber&NC Drill output files
    [UZ_D_Inverter.PrjPCB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]
2022-10-17 Changed 0.3mm->0.2mm trace width on top/bottom layer cuz of 2oz
2022-10-17 Reduced vias around Source of top Mosfet.
2022-10-17 Rearranged V_DC caps close to the mosfets
2022-10-17 Routed 2V5 on different layer underneath the Shunt resistors
2022-10-18 Rearranged current meas 1 components
2022-10-18 Rearranged current meas 2 components
2022-10-18 Rearranged current meas 3 components
2022-10-18 Rearranged voltage meas 1 components
2022-10-18 Rearranged voltage meas 2 components
2022-10-18 Rearranged voltage meas 3 components
2022-10-18 Adds 1 fuse each to the 24V, 5V and 3V3 input
    [DigitalCarrierJack.SchDoc]
2022-10-19 Added 6.8µH inductance to the 5V inputs of OPAMPS where ever possible
    [DC-link.SchDoc, DigitalCarrierJack.SchDoc, Phase_Measurements.SchDoc, Reference.SchDoc]
2022-10-19 Changed designators IC->u and J->X(where applicable))
    [DC-link.SchDoc, DigitalCarrierJack.SchDoc, Halfbridges.SchDoc, Phase_Measurements.SchDoc, Reference.SchDoc]
2022-10-19 Updated Gerber and NC Drill files
    [UZ_D_Inverter_Rev01.GBL, UZ_D_Inverter_Rev01.GBO, UZ_D_Inverter_Rev01.GBP, UZ_D_Inverter_Rev01.GBS, UZ_D_Inverter_Rev01.GM1, UZ_D_Inverter_Rev01.GTL, UZ_D_Inverter_Rev01.GTO, UZ_D_Inverter_Rev01.GTP]
2022-10-20 Small annotation changes
    [Halfbridges.SchDoc, Reference.SchDoc]
2022-11-17 Includes schematic & layout as pdf
2022-11-18 added temperature calculation from LM57 and LTC6992
    [LM57CISD-10_ANDLTC6992HS6-4_dutycyc_to_temperature.xlsx]
2022-11-28 Fixed OPAMP feedback loop
    [DC-link.SchDoc, DigitalCarrierJack.SchDoc, Phase_Measurements.SchDoc]
2022-11-28 Adjusted gain resistors for Voltage OPAMP. They now match the lowpass resistance
    [DC-link.SchDoc, Phase_Measurements.SchDoc]
2022-11-28 Connected GND_BOT of driver with GND. No floating potential for the bot-driver side anymore
    [DC-link.SchDoc, Halfbridges.SchDoc, Phase_Measurements.SchDoc, TopSheet.SchDoc]
2022-11-28 Removed 100nF Caps for filtering the shunt voltage for Phase measurements
    [Phase_Measurements.SchDoc]
2022-11-30 Replaced LMP8481 with MAX40056T for phase measurements
    [Phase_Measurements.SchDoc]
2022-11-30 Replaced LMP8481 with MAX40056T for DC-link
    [DC-link.SchDoc]
2022-11-30 Moved Temp-Measurement into its own sheet
    [Phase_Measurements.SchDoc, Temp_Measurements.SchDoc, TopSheet.SchDoc]
2022-11-30 Changed from Rev02->Rev01
    [Connectors.SchDoc, DC-link.SchDoc, DigitalCarrierJack.SchDoc, Halfbridges.SchDoc, Phase_Measurements.SchDoc, Reference.SchDoc, Temp_Measurements.SchDoc, TopSheet.SchDoc]
2022-12-01 Reorganize Phase_Measurement schematic
    [Phase_Measurements.SchDoc, Temp_Measurements.SchDoc]
2022-12-01 Adds OC protection for the 3 phases
    [DigitalCarrierJack.SchDoc, Phase_Measurements.SchDoc, TopSheet.SchDoc]
2022-12-01 Adds OCP for DC-link
    [DC-link.SchDoc, DigitalCarrierJack.SchDoc, Halfbridges.SchDoc, Phase_Measurements.SchDoc, TopSheet.SchDoc]
2022-12-01 Routed Phase C current-sense-OPAMP
    [Halfbridges.SchDoc]
2022-12-01 Routed Phace B current-sense-OPAMP
2022-12-02 Rearranged Phase C halfbridge to be more compact
    [Halfbridges.SchDoc, UZ_D_Inverter.PrjPCB]
2022-12-02 Routed Phase C Voltage&Current Measurement
2022-12-02 Routed Phace B Voltage&Current Measurement
2022-12-05 Removes unnecessary test point
    [Halfbridges.SchDoc]
2022-12-08 Removes some test points
    [Halfbridges.SchDoc]
2022-12-08 Routed HB2
    [UZ_D_Inverter.PrjPCB]
2022-12-12 Adds voltage divider to scale OC_P signal from 5V->3V3
    [Phase_Measurements.SchDoc]
2022-12-12 Switched temp measurement Vcc to 3V3 so that all outputs are max 3V3
    [Temp_Measurements.SchDoc]
2022-12-12 Added voltage divider to OC_DC out signal to scale form 5V->3V3
    [DC-link.SchDoc, Phase_Measurements.SchDoc, Temp_Measurements.SchDoc]
2022-12-12 Replaced 3k92 for OCP setting with 3k88
    [DC-link.SchDoc, Phase_Measurements.SchDoc]
2022-12-12 Swapped differential N/P declaration in line with ada datasheet
    [DC-link.SchDoc, Phase_Measurements.SchDoc]
2022-12-12 Replaced ADA4940 symbol with new one
    [DC-link.SchDoc, Phase_Measurements.SchDoc]
2022-12-13 Adds GND Keepout beneath switching node
2022-12-14 Routed more OPAmps
    [Phase_Measurements.SchDoc]
2022-12-14 Fixes OPAMP connections. Output signal shouldn't be inverted anymore
    [DC-link.SchDoc, Phase_Measurements.SchDoc]
2022-12-14 Made all 100nF Cs of 1 type
    [DC-link.SchDoc, DigitalCarrierJack.SchDoc, Phase_Measurements.SchDoc]
2022-12-14 Fixed designator on SchmittTrigger C
    [DigitalCarrierJack.SchDoc]
2022-12-14 Routed most of the signals. differentials to go
    [DigitalCarrierJack.SchDoc]
2022-12-14 Polygon pours for banana connectors
2022-12-15 Fixed LED brightness
    [DigitalCarrierJack.SchDoc]
2022-12-15 Improved TopSheet visibility
    [TopSheet.SchDoc]
2022-12-15 Improve schematic readability regarding 0.1% commets
    [DC-link.SchDoc, Halfbridges.SchDoc, Phase_Measurements.SchDoc]
2022-12-15 Small improvements to routing
    [Temp_Measurements.SchDoc]
2022-12-15 Small changes before Review
    [UZ_D_Inverter.PrjPCB]
2022-12-15 Adds some GND vias
2022-12-15 Improved GND layers underneath banana connectors
2022-12-16 Improved I_DC-current OPAMP routing
2022-12-19 Fixes wrong GND connection
2022-12-19 Improved Bot GND polygon around the Caps
2022-12-19 Removed unnecessary voltage ratings. Unified all 100nF Cs to 1 type
    [DC-link.SchDoc, Halfbridges.SchDoc, Phase_Measurements.SchDoc, Reference.SchDoc, Temp_Measurements.SchDoc]
2022-12-19 Unified the 10nF caps
    [BOM_UZ_D_Inverter_[No Variations]_Rev02.xlsx, Halfbridges.SchDoc]
2022-12-20 Replaced Fuse with similiar one, cuz i ordered a different one. No significant changes tho
    [DigitalCarrierJack.SchDoc, UZ_D_Inverter.PrjPCB]
2022-12-21 Fixes wrong voltage level in comment
    [DigitalCarrierJack.SchDoc]
2022-12-21 Improved layer 2 GND polygon underneath the shunts
2022-12-21 Replaced 3k88 0.1% with cheaper 3k9 1% resistor
    [DC-link.SchDoc, Phase_Measurements.SchDoc]
2022-12-21 Adds unused DIG_IO_XX Channels to 8-pin Header
    [DigitalCarrierJack.SchDoc]
2022-12-21 Added new 3k9 Rs and 8-pin header to PCB
    [Phase_Measurements.SchDoc]
2022-12-21 Fixed footprint Pin1 marking for U2
    [Phase_Measurements.SchDoc]
2022-12-21 improved routing of GND_TOPx net
2022-12-21 Added some additional 10µF C to the V_DC->GND
    [DC-Link-Caps.SchDoc, DC-link.SchDoc, TopSheet.SchDoc]
2022-12-21 Improved 2.5V net routing
2022-12-21 safe project file
    [UZ_D_Inverter.PrjPCB]
2022-12-22 Added 3 more 10µF MLCCs
    [DC-Link-Caps.SchDoc]
2022-12-22 Replaced 10µF for ref-voltage with the ones used in the DC-link
    [Reference.SchDoc]
2022-12-22 Improved Signal layer 1 switch note polygon
2022-12-22 Improved some comments in the schematic
    [DC-link.SchDoc, Halfbridges.SchDoc, Phase_Measurements.SchDoc, Temp_Measurements.SchDoc]
2022-12-22 Adds gerber/drill files for finished Rev02
    [UZ_D_Inverter_Rev02.GBL, UZ_D_Inverter_Rev02.GBO, UZ_D_Inverter_Rev02.GBP, UZ_D_Inverter_Rev02.GBS, UZ_D_Inverter_Rev02.GM1, UZ_D_Inverter_Rev02.GTL, UZ_D_Inverter_Rev02.GTO, UZ_D_Inverter_Rev02.GTP]
2022-12-23 Small improvements to Banana connector polygons
2022-12-23 Updated Gerber&Drill Files
    [UZ_D_Inverter_Rev02.GBL, UZ_D_Inverter_Rev02.GBO, UZ_D_Inverter_Rev02.GBP, UZ_D_Inverter_Rev02.GBS, UZ_D_Inverter_Rev02.GM1, UZ_D_Inverter_Rev02.GTL, UZ_D_Inverter_Rev02.GTO, UZ_D_Inverter_Rev02.GTP]
2022-12-23 Updated gerber&drill files with signal layers
    [UZ_D_Inverter_Rev02.GBL, UZ_D_Inverter_Rev02.GBO, UZ_D_Inverter_Rev02.GBP, UZ_D_Inverter_Rev02.GBS, UZ_D_Inverter_Rev02.GM1, UZ_D_Inverter_Rev02.GTL, UZ_D_Inverter_Rev02.GTO, UZ_D_Inverter_Rev02.GTP]
2022-12-27 Removed GND polygon around the gold fingers
    [UZ_D_Inverter_Rev02.GBL, UZ_D_Inverter_Rev02.GBO, UZ_D_Inverter_Rev02.GBP, UZ_D_Inverter_Rev02.GBS, UZ_D_Inverter_Rev02.GM1, UZ_D_Inverter_Rev02.GTL, UZ_D_Inverter_Rev02.GTO, UZ_D_Inverter_Rev02.GTP]
2023-02-09 Updates Gerber&BOM&Place&Drill
    [BOM_UZ_D_Inverter_[No Variations]_Rev02.xlsx, Pick_and_Place_UZ_D_Inverter_[No Variations]_Rev02.csv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]
2023-02-15 Messung REf-Quelle Einschaltmoment
    [scope_210.csv, scope_211.csv]
2023-03-02 Updated schematic pdf
2023-03-21 Added all 2.5V Ref components & Gate-Resistors to not fitted
    They will not be used in Ref02, therefore they will be removed from the variant
    [Reference.SchDoc, UZ_D_Inverter.PrjPCB]
2023-03-21 Removes diode resistors from variant
    [UZ_D_Inverter.PrjPCB]
2023-04-17 Adds LTSpice simulation for the current and voltage measurement
2023-04-17 Fixes issues from Rev02
    [DC-link.SchDoc, DigitalCarrierJack.SchDoc, Halfbridges.SchDoc, Phase_Measurements.SchDoc, Reference.SchDoc, TopSheet.SchDoc]
2023-04-17 Fixes some comments in the schematic
    [DC-link.SchDoc, Phase_Measurements.SchDoc, UZ_D_Inverter.PrjPCB]
2023-04-17 Changes version to Rev03 in project options & moves heatsink to proper place
    [UZ_D_Inverter.PrjPCB]
2023-04-17 Adds Rev03 outputs
    [UZ_D_Inverter.PrjPCB, UZ_D_Inverter.xlsx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]
2023-04-17 adjusts variant
    [UZ_D_Inverter.PrjPCB]
2023-05-04 Small fixes in schematic regarding OCP description
    [DC-link.SchDoc, Phase_Measurements.SchDoc, UZ_D_Inverter.PrjPCB]
2023-05-09 Fixes distance between mounting holes
    [UZ_D_Inverter_Rev03.GBL, UZ_D_Inverter_Rev03.GBO, UZ_D_Inverter_Rev03.GBP, UZ_D_Inverter_Rev03.GBS, UZ_D_Inverter_Rev03.GM1, UZ_D_Inverter_Rev03.GTL, UZ_D_Inverter_Rev03.GTO, UZ_D_Inverter_Rev03.GTP]
2023-06-15 Fixes frequency response for Voltage measurement
    [DC-link.SchDoc, Phase_Measurements.SchDoc, UZ_D_Inverter.xlsx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]
2024-02-21 add EEPROM
    [DigitalCarrierJack.SchDoc, UZ_D_Inverter.PrjPCB]
2024-02-21 change LTC6992HS6-4 to LTC6992CS6-1
    [Temp_Measurements.SchDoc]
2024-02-21 bom für bauteileinkauf mit neuen lcsc nummern
    [BOM_UZ_D_Inverter_Variant_V1_Rev03_ZC.xlsx]
2024-02-21 routing of EEPROM; change 100 nF parts to LCSC part number
    [DC-link.SchDoc, DigitalCarrierJack.SchDoc, Halfbridges.SchDoc, Phase_Measurements.SchDoc, Temp_Measurements.SchDoc, TopSheet.SchDoc, UZ_D_Inverter.PrjPCB]
2024-02-21 change 10 nF to C136131
    [DC-link.SchDoc, Halfbridges.SchDoc, Phase_Measurements.SchDoc, Temp_Measurements.SchDoc, UZ_D_Inverter.PrjPCB]
2024-02-21 change C and D to LCSC parts
    [DC-Link-Caps.SchDoc, DC-link.SchDoc, DigitalCarrierJack.SchDoc, Halfbridges.SchDoc, Phase_Measurements.SchDoc, UZ_D_Inverter.PrjPCB]
2024-02-21 change RJ45 from Wuerth to TE
    [Connectors.SchDoc, DigitalCarrierJack.SchDoc]
2024-02-21 change J and L parts to LCSC part numbers
    [Connectors.SchDoc, DC-link.SchDoc, DigitalCarrierJack.SchDoc, Halfbridges.SchDoc, Phase_Measurements.SchDoc, Temp_Measurements.SchDoc, UZ_D_Inverter.PrjPCB]
2024-02-21 change PS parts to LCSC part numbers
    [Halfbridges.SchDoc, UZ_D_Inverter.PrjPCB]
2024-02-21 change Q parts to LCSC part numbers
    [Halfbridges.SchDoc, UZ_D_Inverter.PrjPCB]
2024-02-21 change R parts to LCSC part numbers
    [DC-link.SchDoc, DigitalCarrierJack.SchDoc, Halfbridges.SchDoc, Phase_Measurements.SchDoc, Temp_Measurements.SchDoc, UZ_D_Inverter.PrjPCB]
2024-02-21 change U parts to LCSC part numbers
    [DC-link.SchDoc, DigitalCarrierJack.SchDoc, Halfbridges.SchDoc, Phase_Measurements.SchDoc, Temp_Measurements.SchDoc, UZ_D_Inverter.PrjPCB]
2024-02-21 generate new BOM
    [BOM_JLC_UZ_D_Inverter_Variant_V1_Rev03.xlsx]
2024-02-22 solved Issue #6 (Filter of Phase Voltage Measurement) by changing 10 nF filter cap to 56 pF
    [DC-link.SchDoc, Phase_Measurements.SchDoc, UZ_D_Inverter.PrjPCB]
2024-02-22 BOM generation
    [BOM_JLC_UZ_D_Inverter_Variant_V1_Rev03.xlsx]
2024-03-05 small changes in LCSC numbers and some parts, like shunt
    [Connectors.SchDoc, DC-Link-Caps.SchDoc, DC-link.SchDoc, DigitalCarrierJack.SchDoc, Phase_Measurements.SchDoc, Temp_Measurements.SchDoc, UZ_D_Inverter.PrjPCB]
2024-03-05 change shunt resistor to library part
    [Phase_Measurements.SchDoc, UZ_D_Inverter.PrjPCB]
2024-03-07 add bom and pick and place file
    [BOM_JLC_UZ_D_Inverter_Variant_V1_Rev03.xlsx, Pick_and_Place_UZ_D_Inverter_Variant_V1_Rev03.csv]
2024-03-07 adding boms
    [BOM_UZ_D_Inverter_Variant_V1_Rev03.xlsx, BOM_UZ_D_Inverter_Variant_V1_Rev03_ZC.xlsx]
2024-03-07 production files Rev03
    [UZ_D_Inverter_Rev03.GBL, UZ_D_Inverter_Rev03.GBO, UZ_D_Inverter_Rev03.GBP, UZ_D_Inverter_Rev03.GBS, UZ_D_Inverter_Rev03.GM1, UZ_D_Inverter_Rev03.GTL, UZ_D_Inverter_Rev03.GTO, UZ_D_Inverter_Rev03.GTP]
2024-03-07 add schematic and assembly drawing
2024-06-11 Add current amplifier to phase_measurement and low impedance _halfbridge
    [Halfbridges.SchDoc, Phase_Measurements.SchDoc]
2024-06-12 Add DC_link capes
    [DC-Link-Caps.SchDoc, Halfbridges.SchDoc]
2024-06-12 Revert "Add DC_link capes"
    This reverts commit 508094544aaeb461fe85ce562a91723a6abb6d50.
    [DC-Link-Caps.SchDoc, Halfbridges.SchDoc]
2024-06-12 Adding DC_Link Capes and DC_link I measurement IC
    [DC-Link-Caps.SchDoc, DC-link.SchDoc]
2024-06-21 updating schametics
    [Connectors.SchDoc, DC-Link-Caps.SchDoc, DC-link.SchDoc, DigitalCarrierJack.SchDoc, Halfbridges.SchDoc, Phase_Measurements.SchDoc, Temp_Measurements.SchDoc, TopSheet.SchDoc]
2024-06-27 Adding 2.5V reference voltage IC for INA24
    [DC-link.SchDoc, Phase_Measurements.SchDoc]
2024-06-28 Adding 2.5V_REF IC and replace INA
    [2.5V_REF.SchDoc, Connectors.SchDoc, DC-Link-Caps.SchDoc, DC-link.SchDoc, DigitalCarrierJack.SchDoc, Halfbridges.SchDoc, Phase_Measurements.SchDoc, Temp_Measurements.SchDoc]
2024-07-19 Stage_01 with added 2.5Ref IC
    [2.5V_REF.SchDoc, Connectors.SchDoc, DC-Link-Caps.SchDoc, DC-link.SchDoc, DigitalCarrierJack.SchDoc, Halfbridges.SchDoc, Phase_Measurements.SchDoc, Temp_Measurements.SchDoc]
2024-07-31 REV02 without review
    [UZ_D_Inverter.PrjPCB]
2024-08-05 Change REV_NO to 04
    [TopSheet.SchDoc, UZ_D_Inverter.PrjPCB]
2024-08-05 Adds BOM
    [2.5V_REF.SchDoc, BOM_UZ_D_Inverter_Variant_V1_Rev04.xlsx, DigitalCarrierJack.SchDoc]
2024-08-05 change diode BAT165E6327HTSA1 to BAT 165 E6327
    [Halfbridges.SchDoc]
2024-08-06 REV04_After Modification
    [Halfbridges.SchDoc, UZ_D_Inverter.PrjPCB]
2024-08-07 Adds some comments to BOM. Parts have been ordered
    [BOM_UZ_D_Inverter_Variant_V1_Rev04.xlsx]
2024-08-13 WIP on Krunal
    [BOM_UZ_D_Inverter_Variant_V1_Rev04.xlsx, BOM_UZ_D_Inverter_Variant_V1_Rev04_ordering_overview.xlsx]
2024-08-13 REV04_Upadating_C8 from 2.5_REV
    [2.5V_REF.SchDoc]
2024-08-16 REV05_placing Half bridge
    [Halfbridges.SchDoc]
2024-08-24 Power stage placement ready for review
2024-09-04 Removing Low side Temp ICs
    [DigitalCarrierJack.SchDoc, Halfbridges.SchDoc, UZ_D_Inverter.PrjPCB]
2024-09-06 REV05_Adding C1718809 and C1720876 gate turn on and off resistors
    [Halfbridges.SchDoc, Temp_Measurements.SchDoc, TopSheet.SchDoc]
2024-09-11 Completion of REV04
    [Temp_Measurements.SchDoc, UZ_D_Inverter.PrjPCB]
2024-09-11 adds output file
    [UZ_D_Inverter.PrjPCB]
2024-09-11 adds production files
    [BOM_JLC_UZ_D_Inverter_Variant_V1_Rev04.xlsx, BOM_UZ_D_Inverter_Variant_V1_Rev04_ordering_overview.xlsx, Pick_and_Place_UZ_D_Inverter_Variant_V1_Rev04.csv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]
2024-09-12 REV04 Change the desige rule and fixed the errors
    [BOM_JLC_UZ_D_Inverter_Variant_V1_Rev04.xlsx, Pick_and_Place_UZ_D_Inverter_Variant_V1_Rev04.csv, UZ_D_Inverter.PrjPCB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]
2024-09-12 update production files
    [BOM_JLC_UZ_D_Inverter_Variant_V1_Rev04.xlsx, Pick_and_Place_UZ_D_Inverter_Variant_V1_Rev04.csv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]
2024-09-13 updates order parts xlsx
    [BOM_UZ_D_Inverter_Variant_V1_Rev04_ordering_overview.xlsx]
2024-09-13 REV04_set clearnce rule to all net
    [UZ_D_Inverter.PrjPCB]
2024-09-14 REV04 fixing error cause by clearnce
    [UZ_D_Inverter.PrjPCB]
2024-09-16 new production files
    [BOM_JLC_UZ_D_Inverter_Variant_V1_Rev04.xlsx, Pick_and_Place_UZ_D_Inverter_Variant_V1_Rev04.csv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]
2024-09-16 Updating current meas LTspice simulation
2024-09-16 swap input bias of Diffrential OPAMP (+)2.5ref and (-)I_OUT
    [Phase_Measurements.SchDoc]
2024-09-16 swap input bias of Diffrential OPAMP (+)2.5ref and (-)I_OUT in DC-link.SchDoc
    [DC-link.SchDoc]
2024-09-16 REV04 inverting INA241
    [DC-link.SchDoc, Phase_Measurements.SchDoc]
2024-09-17 REV04_Inverting gate driver ICs
2024-09-17 REV04_Inverting LTC69 for temp meas_3
    [UZ_D_Inverter.PrjPCB]
2024-09-18 fixes some comments
    [DC-link.SchDoc, Phase_Measurements.SchDoc]
2024-09-18 some fixes to vias & overlay
    [DigitalCarrierJack.SchDoc, UZ_D_Inverter.PrjPCB]
2024-09-19 production files
    [BOM_JLC_UZ_D_Inverter_Variant_V1_Rev04.xlsx, Pick_and_Place_UZ_D_Inverter_Variant_V1_Rev04.csv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]
2024-09-23 update to bom
    [BOM_UZ_D_Inverter_Variant_V1_Rev04_ordering_overview.xlsx]
2025-04-07 clean up of schematic comments etc
    [2.5V_REF.SchDoc, DC-link.SchDoc, DigitalCarrierJack.SchDoc, Halfbridges.SchDoc, Phase_Measurements.SchDoc, Temp_Measurements.SchDoc, TopSheet.SchDoc]
2025-04-07 Adds schematic pdf
